shostakovichs-spacecraft-factory/cansat-2018-2019/research/serial-port-linux/uart-test/image.jpeg

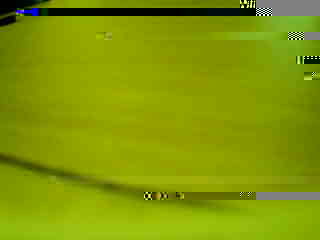
research/serial-port-linux/uart-test/image.jpeg
