shostakovichs-spacecraft-factory/cansat-2018-2019/doc/ПЗ-приложение-1-схемы.odt

СОГЛАСОВАНО | УТВЕРЖДАЮ
___________________________ | ___________________________
должность, головной исполнитель ОКР | должность, заказчик
___________________________ | ___________________________
подпись, инициалы, фамилия | подпись, инициалы, фамилия
«___»____________________ 20___г. | «___»____________________ 20___г.

СТРАТОСФЕРНЫЙ ЗОНД

СО СПЕКТРОМЕТРИЧЕСКОЙ УСТАНОВКОЙ

«ШМЕЛЬ»

Приложение к пояснительной записке 1

Принципиальные электрические схемы

Команда «ЗиКЮШ»

Данное приложение содержит принципиальные электрические схемы панелей разрабатываемого стратосферного зонда. В том числе:

- принципиальная электрическая схема панели 1. Camera Control Unit (рисунок 1)
- принципиальная электрическая схема панели 2. Interfacec Control Unit (рисунок 2)
- принципиальная электрическая схема панели 3. Power Control Unit (рисунок 3);
- принципиальная электрическая схема панели 4. Sensors Control Unit (рисунок 4).

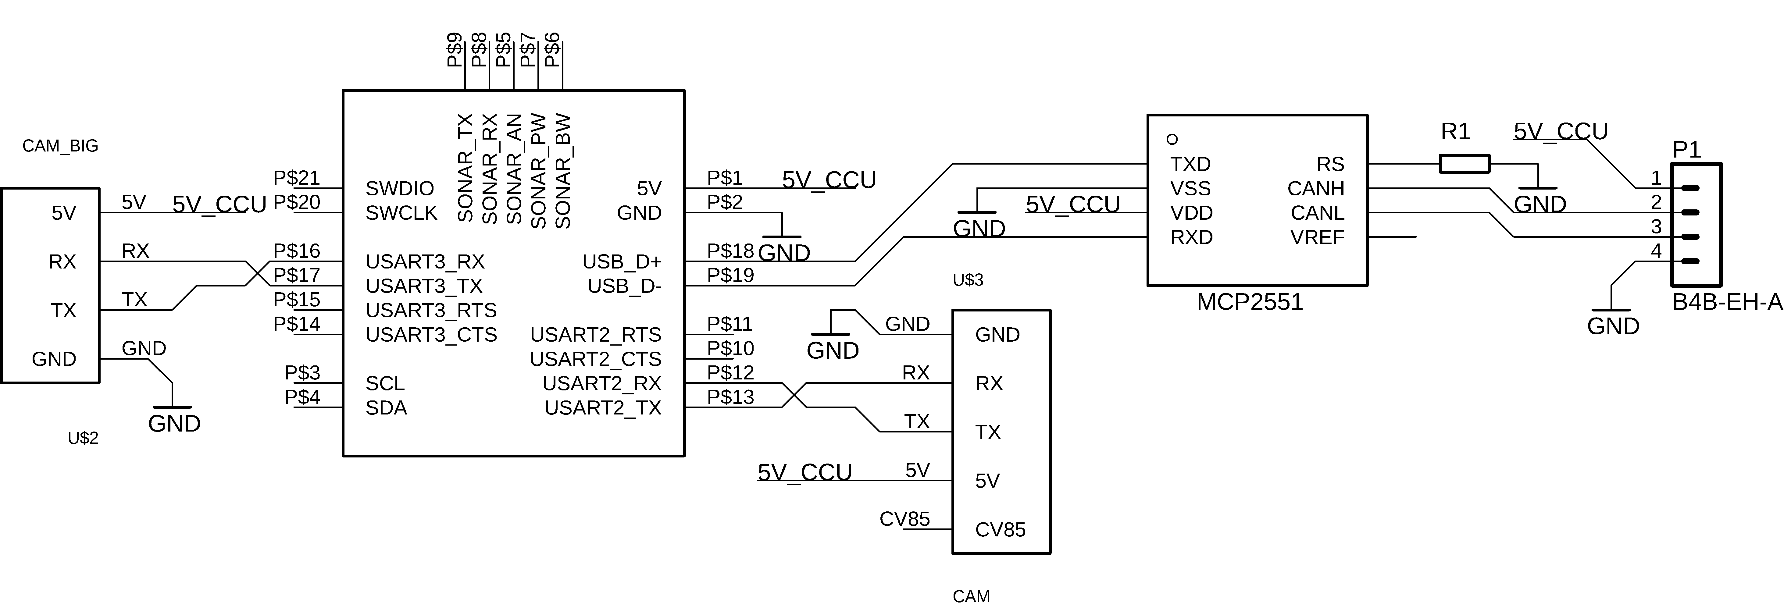
[picture p3: figure]

Рисунок 1. Принципиальная электрическая схема панели 1. Camera Control Unit (CCU).

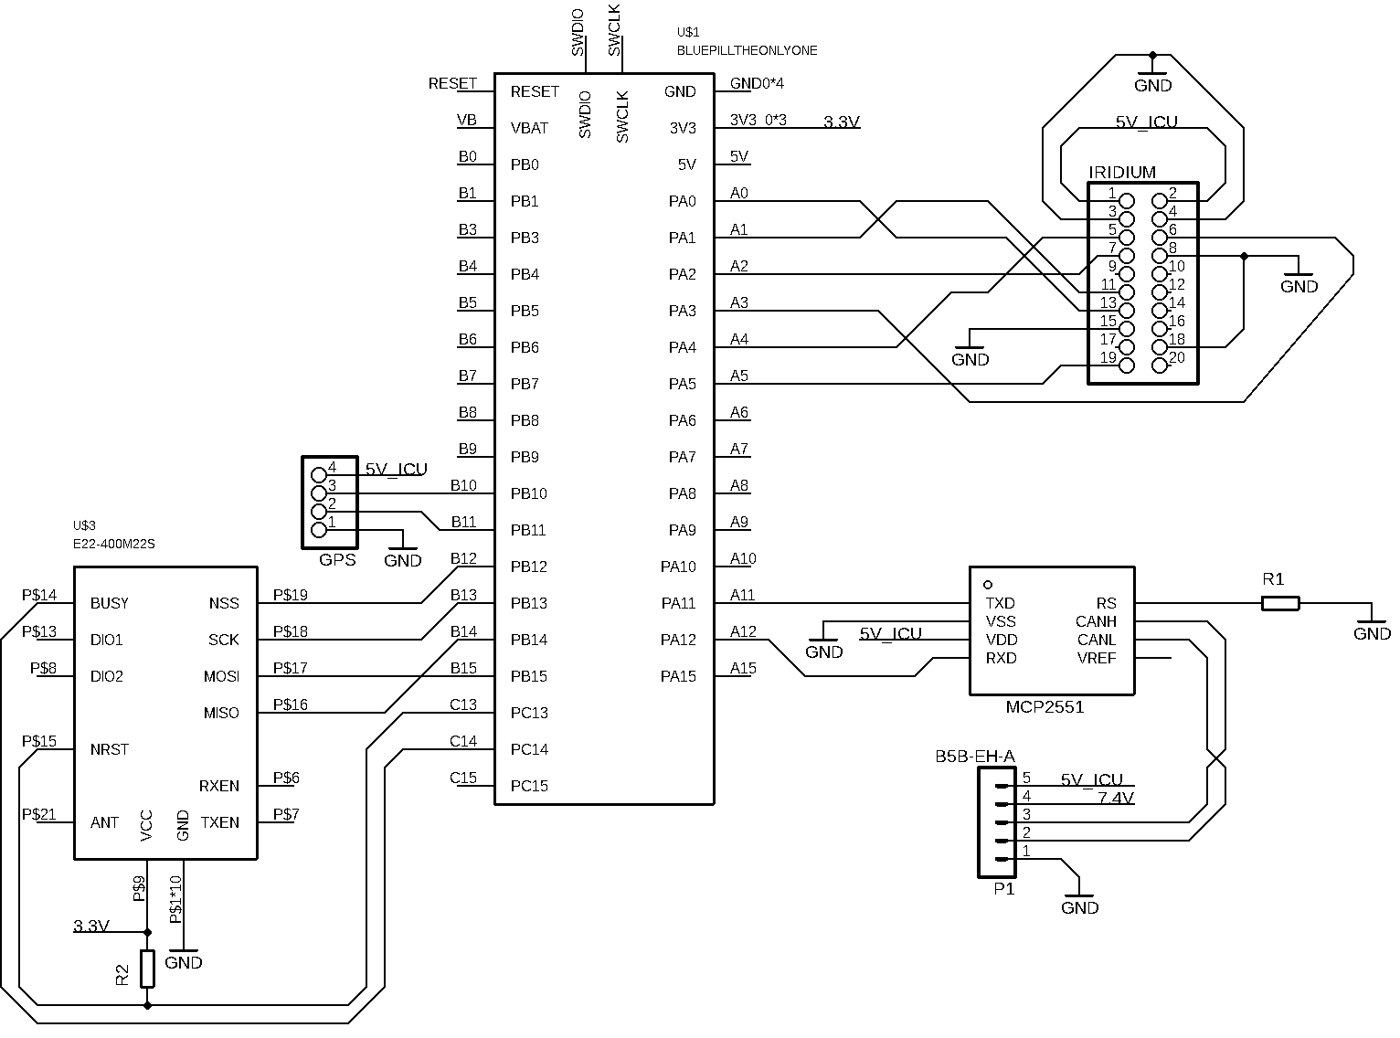
[picture p4: figure]

Рисунок 2. Принципиальная электрическая схема панели 2. Interface Control Unit (ICU).

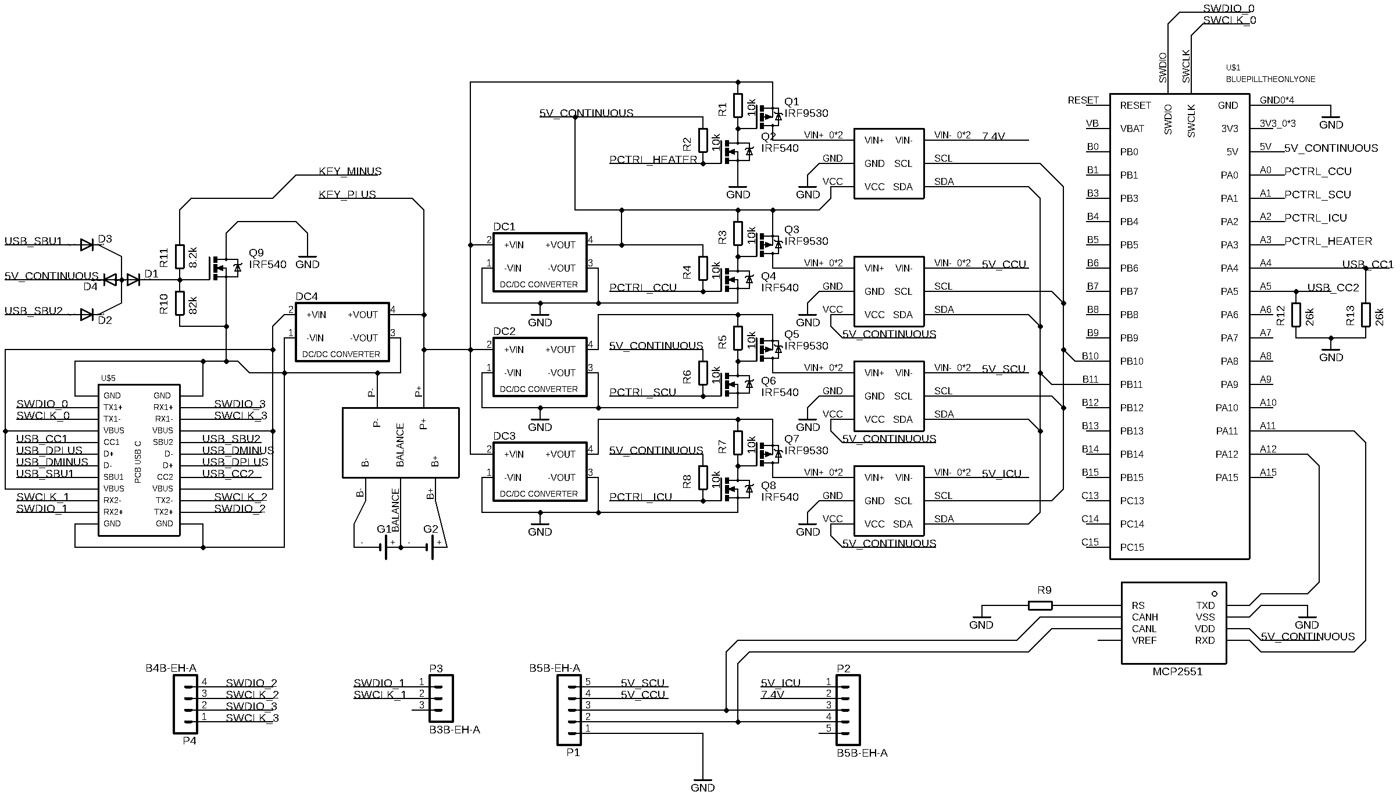
[picture p5: figure]

Рисунок 3. Принципиальная электрическая схема панели 3. Power Control Unit (PCU).

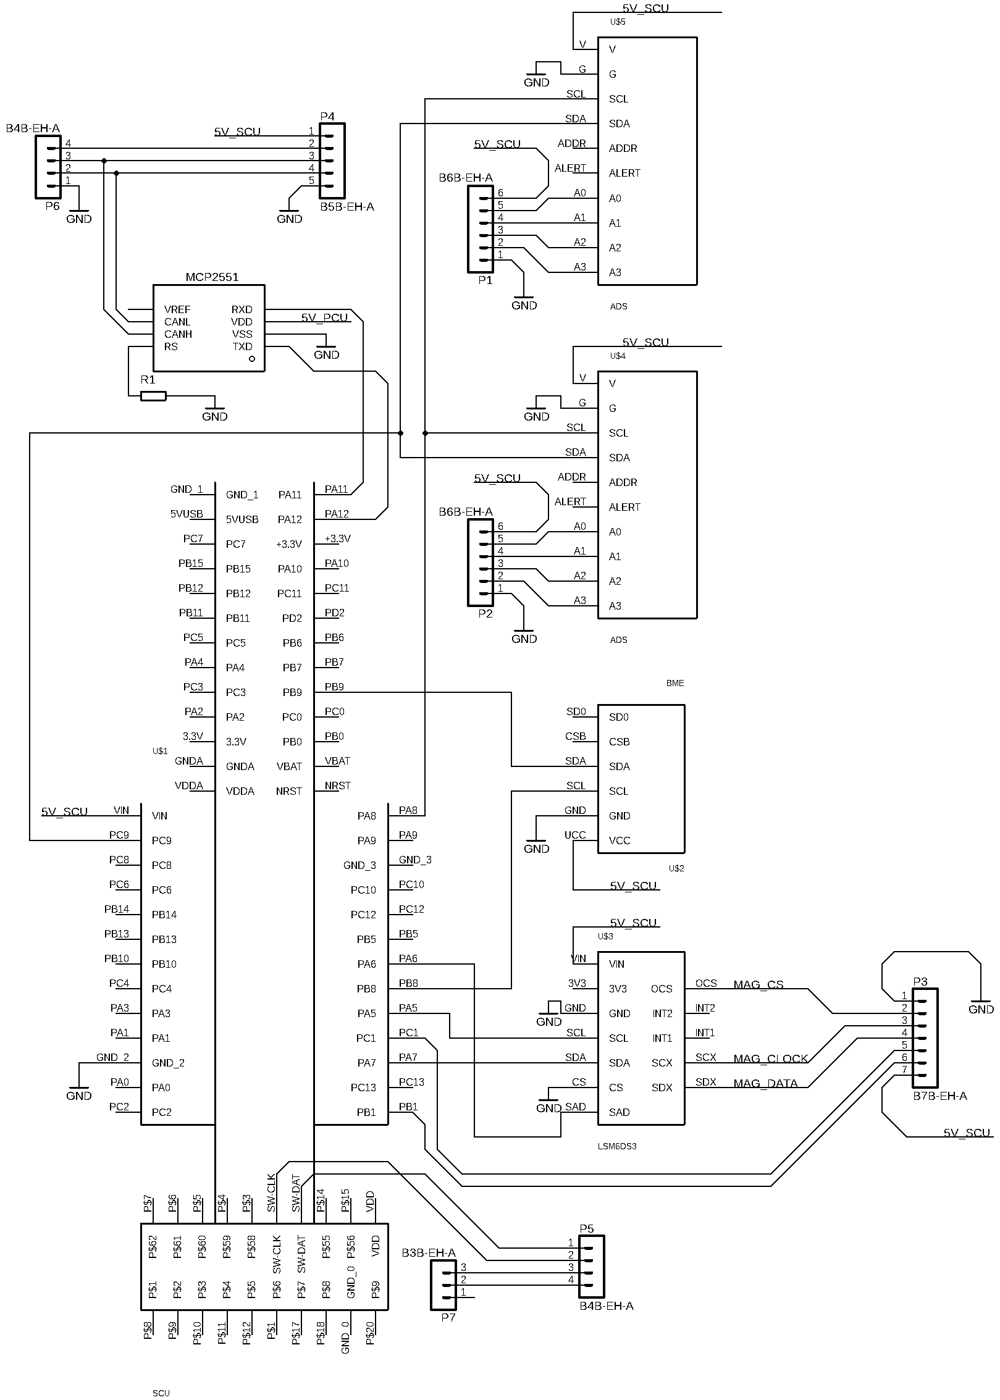
[picture p6: figure]

Рисунок 4. Принципиальная электрическая схема панели 4. Sesnsors Control Unit (SCU).
