shostakovichs-spacecraft-factory/cansat-2018-2019/doc/meetings/11.01.19.md

# Протокол совещания от 11.01.19 на тему чуть менее туманного будущего

**Начало: \~ 21:00**

**Окончание: 21:43**

### Присутствующие:

- Василий
- Сергей
- Антон
- Кирил

### Были подняты и обсуждены следующие вопросы:

- **Как обеспечить разделение приёмного и передающего трактор на нашем радиомодуле**

	Похоже в этом нет необходимости, так как мы неплохо можем жить используя радиомодуль на борту исключительно на передачу данных

- **Куратор Василий предоставил рыбу презентации**

	Кажется рыба очень даже ничего. Немножко поправили её по результатам обсуждений. Ну и закинули в гугл презентации для коллективной разработки по адресу `не скажу какому, потому что ссылка на редактиррование`

- **Как распределить слайды рыбы между разработчиками?**

	Было принято _решение_.

### По поднятым вопросам были приняты следующие решения:

- **Слайды между разработчиками распределены следующим образом**

	* Спектрометр

		Слайды 5, 6, 7 - Арина

	* Солнечный датчик

		Слайды 8, 9, 10 - Сергей

	* Прочие датчики

		Слайды 11, 12 - Кирилл

	* Структура

		Слайды 13, 14 - Василий

	* Электропитание

		Слайд 15 - Кирилл
		Слайд 16 - Арина

	* Конструкция

		Слайд 19 - Кирилл
		Слайды 20, 21, 22, 23, 24 - Антон

	* Наземная инфрастукрутура

		Слайд 25 - Кирил
		Слайд 26 - Сергей

	* Организационное
	
		Слайд 27 - Антон
		Слайд 28 - Отложен

- **Василий оформляет задачи на распредленные слайды как ишью на гитхабе**
	
	Собственно вот, распределяет
