shostakovichs-spacecraft-factory/cansat-2018-2019/doc/ТЗ-2018-2019-ЗОНД.odt

СОГЛАСОВАНО | УТВЕРЖДАЮ
____________________________________ | ____________________________________
должность, головной исполнитель ОКР | должность, заказчик
____________________________________ | ____________________________________
подпись, инициалы, фамилия | подпись, инициалы, фамилия
«___»____________________ 20___г. | «___»____________________ 20___г.

ТЕХНИЧЕСКОЕ ЗАДАНИЕ
НА СОСТАВНУЮ ЧАСТЬ ОПЫТНО-КОНСТРУКТОРСКОЙ РАБОТЫ

СТРАТОСФЕРНЫЙ ЗОНД ШМЕЛЬ

СЗ-1-ШМЕЛЬ

# Наименование, шифр СЧ ОКР, основание, исполнитель и сроки выполнения СЧ ОКР

  1. Разрабатываемый стратосферный зонд, являющийся частью стратосферной системы "Шмель" имеет одноимённое название с упомянутой системой.
  2. Шифр СЧ ОКР: "СЗ-1-ШМЕЛЬ".
  3. Основания для проведения СЧ ОКР.
    - положения конкурса "Воздушно-инженерная школа CanSat в России;
    - решение участников команды "Спутникостроительный завод имени композитора Юрия Шостаковича" об участии в конкурсе.
  1. Исполнитель - команда участников "Спутникостроительный завод имени композитора Юрия Шостаковича".
  2. Сроки выполнения СЧ ОКР распределены на несколько этапов согласно таблице 1.

Таблица 1. Этапы проведения СЧ ОКР.

№ | Наименования этапа | Срок окончания
1 | Разработка эскизного проекта | Январь 2019
2 | Разработка рабочего проекта | Март 2019
3 | Изготовление и проведение контрольных испытаний всех элементов разрабатываемой системы | Июнь 2019

# Цель выполнения СЧ ОКР, наименование и индекс изделия

  1. Целью составной части опытно-конструкторской работы (СЧ ОКР) является разработка стратосферного зонда. являющегося частью стратосферной исследовательской системы, предназначенной для выполнения исследовательских задач согласно регламенту конкурса "Воздушно-инженерная школа CanSat в России".
  2. Наименование изделия: Стратосферный исследовательский зонд "Шмель" (одноимённое название с системой). Далее "Шмель" или стратосферный зонд, или же зонд.
  3. Индекс изделия: 1.1.

# Технические требования к изделию.

## Состав изделия:

    - Бортовая цифровая вычислительная система
    - Бортовая измерительная аппаратура
    - Система энергоснабжения
    - Бортовой радиотехнический комплекс
    - Система поддержания микроклимата
    - Бортовая кабельная система
    - Полезная нагрузка

## Требования назначения:

    1. Разрабатываемый стратосферный зонд предназначен для решения следующих задач:
      - измерение распределения температуры и давления во время подъёма и спуска;
      - измерение трёх компонент ускорения во время полёта;
      - фотография Земли в период времени от 0 до 10 секунд после начала падения аппарата;
      - фиксация точки разрушения шара-зонда (координаты, высота, время);
      - фотофиксация неба в момент приземления;
      - передача зондом телеметрической информации с использованием прямого радиоканала на наземный измерительный пункт (НИП);
      - передача телеметрической информации зондом и приём входящих команд посредством глобальной спутниковой системы связи Iridium;
      - сбор показаний с инерциальных датчиков для последующего восстановления траектории полёта;
      - получение спектра поглощения атмосферы;
      - определение ориентации аппарата при помощи солнечного датчика.

## Требования радиоэлектронной защиты:

    1. Должна быть обеспечена совместимость радиоэлектронных средств, используемых в зонде.

## Требования живучести и стойкости к внешним воздействующим факторам.

    1. Требования к имитозащищенности
      1. Зонд должен удовлетворять следующим требованиям к имитозащищенности:
        - должна быть предусмотрена защита от несанкционированных команд, передаваемых на зонд при помощи системы iridium;
        - должна быть предусмотрена защита от различного рода помех при помощи таких механизмов, как контрольные суммы или помехозащищенное кодирование.
    1. Требования к устойчивости к климатическим воздействиям.
      1. К зонду в составе системы предоставляются следующие требования:
        - зонд должен выдерживать температуру внешней окружающей среды в диапазоне от -60 до +60 °C;
        - зонд должен выдерживать атмосферное давление в диапазоне от 1 кПа до 105 кПа;
        - зонд должен выдерживать подъем на высоту до 30 км относительно опорного эллипсоида WGS84 со скоростью от 4 до 7 м/с;
        - зонд должен выдержать посадку при скорости 5-8 м/c;
        - зонд должен иметь положительную плавучесть.
    1. Требования надёжности не предоставляются.

## Требования эргономики, обитаемости и технической эстетики.

    1. Зонд должен выглядеть приятно и быть раскрашен в цветовую схему насекомых рода Шмель (Bombus). Допускается отклонение от этого требования, если его выполнение не позволит выдержать требуемые характеристики изделия.

## Требования к эксплуатации, хранению, удобству технического обслуживания и ремонта.

    1. К зонду предоставляются следующие эксплуатационные требования:
      - зонд должен приводиться в готовность не дольше 1 часа;
      - конструкция зонда должна предусматривать возможность многократной неразрушающей разборки и последующей сборки в целях проведения локальных ремонтных работ.

## Требования к транспортабельности.

    1. К зонду предоставляются следующие требования:
      - зонд должен быть транспортабельным при помощи рюкзака объёмом не более 20 литров без потери функциональности. Это требование не распространяется на антенны.

## Требования безопасности.

    1. К зонду предоставляются следующие требования безопасности:
      - элементы зонда не должны предоставлять опасности для персонала и населения путём воздействия электрического напряжения, движущихся частей, теплового (светового) воздействия, высокочастотных, радиационных, электромагнитных полей, ядовитых паров и газов, вибраций, акустических шумов и др.;
      - элементы питания зонда должны быть снабжены соответствующими устройствами защиты от коротких замыканий и последующего возгорания;
      - конструкция зонда должна исключать самопроизвольное включение и выключение.

## Требования стандартизации.

    1. Требования стандартизации не предоставляются.

## Требования технологичности.

    1. Требования технологичности не предоставляются.

## Конструктивные требования

    1. Габариты зонда: не более 300x300x300 мм с учётом системы крепления троса;
    2. Масса зонда 750 – 1000 грамм;
    3. Аппараты закрепляются последовательно, создавая единую цепочку от шара-зонда, для этого у каждого аппарата должно быть крепление для фала (проушины) вверху и внизу аппарата;
    4. Крепление должно выдерживать на разрыв не менее 80кг, длина фала между аппаратами – 5 м, диаметр отверстия для фала – не менее 10мм;
    5. Требования к вибронагрузкам не предъявляются;

# Требования к обеспечению.

  1. Требования к нормативно-техническому обеспечению.
    1. Для разработки проекта должна быть использована система контроля версий.
  2. Требования к метрологическому обеспечению.
    1. Требования к метрологическому обеспечению не предоставляются.
  3. Требования к диагностическому обеспечению.
    1. Конструкция зонда должна предусматривать наличие клапана, совместимого с ГОСТ 8107-75 для подключения насоса для проведения проверок на герметичность корпуса;
  4. Требования к математическому, программному и информационно-лингвистическому обеспечению.
    1. Программное обеспечение, разрабатываемое для зонда должно быть разработано на языке программирования C.
    2. Приветствуется следование рекомендациям MISRA C.
    3. Вся телеметрическая информация, передаваемая аппаратом, должна сохраняться на внутреннем накопителе информации.

# Требования к консервации, упаковке и маркировке

  1. При необходимости, для зонда должна быть разработана упаковка, позволяющая осуществлять транспортировку и хранение с учётом предоставляемых к транспортировке требований.
  2. На корпусе зонда должна быть размещена табличка с координатами официального представителя команды "Завод имени композитора Юрия Шостаковича", с наименованием аппарата и кратким описанием в целях оповещения нашедшего аппарат.

# Требования к учебно-тренировочным средствам.

  1. При разработке зонда требуется создание автономных стендов для отработки отдельных узлов там, где это возможно.

# Непредоставляемые требования.

  1. Технико-экономические требования.
  2. Требования к каталогизации.
  3. Требования к сырью, материалам и КИМП.
  4. Специальные требования.

# Этапы выполнения СЧ ОКР.

  1. Выполнение СЧ ОКР разделено на несколько этапов согласно таблице 2. Подобное разделение основано на регламенте чемпионата "Воздушно-инженерная школа CanSat в России" [2].

Таблица 2. Этапы выполнения СЧ ОКР.

№ | Наименования этапа | Срок окончания
1 | Разработка эскизного проекта | Январь 2019
2 | Разработка рабочего проекта | Март 2019
3 | Изготовление и проведение контрольных испытаний всех элементов разрабатываемой системы | Июнь 2019

# Порядок выполнения этапов и приёмки СЧ ОКР.

  1. Для закрытия этапа эскизного проектирования, требуется выполнение следующих требований:
    1. Должна быть оформлена пояснительная записка;
    2. Должны быть разработаны трёхмерные модели элементов конструкции стратосферного зонда;
    3. Должна быть разработана принципиальная электрической схема аппарата;
    4. Должна быть создана презентация для устного доклада комиссии.
    5. В пояснительной записке должны быть отражены следующие позиции:
      - массовый расчёт;
      - расчёт энергобаланса;
      - расчёт стоимости комплектующих;
      - прочностной расчёт конструкции (допустимо отсутствие);
      - тепловой расчёт (допустимо отсутствие);
      - описание протоколов инофрмационно-логического взаимодействия элементов системы.
    1. Презентация должна включать:
      - описание научной задачи;
      - описание технической задачи;
      - план график;
      - бюджет проекта.
  1. Для закрытия этапа рабочего проекта должны быть выполнены следующие требования:
    1. Система должна быть полностью спроектирована с выпуском следующих документов:
      - Комплект чертежей конструкции системы (допустимо использование точных трёхмерных моделей);
      - Электрические принципиальные схемы и шаблоны для производства печатных плат, используемых в системе.
    1. Должна быть выпущена альфа версия программного обеспечения всех составных частей системы.
    2. Должны быть проведены автономные испытания элементов разрабатываемой системы.
  1. На финальный этап конкурса команда должна предоставить готовую к эксплуатации систему и принять участие в финале конкурса Воздушно-инженерная школа CanSat в России.

# Ссылочные документы

    - ГОСТ Р 55996- 2014
    - Положения конкурса воздушно инженерная школа CanSat в России 2018-2019 от 7.11.2018.

# Перечень сокращений:

    - КИМП — комплектующие изделия межотраслевого применения;
    - НИП - наземный измерительный пункт;
    - ОКР - опытно конструкторская работа;
    - СЧ - составная часть.

Со стороны исполнителей | Со стороны заказчика
______________________________________ должность, головной исполнитель ОКР | ______________________________________ должность, организация заказчика — разработчика ТЗ на ОКР
______________________________________ подпись, инициалы, фамилия | _________________________________ подпись, инициалы, фамилия
«___»____________________ 20___г. | «___»____________________ 20___г.
______________________________________ должность, головной исполнитель ОКР | ______________________________________ должность, организация заказчика — разработчика ТЗ на ОКР
______________________________________ подпись, инициалы, фамилия | _________________________________ подпись, инициалы, фамилия
«___»____________________ 20___г. | «___»____________________ 20___г.
______________________________________ должность, головной исполнитель ОКР | ______________________________________ должность, организация заказчика — разработчика ТЗ на ОКР
______________________________________ подпись, инициалы, фамилия | _________________________________ подпись, инициалы, фамилия
«___»____________________ 20___г. | «___»____________________ 20___г.
______________________________________ должность, головной исполнитель ОКР | ______________________________________ должность, организация заказчика — разработчика ТЗ на ОКР
______________________________________ подпись, инициалы, фамилия | _________________________________ подпись, инициалы, фамилия
«___»____________________ 20___г. | «___»____________________ 20___г.
