shostakovichs-spacecraft-factory/cansat-2018-2019/doc/ТЗ-2018-2019-НАЗЕМКА.odt

СОГЛАСОВАНО | УТВЕРЖДАЮ
____________________________________ | ____________________________________
должность, головной исполнитель ОКР | должность, заказчик
____________________________________ | ____________________________________
подпись, инициалы, фамилия | подпись, инициалы, фамилия
«___»____________________ 20___г. | «___»____________________ 20___г.

ТЕХНИЧЕСКОЕ ЗАДАНИЕ
НА СОСТАВНУЮ ЧАСТЬ ОПЫТНО-КОНСТРУКТОРСКОЙ РАБОТЫ

НАЗЕМНАЯ СТАНЦИЯ "БОМБИДАРИЙ"

СЗ-1-БОМБ

# Наименование, шифр СЧ ОКР, основание, исполнитель и сроки выполнения СЧ ОКР

  1. Разрабатываемая наземная станция, входящая в состав стратосферной исследовательской системы "ШМЕЛЬ" именуется "Бомбидарий".
  2. Шифр СЧ ОКР: "СЗ-1-БОМБ".
  3. Основания для проведения СЧ ОКР.
    - положения конкурса "Воздушно-инженерная школа CanSat в России;
    - решение участников команды "Спутникостроительный завод имени композитора Юрия Шостаковича" об участии в конкурсе.
  1. Исполнитель - команда участников "Спутникостроительный завод имени композитора Юрия Шостаковича".
  2. Сроки выполнения СЧ ОКР распределены на несколько этапов согласно таблице 1.

Таблица 1. Этапы проведения СЧ ОКР.

№ | Наименования этапа | Срок окончания
1 | Разработка эскизного проекта | Январь 2019
2 | Разработка рабочего проекта | Март 2019
3 | Изготовление и проведение контрольных испытаний всех элементов разрабатываемой системы | Июнь 2019

# Цель выполнения СЧ ОКР, наименование и индекс изделия

  1. Целью составной части опытно-конструкторской работы (СЧ ОКР) является разработка наземной приёмной станции в составе стратосферной исследовательской системы, предназначенной для выполнения исследовательских задач согласно регламенту конкурса "Воздушно-инженерная школа CanSat в России".
  2. Наименование изделия: Наземная приёмная станция стратосферной исследовательской система "Шмель". Далее "Бомбидарий", наземный измерительный пункт или приёмная станция.
  3. Индекс изделия: 1.2.

# Технические требования к изделию.

## Состав изделия:

    - Наземная станция, предназначенная для приёма и обработки телеметрии по радиоканалу;
    - Антенна Уда-Яги на диапазон 70 см (УКВ), имеет опцию установки на штативе. При наличии достаточных ресурсов, должна быть обеспечена автоматическая ориентация антенны.

## Требования назначения.

    1. Разрабатываемая наземная станция предназначена для решения следующих задач:
      - приём телеметрической информации, передаваемой стратосферным зондом в реальном времени;
      - накопление принятой телеметрической информации на внутреннем накопителе;
      - передача полученной по радиоканалу телеметрической информации ноутбуку оператора в реальном или близком к реальному времени;
      - передача телеметрической информации на ноутбук оператора должна осуществляться при помощи протоколов TCP или UDP поверх IP.

## Требования радиоэлектронной защиты.

    1. Должна быть обеспечена совместимость радиоэлектронных средств, используемых в системе.

## Требования живучести и стойкости к внешним воздействующим факторам.

    1. Требования к имитозащищенности
      1. Наземная станция должна удовлетворять следующим требованиям к имитозащищенности:
        - должна быть предусмотрена защита от различного рода помех при помощи таких механизмов, как контрольные суммы или помехозащищенное кодирование.
    1. К наземному измерительному пункту предоставляются следующие требования климатической устойчивости:
      - НИП должен функционировать в диапазоне температур от 0 °C до 85 °C при нормальном атмосферном давлении.
    1. Требования надёжности не предоставляются.

## Требования эргономики, обитаемости и технической эстетики.

    1. Требования не предоставляются.

## Требования к эксплуатации, хранению, удобству технического обслуживания и ремонта.

    1. К системе предоставляются следующие эксплуатационные требования:
      - система должна приводиться в готовность не дольше 1 часа;
      - элементы системы должны быть разборными и предусматривать возможность многократной неразрушающей разборки и последующей сборки в целях проведения локальных ремонтных работ.

## Требования к транспортабельности.

    1. К составным частям системы предоставляются следующие требования:
      - элементы системы должны быть транспортабельны при помощи рюкзака объёмом не более 20 литров без потери функциональности. Это требование не распространяется на антенны.

## Требования безопасности.

    1. К системе предоставляются следующие требования безопасности:
      - элементы системы не должны предоставлять опасности для персонала и населения путём воздействия электрического напряжения, движущихся частей, теплового (светового) воздействия, высокочастотных, радиационных, электромагнитных полей, ядовитых паров и газов, вибраций, акустических шумов и др.;
      - элементы питания системы должны быть снабжены соответствующими устройствами защиты от коротких замыканий и последующего возгорания;
      - конструкция элементов системы должна исключать самопроизвольное включение и выключение.

## Требования стандартизации.

    1. Наземный измерительный пункт должен обеспечивать приём телеметрии с других зондов, использующих аналогичную радиоаппаратуру.

## Требования технологичности.

    1. Требования технологичности не предоставляются.

## Конструктивные требования.

    1. Конструктивные требования не предоставляются.

# Требования к обеспечению.

  1. Требования к нормативно-техническому обеспечению.
    1. Для разработки проекта должна быть использована система контроля версий.
  2. Требования к метрологическому обеспечению не предоставляются.
  3. Требования к диагностическому обеспечению не предоставляются.
  4. Требования к математическому, программному и информационно-лингвистическому обеспечению.
    1. Вся принятая телеметрия должна сохраняться на внутренний накопитель информации приёмной станции.

# Требования к консервации, упаковке и маркировке

  1. Для элементов системы должна быть разработана упаковка, позволяющая осуществлять транспортировку и хранение с учётом предоставляемых к транспортировке требований.

# Требования к учебно-тренировочным средствам.

  1. При разработке системы требуется создание автономных стендов для отработки отдельных узлов там, где это возможно.

# Этапы выполнения ОКР

  1. Выполнение СЧ ОКР разделено на несколько этапов согласно таблице 2. Подобное разделение основано на регламенте регламенте чемпионата "Воздушно-инженерная школа CanSat в России" [2].

Таблица 2. Этапы выполнения ОКР.

№ | Наименования этапа | Срок окончания
1 | Разработка эскизного проекта | Январь 2019
2 | Разработка рабочего проекта | Март 2019
3 | Изготовление и проведение контрольных испытаний всех элементов разрабатываемой системы | Июнь 2019

# Порядок выполнения этапов и приёмки ОКР.

  1. Для закрытия этапа эскизного проектирования, требуется выполнение следующих требований:
    1. Должна быть оформлена пояснительная записка;
    2. Должна быть разработана принципиальная электрической схема наземной станции;
    3. Должна быть создана презентация для устного доклада комиссии;
    4. В пояснительной записке должны быть отражены следующие позиции:
      - описание протоколов информационно-логического взаимодействия элементов системы.
  1. Для закрытия этапа рабочего проекта должны быть выполнены следующие требования:
    1. Система должна быть полностью спроектирована с выпуском следующих документов:
      - Комплект чертежей конструкции СЧ (допустимо использование точных трёхмерных моделей);
      - Электрические принципиальные схемы и шаблоны для производства печатных плат, используемых в наземной станции.
    1. Должна быть выпущена альфа версия программного обеспечения наземной станции.
    2. Должны быть проведены автономные испытания СЧ.
  1. На финальный этап конкурса команда должна предоставить готовую к эксплуатации СЧ в составе системы и принять участие в финале конкурса Воздушно-инженерная школа CanSat в России.

# Непредоставляемые требования.

  1. Технико-экономические требования.
  2. Требования к каталогизации.
  3. Требования к сырью, материалам и КИМП.
  4. Специальные требования.

# Ссылочные документы

    - ГОСТ Р 55996- 2014
    - Положения конкурса воздушно инженерная школа CanSat в России 2018-2019 от 7.11.2018.

# Перечень сокращений:

    - КИМП — комплектующие изделия межотраслевого применения;
    - НИП — наземный измерительный пункт;
    - ОКР — опытно конструкторская работа;
    - СЧ — структурная часть;
    - IP — internet protocol;
    - TCP — transport control protocol;
    - UDP — user datagram protocol.

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
