shostakovichs-spacecraft-factory/cansat-2018-2019/doc/ТЗ-2018-2019-СЕРВЕР.odt

СОГЛАСОВАНО | УТВЕРЖДАЮ
____________________________________ | ____________________________________
должность, головной исполнитель ОКР | должность, заказчик
____________________________________ | ____________________________________
подпись, инициалы, фамилия | подпись, инициалы, фамилия
«___»____________________ 20___г. | «___»____________________ 20___г.

ТЕХНИЧЕСКОЕ ЗАДАНИЕ
НА СОСТАВНУЮ ЧАСТЬ ОПЫТНО-КОНСТРУКТОРСКОЙ РАБОТЫ

ПО СЕРВЕРА

СЗ-1-ПО-СРВ

# Введение.

  1. Разрабатываемое программное обеспечение предназначено для использования на сервере-ретрансляторе в составе стратосферной исследовательской системы "Шмель". Наименование разрабатываемого ПО должно быть выбрано до завершения этапа рабочего проекта.
  2. Разрабатываемое ПО предназначено для взаимодействия с интернет-шлюзом системы Iridium в части приёма телеметрии передаваемой стратосферным зондом и передачи управляющих команд на него.

# Основания для разработки.

  1. Основания для проведения СЧ ОКР.
    - положения конкурса "Воздушно-инженерная школа CanSat в России;
    - решение участников команды "Спутникостроительный завод имени композитора Юрия Шостаковича" об участии в конкурсе.
  1. Исполнитель - команда участников "Спутникостроительный завод имени композитора Юрия Шостаковича".
  2. Сроки выполнения СЧ ОКР распределены на несколько этапов согласно таблице 1.
2. Таблица 1. Этапы проведения СЧ ОКР.

№ | Наименования этапа | Срок окончания
1 | Разработка эскизного проекта | Январь 2019
2 | Разработка рабочего проекта | Март 2019
3 | Изготовление и проведение контрольных испытаний всех элементов разрабатываемой системы | Июнь 2019

# Назначение разработки.

  1. Разрабатываемое ПО предназначено для взаимодействие с интернет-шлюзом системы Iridium в части получения телеметрической информации и передачи управляющих воздействий стратосферному зонду в составе системы.
  2. Разрабатываемое ПО предполагается к использованию на виртуальном частном сервере в сети Интернет с выделенным IPv4 адресом.
  3. ПО не предполагает наличие оператора и должно функционировать в высокоавтоматизированном режиме с привлечением оператора только при возникновении нештатных ситуаций.

# Требования к программному продукту.

## Требования к функциональным характеристикам.

    1. Разрабатываемое ПО должно обеспечивать выполнение следующих функций:
      - Приём телеметрической информации, поступающей от стратосферного зонда через интернет-шлюз системы Iridium;
      - Передача управляющих воздействий на зонд через интернет-шлюз системы Iridium;
      - Накопление и архивирование как поступающей телеметрии, так и исходящих управляющих воздействий;
      - Экспорт накопленных данных в формате .csv файлов.

## Требования к надёжности.

    1. Разрабатываемое программное обеспечение должно быть спроектировано таким образом, чтобы никакая ошибка или отказ не являлись причиной потери работоспособности системой в целом.
    2. Подсистема накопления телеметрии должна быть спроектирована так, чтобы исключить возможность потери архива в целом из-за программной ошибки.
    3. Восстановление полной работоспособности ПО после сбоя должно быть производимо в течение 20-ти секунд.

## Условия эксплуатации.

    1. ПО должно быть спроектировано независимым от климатических условий эксплуатации.
    2. ПО, во всех штатных ситуациях должно быть работоспособно без наличия оператора.

## Требования к составу и параметрам технических средств.

    1. ПО устанавливается на виртуальный частный сервер. Далее приведены характеристики сервера, при которых ПО должно работать корректно:
      - Процессор: не хуже 1 ядро на 2.2GHz;
      - Объем оперативной памяти: не менее 1 гигабайт;
      - Объем персистентного накопителя: не менее 20 гигабайт;
      - Скорость доступа к персистентому накопителю - не менее 300мбит/с;
      - Наличие доступа в интернет с выделенным IPv4 адресом.

## Требования к информационной и программной совместимости.

    1. Программное обеспечение должно быть выпущено на следующие программные платформы:
      - GNU/Linux Debian 9 (Stretch).
    1. Приветствуется использование кроссплатформенных инструментов разработки.

## Требования к маркировке и упаковке.

    1. Приветствуется использование установочных пакетов для распространения разработанного ПО.

## Требование к транспортировке и хранению.

    1. Требования не предоставляются.

## Специальные требования.

    1. требования не предоставляются.

# Требования к программной документации.

  1. Документация к программным кодам должна быть оформлена в виде комментариев. Допускается формирование дополнительных документов в формате Markdown. Приветствуется использование автоматических генераторов документации (doxygen, pydoc и прочие).

# Технико-экономические показатели.

  1. ПО должно обладать лучшими характеристиками по сравнению с отечественными и зарубежными аналогами.
  2. Разработка данного ПО не подразумевает дополнительных расходов. Использование рабского труда не допускается.

# Стадии и этапы разработки.

  1. Выполнение СЧ ОКР разделено на несколько этапов согласно таблице 2. Подобное разделение основано на регламенте чемпионата "воздушно-инженерная школа CanSat в России" [2].

Таблица 2. Этапы выполнения ОКР.

№ | Наименования этапа | Срок окончания
1 | Разработка эскизного проекта | Январь 2019
2 | Разработка рабочего проекта | Март 2019
3 | Изготовление и проведение контрольных испытаний всех элементов разрабатываемой системы | Июнь 2019

# Порядок контроля и приёмки.

  1. Для закрытия этапа эскизного проектирования, требуется выполнение следующих требований:
    1. Должна быть оформлена пояснительная записка;
    2. Должна быть создана презентация для устного доклада комиссии.
    3. В пояснительной записке должны быть отражены следующие позиции:
      - описание протоколов информационно-логического взаимодействия элементов системы.
  1. Для закрытия этапа рабочего проекта должны быть выполнены следующие требования:
    1. Должна быть выпущена альфа версия программного обеспечения СЧ.
    2. Должны быть проведены автономные испытания СЧ.
  2. На финальный этап конкурса команда должна предоставить готовую к эксплуатации СЧ в составе системы и принять участие в финале конкурса Воздушно-инженерная школа CanSat в России.

# Ссылочные документы.

    - ГОСТ Р 55996- 2014
    - Положения конкурса воздушно инженерная школа CanSat в России 2018-2019 от 7.11.2018.

# Перечень сокращений.

    - НИП - наземный измерительный пункт;
    - ОКР - опытно конструкторская работа;
    - СЧ - составная часть;
    - ПО - программное обеспечение.

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
