shostakovichs-spacecraft-factory/cansat-2018-2019/doc/schemes/electronics_scheme.png

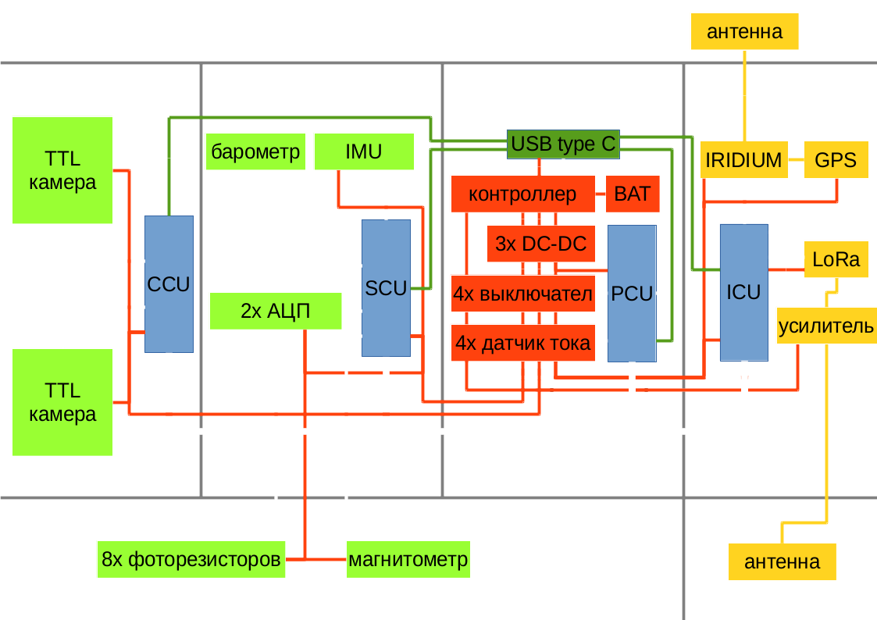
doc/schemes/electronics_scheme.png
