shostakovichs-spacecraft-factory/cansat-2018-2019/doc/schemes/electronics_scheme_black.png

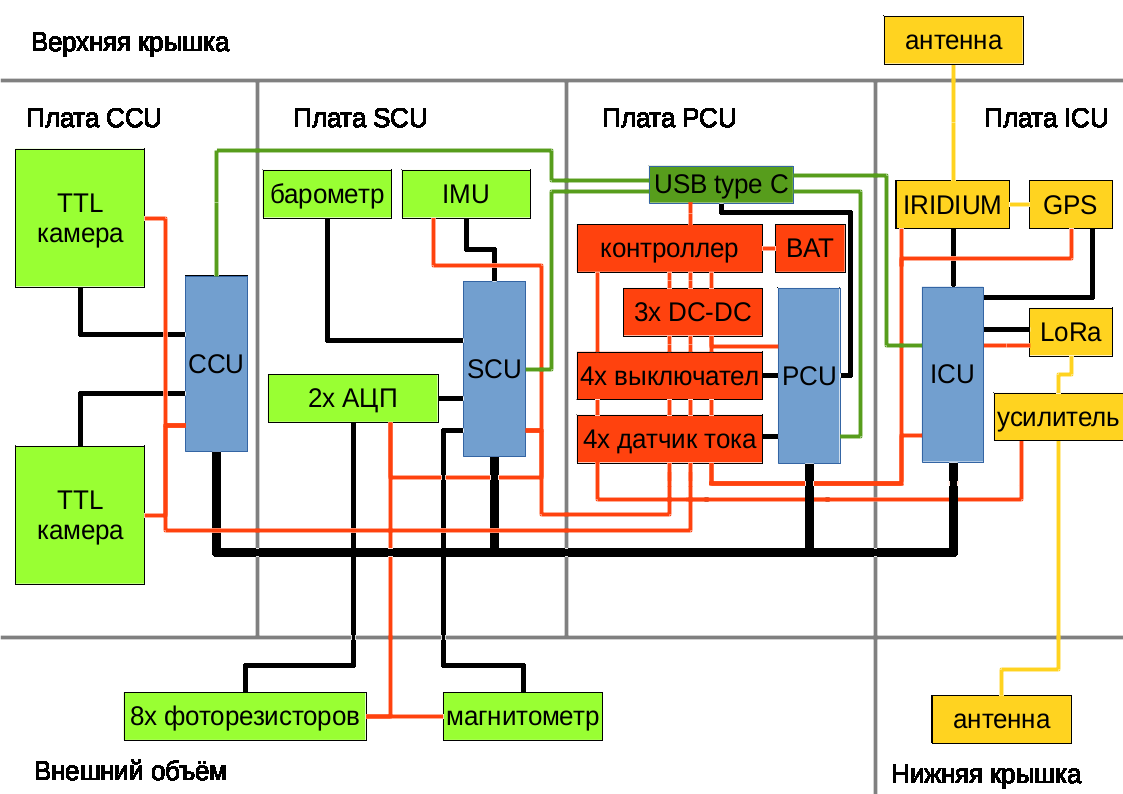
doc/schemes/electronics_scheme_black.png
