shostakovichs-spacecraft-factory/cansat-2018-2019/doc/schemes/Схема соединений.png

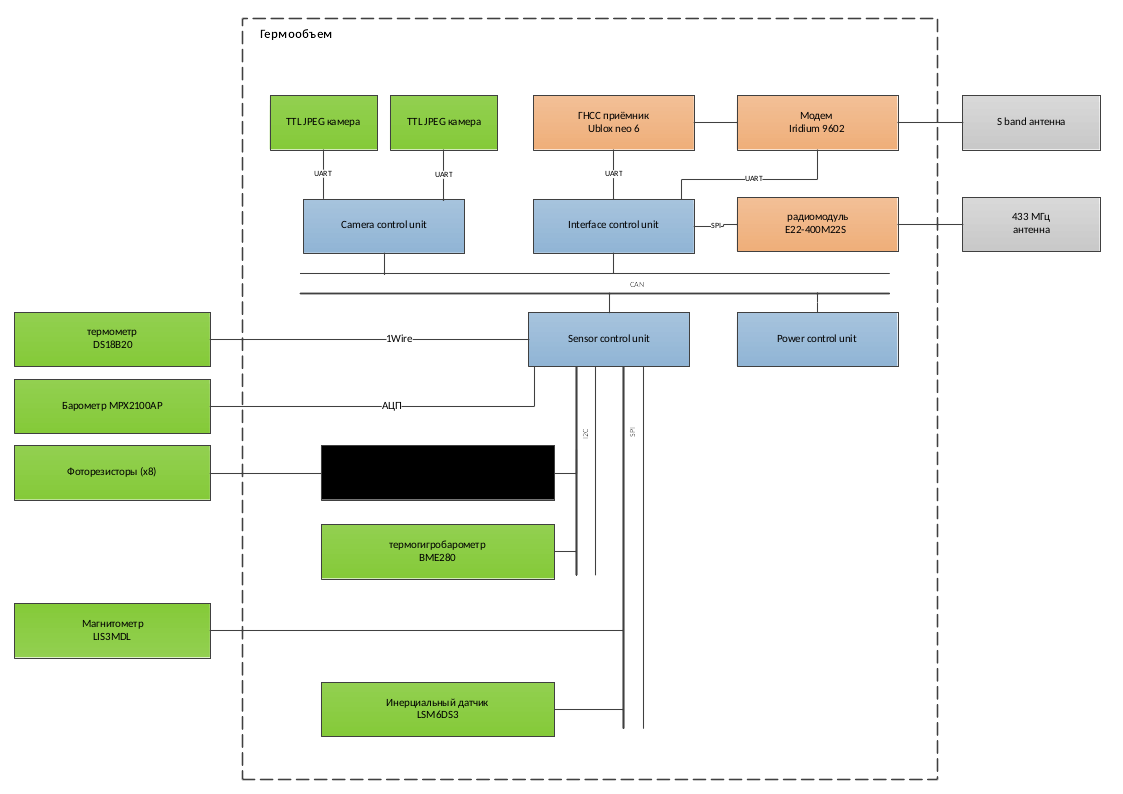
doc/schemes/Схема соединений.png
