shostakovichs-spacecraft-factory/cansat-2018-2019/research/Madgwick/dump-processor/theplane.stl

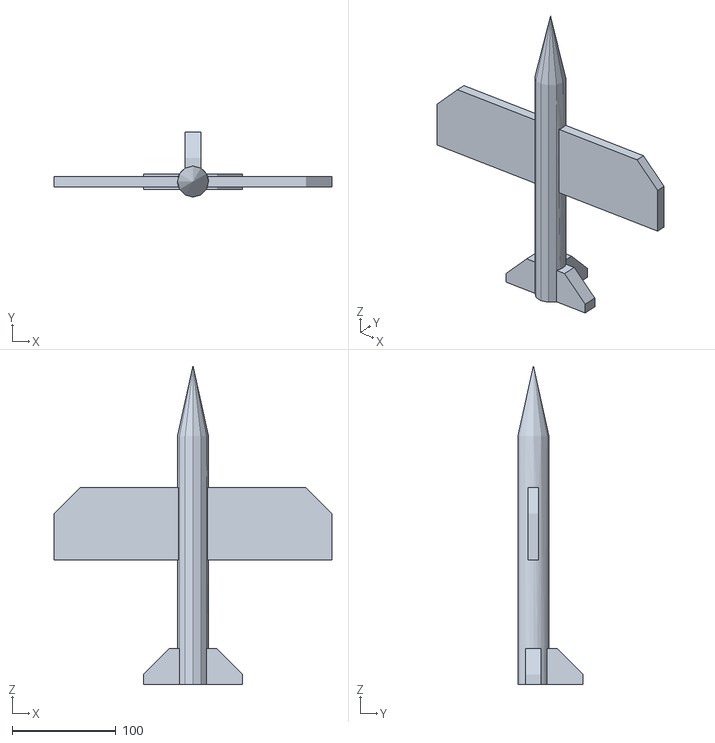
[picture p10: CAD file, 2018-11-16]
research/Madgwick/dump-processor/theplane.stl
268.3 x 63.0 x 308.0
