shostakovichs-spacecraft-factory/cansat-2018-2019/src/ground/grain-server/webapp/static/cansat.stl

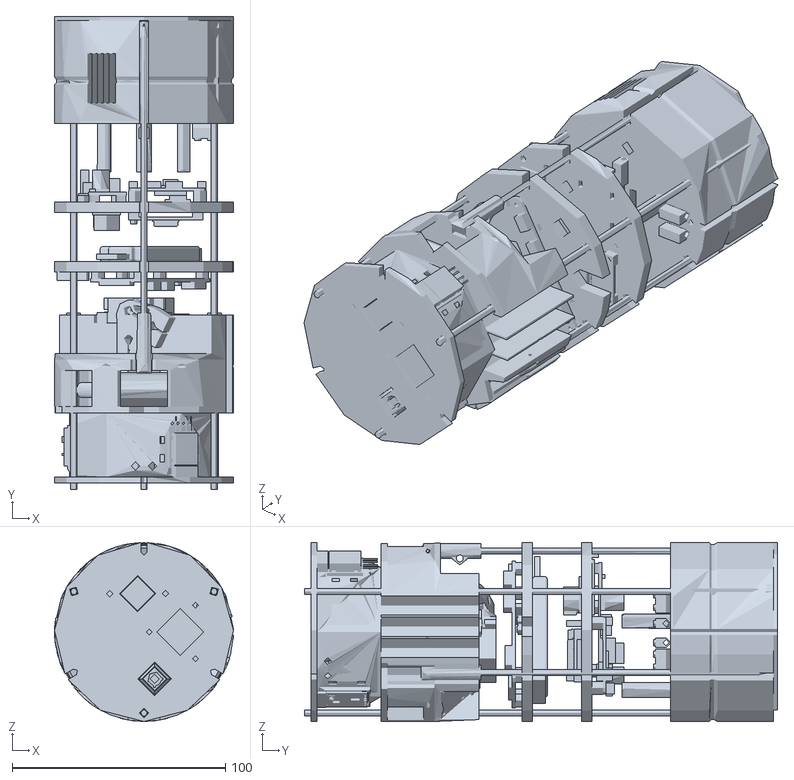
[picture p11: CAD file, 2019-06-01]
src/ground/grain-server/webapp/static/cansat.stl
84.0 x 222.0 x 84.0
