shostakovichs-spacecraft-factory/cansat-2018-2019/src/ground/grain-server/webapp/static/rocket.stl

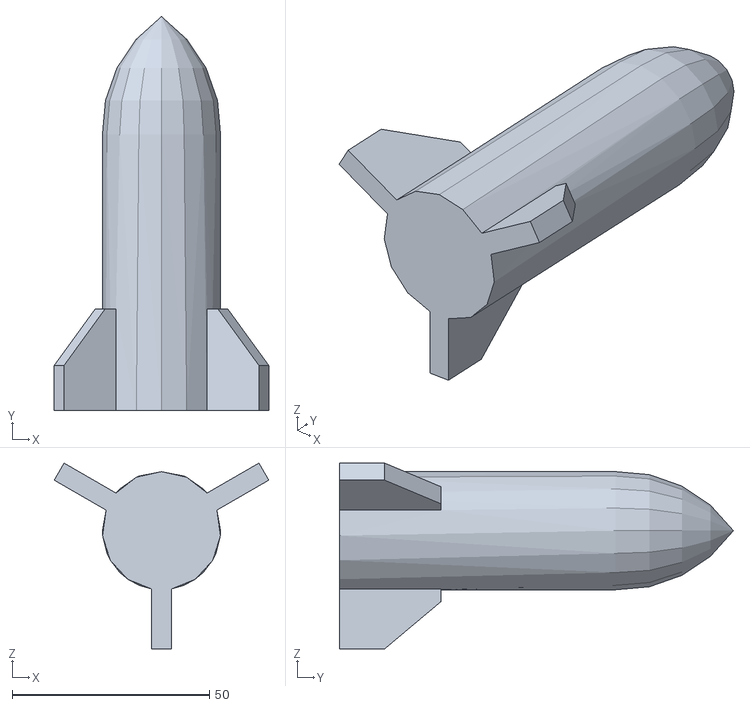
[picture p12: CAD file, 2019-06-01]
src/ground/grain-server/webapp/static/rocket.stl
54.5 x 100.0 x 47.2
