shostakovichs-spacecraft-factory/cansat-2018-2019/(threads)

Thread 1 (2018-09-05):

Название команды

Snork2, 2018-09-05:
Нужно придумать название команде (и нарисовать лого?)

macJIuHa, 2018-09-06:
В принципе, поскольку этот состав команды участвует только один год, её можно назвать по основной цели проекта.

Snork2, 2018-11-29:
Решено

Closed 2018-11-29.

Thread 2 (2018-09-05):

Формирование вопросов по регламенту и стратосферному полёту.

Snork2, 2018-09-05:
Информация из текущего регламента (http://roscansat.com/uchastnikam/polozhenie/) сильно отличается от фактического положения вещей, которые мы видели на полигоне.

Так же ожидается встреча с организаторами, к которой нужно бы подготовить список общих вопросов по стратосферному полёту: (на что обратить внимания, какая система терморегулирования предпочтительнее и т.п.)

macJIuHa, 2018-09-06:
Можно ли использовать маховики?
Какая гарантированная высота полёта?
Какая максимальная мощность передатчика?

Snork2, 2018-09-08:
Какова прочность аппарата на разрыв?
Можно ли использовать баллоны высокого давления?

Snork2, 2018-09-08:
На каких высотах мы можем рассчитывать на более менее спокойный полет, во время которого сможем ориентировать зонд. И сколько он будет длиться?

Гарантируется ли пуск днем?

Насколько вероятен конденсат на оптических элементах зонда и насколько сильно он испортит нам жизнь?

SeresHotes, 2018-09-09:
Какие температурные изменения будет испытывать аппарат?

macJIuHa, 2018-09-09:
Температурные изменения будут зависеть от условий стратосферы. Самое минимальное -- -50С. Проблема в том, что дальше нас начнёт печь солнце, но с этим можно попытаться справиться при помощи фольги

Snork2, 2018-09-15:
Итоговый список вопросов:

1. Какой способ крепления аппарата к шару?
2. На какое расстояние разнесены аппараты?
3. Какие нагрузки необходимо выдерживать креплению
4. Какие требования к форме и размеру крепления
5. Можно ли использовать маховики?
6. Какая максимальная мощность радиопередатчика?
7. Гарантируется ли пуск днем?
8. Какие предполагаемые скорости спуска и подъема?
9. Можно ли использовать баллоны со сжатым газом?

Closed 2018-09-15.

Thread 3 (2018-09-05):

Выбор радиомодуля.

Snork2, 2018-09-05:
Какой бы ни была миссия аппарата, нам нужно выбрать мощный радиомодуль, чтобы иметь хоть какой-то приём телеметрии.

Возможно их будет несколько? Использовать ли сотовый/спутниковый модем?

macJIuHa, 2018-09-06:
Предлагаю в любом случае отправлять SMS с координатами. Даже если кто-то из грозди это тоже сделает, лучше перестраховаться.

Snork2, 2018-09-08:
Рассматриваем иридиум и модем.
Используем модем как модем? или отправляем смски? или и то и другое?

Snork2, 2018-09-08:
По результатам обсуждения вопрос свелся к выбору диапазона и усилителя соответствующего диапазона. Так же вопрос с иридиумом вынес в отдельную задачу #5

Snork2, 2018-11-29:
Решено

Closed 2018-11-29.

Thread 4 (2018-09-06):

Лицензия проекта

Snork2, 2018-09-06:
Довольно важный вопрос. Сейчас репозиторий создан с довольно мягкой MIT лицензией. Можно оставить так, а можно сделать что-нибудь другое. Например BSD 4 clause

Snork2, 2018-09-14:
За отсутствием других мнений - будет MIT

Closed 2018-09-14.

Thread 5 (2018-09-08):

Иридиум

Snork2, 2018-09-08:
Нужно связаться с местным дистрибьютором иридиума и узнать стоймость и условия получения обучающего канала. У нас есть команда, которая имеет успешный опыт применения

Snork2, 2018-11-29:
Решено

Closed 2018-11-29.

Thread 7 (2018-09-08):

Обзор AHRS алгоритмов

Snork2, 2018-09-08:
Похоже, что какую бы мы задачу не выбрали, нам нужна способность определять ориентацию аппарата. Для этого хорошо подходят AHRS алгоритмы. Нам уже знаком алгоритм Маджвика, однако нам так и не удалось его "настроить".

Имеет смысл посмотреть какие еще есть алгоритмы. Возможно стоит взять алгоритм с какого-нибудь дрона, так как дроны отлично решают задачи ориентации.

Thread 10 (2018-09-14):

Ориентация аппарата

Snork2, 2018-09-14:
Уже понятно что её нужно будет считать и возможно на борту

* Используем ли активное управление ориентацией?
* Какие актуаторы используем для управления ориентацией?

macJIuHa, 2018-09-16:
Скорее всего управляем ориентацией, зацепившись за трос
А ориентироваться я предлагаю не по показателям акселерометра/гироскопа, а по датчикам освещённости

Snork2, 2018-11-29:
Решено

Closed 2018-11-29.

Thread 8 (2018-09-14):

Выбор типа корпуса

Snork2, 2018-09-14:
* Открытый или герметичный?
* Расчет прочности
* Тепловой расчет

Snork2, 2018-09-14:
В этот же вопрос поставим физику стратосферы.
Пока что у нас есть актуальный вопрос:

 * расчет точки росы

Thread 15 (2018-12-01):

Формирование ТЗ на аппарат и научный проект

SeresHotes, 2018-12-01:

Snork2, 2018-12-11:
Наиболее интересные документы по теме:
https://pdf.standartgost.ru/catalog/Data2/1/4293772/4293772029.pdf

Snork2, 2019-01-16:
Тз разбилось на кусочки: 2b52c6d0b880e76afe65e6e013596cadece21f3a

SeresHotes, 2019-02-09:
Готово!

Closed 2019-02-09.

Thread 18 (2018-12-28):

Написать описание протоколов, используемых в разрабатываемой системе

Snork2, 2018-12-28:
По текущей версии документа (по состоянию на 124587e6b28e8e00db5c367e30e6984616aaf11b) есть ряд замечаний и рекомендаций.

### 1. Рекомендации

#### 1.1 По структуре документа.

Учитывай, что люди, которые читают его - первый раз видят все что написано и не имеют никакущего представления о том, как построена наша система. Поэтому в начале следует описать её полностью с самого начала и сверху вниз.

Начинаем с самого верхнего уровня: в системе есть несколько .... не знаю как это назвать? элементы? локации? агрегаты? Подумай... Короче в системе зонд, сервер, обменная машина (raspberry pi) и ноут в качестве автоматизированного рабочего места оператора. Кратко описываем каждый агрегат. Какие задачи решает, зачем нужен. В этом же разделе и твоя картинка.

Продолжаем - в системе определено понятие терминала - физического устройства, которое физически соединено с прочими устройствами различными шинами/интерфейсами и способно передавать/принимать сообщения от других терминалов. Перечисляем терминалы (ICU, PCU, RPI, ноут и прочие), так же кратко описываем - что из себя представляет, какие задачи решает. Так же в этом разделе следует описать какой терминал с каким общается и при помощи какого протокола низшего уровня (TCP/UDP/CAN и прочее).

Ну и наконец - в системе определены логические абоненты. Абоненты это такие логические штуки, которые существуют только виртуально и сидят в терминалах. Абоненты общаются между собой при помощи преимущественно MAVLINK-а, который проходит поверх протоколов которыми общаются терминалы. Снова перечисляем абонентов. Говорим на каком терминале они сидят, что из себя представляют, какие задачи решают. Можно для каждого абонента кратко написать какими данными, передаваемыми другими абонентами они интересуются.

Вот и все что следует написать на мой взгляд. Углубляться в перечень CAN-овских идентификаторов и MAVLINK сообщений не нужно. Во-первых не успеем, а во вторых - эскизный проект этого и не подразумевает. Можно прямо так и написать, что, например, `перечень идентификаторов CAN сообщений передаваемых терминалами определяется на этапе рабочего проекта`.

#### 1.2. По оформлению

1.2.1. Все картинки с номерами и в тексте ссылки на них. Делаем чуток по-взрослому.

1.2.2. Все аббревиатуры должны быть развернуты в скобочках или еще как-то при первом упоминании и в конце должна быть страничка со списком сокращений.

1.2.3. Если упоминается какая-то посторонняя сущность - на нее хорошо бы сослаться. Например у нас используется CAN 2.0B (ISO 11898). Есть целая куча доков и стандарт с описанием этого CAN-а. Просто сошлись на эти доки и все: протокол описан. Тоже самое с мавлинками, уартами и прочей радостью. В конце документа страничка со ссылочной документаций, А в тексте ссылки-номера в виде [1], [2], [3] и так далее.

### 2. Замечания

Тут уже просто конкретные замечания по тексту.

2.1. Space shuttle на картинке - лишнее. У нас не шатл и не спейс. Ну и документ на русском, подписи/надписи тоже следует делать на русском (это я сейчас про ground station). При этом названия модулей имхо на енге можно - названия это авторское.

2.2. Продолжая тему схемы - сервер представлен простым квадратиком, тогда как остальные элементы системы - большими рамочками. Это вводит некоторый диссонанс. Сервер тоже следует сделать рамочкой. Внутри можно нарисовать системную службу взаимодействия с иридиумом и БД для хранения телеметрии. Рисовать можно какими-нибудь параллелепипедами или сильно другим цветом, чтобы показать это ПО а не железки.

2.3. Для иридиума хорошо бы нарисовать связь между модемом и сервером через спутник (прям картинкой вставить).

2.4. по второму абзацу - LORA это, строго говоря не протокол. Это вид модуляции. Протокол там какой-то есть, и он вроде описан в доках, но названия своего не имеет. Можно написать как, например, `определяемый производителем радиомодуля
протокол` и сослаться на доку к модулю.

2.5.  Шестой абзац - `Данные на компьютерах аппарата ...`. Лучше перефразировать как `данные, передаваемые компьютерами аппарата будут передаваться при помощи пакетов протокола MAVLINK (ссылка на описание)`. Строка про идентификатор - лишняя. Протокол это (и многое другое) определяет сам по себе.

SeresHotes, 2018-12-29:
Готова абсолютно новая версия. Прошу проверить.

Snork2, 2018-12-30:
Хорошо. Немножко поправил орфографию (f27f20f). Осталось одно замечание - не написано на каких терминалах находятся абоненты. Это необходимо указать, иначе не понятно откуда они вообще взялись

Closed 2019-01-06.

Thread 20 (2019-01-06):

Разработка принципиальной электрической схемы "надирного" этажа

Snork2, 2019-01-06:
Собственно говоря в 13189081d6ef22f78fe9e7f3600d91a50d7c8658 уже есть прототип этой платы, но

1. IRF540n не подходят в качестве первого плеча нашего _транзисторного ключа_. Они едва приоткрываются на 3.3 вольтах.
2. INA219 не двухканальная. Просто у нее выводе продублированы на плате. Нужно исправить элемент

Thread 22 (2019-01-11):

Создание презентации ein

Snork2, 2019-01-11:
Разделяем #19 на задачи для отдельных участников согласно протоколу совещания от 79c2f729dac94fe4840709d5f5db29613ffb478f

Эта долька для Антона! Тебе достались слайды:

* 20
* 21
* 22
* 23
* 24
* 27

SeresHotes, 2019-02-09:
Готово!

Closed 2019-02-09.

Thread 23 (2019-01-11):

Создание презентации zwei

Snork2, 2019-01-11:
Разделяем #19 на задачи для отдельных участников согласно протоколу совещания от 79c2f729dac94fe4840709d5f5db29613ffb478f

Эта долька для Кирилла! Тебе достались слайды:

* 11
* 12
* 15
* 19
* 25

Kirs67, 2019-02-09:
Закрываем-с ишью по презентации?

Kirs67, 2019-02-09:
Презентация прошла успешно

Closed 2019-02-09.

Thread 24 (2019-01-11):

Создание презентации drei

Snork2, 2019-01-11:
Разделяем #19 на задачи для отдельных участников согласно протоколу совещания от 79c2f729dac94fe4840709d5f5db29613ffb478f

Эта долька для Сергея! Тебе достались слайды:

* 8
* 9
* 10
* 26

Snork2, 2019-01-16:
Вынесли на слайды еще отдельно формулу для "модели" датчика плз, которая `value = k*A*cos(alpha)`

Snork2, 2019-01-16:
Если докапываться, то шрифт на схеме в презентации можно сделать побольше. Издалека будет плоховато видно такой как есть

SeresHotes, 2019-02-09:
Готово!

Closed 2019-02-09.

Thread 25 (2019-01-11):

Создание презентации vier

Snork2, 2019-01-11:
Разделяем #19 на задачи для отдельных участников согласно протоколу совещания от 79c2f729dac94fe4840709d5f5db29613ffb478f

Эта долька для Арины! Тебе достались слайды:

* 5
* 6
* 7
* 16

SeresHotes, 2019-02-09:
Готово!

Closed 2019-02-09.

Thread 26 (2019-01-11):

Создание презентации fünf

Snork2, 2019-01-11:
Разделяем #19 на задачи для отдельных участников согласно протоколу совещания от 79c2f729dac94fe4840709d5f5db29613ffb478f

Эта долька для меня! Мне достались слайды:

* 13
* 14

Snork2, 2019-01-16:
Готово!

Closed 2019-01-16.

Thread 29 (2019-05-18):

Тест

SeresHotes, 2019-05-18:
https://github.com/shostakovichs-spacecraft-factory/cansat-2018-2019/blob/e4770e1317e2959d39092f09435e57be92cfd329/research/serial-port-linux/uart-test/src/main.c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

Closed 2019-05-18.
