shostakovichs-spacecraft-factory/cansat-2018-2019/schematic/bumblebee/layerboards/GCS.brd

## EAGLE design schematic/bumblebee/layerboards/GCS.brd (2019-06-24)

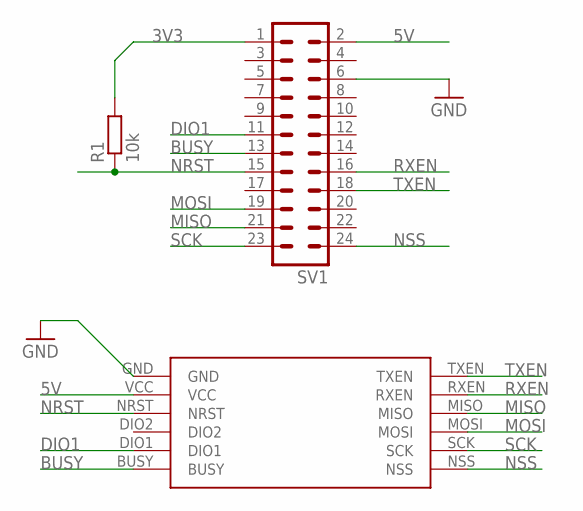
[picture p13: schematic GCS.sch]

Parts:
R1: 10k; 0207/10
SV1: MA12-2
U$1: E22_PLATE

Connections:
3V3: R1.2, SV1.1
5V: SV1.2, U$1.VCC
BUSY: SV1.13, U$1.BUSY
DIO1: SV1.11, U$1.DIO1
GND: SV1.6, U$1.GND
MISO: SV1.21, U$1.MISO
MOSI: SV1.19, U$1.MOSI
NRST: R1.1, SV1.15, U$1.NRST
NSS: SV1.24, U$1.NSS
RXEN: SV1.16, U$1.RXEN
SCK: SV1.23, U$1.SCK
TXEN: SV1.18, U$1.TXEN

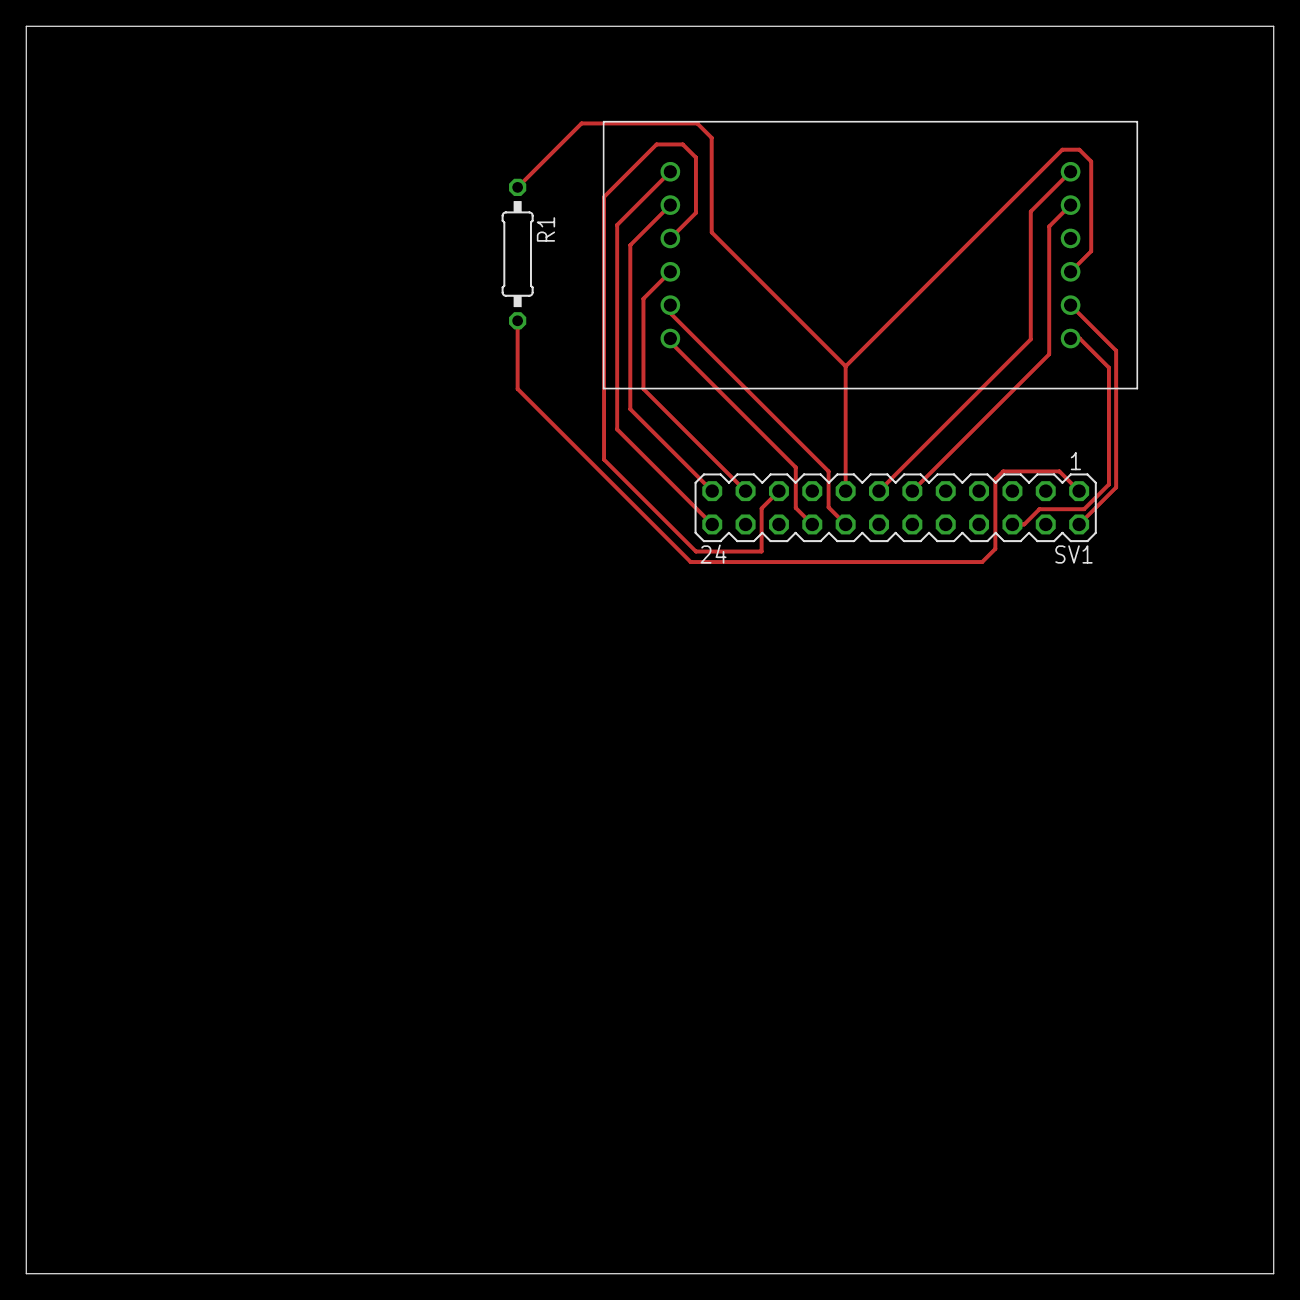
[picture p14: board GCS.brd from above]

Board: 2 copper layers, 95.0 x 95.0 mm, 3 parts (0 on the bottom side), 12 nets.
