shostakovichs-spacecraft-factory/cansat-2018-2019/schematic/bumblebee/layerboards/ccu_board.brd

## EAGLE design schematic/bumblebee/layerboards/ccu_board.brd (2019-06-01)

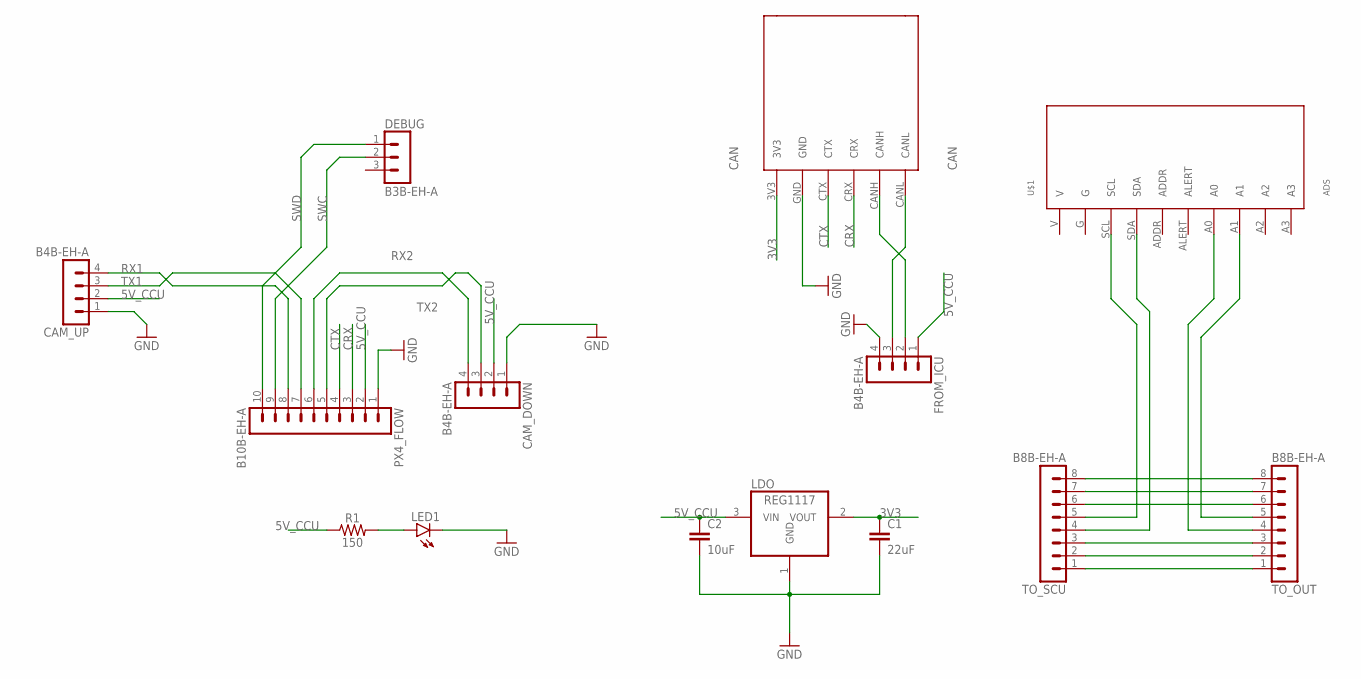
[picture p15: schematic ccu_board.sch]

Parts:
C1: 22uF; 0805
C2: 10uF; 0805
CAM_DOWN: B4B-EH-A
CAM_UP: B4B-EH-A
CAN: CAN
DEBUG: B3B-EH-A
FROM_ICU: B4B-EH-A
LDO: REG1117; SOT223
LED1: LED5MM
PX4_FLOW: B10B-EH-A
R1: 150; AXIAL-0.3
TO_OUT: B8B-EH-A
TO_SCU: B8B-EH-A
U$1: ADS

Connections:
3V3: C1.1, CAN.3V3, LDO.2 (VOUT)
5V_CCU: C2.1, CAM_DOWN.2, CAM_UP.2, FROM_ICU.1, LDO.3 (VIN), PX4_FLOW.2, R1.P$1 (1)
CRX: CAN.CRX, PX4_FLOW.3
CTX: CAN.CTX, PX4_FLOW.4
GND: C1.2, C2.2, CAM_DOWN.1, CAM_UP.1, CAN.GND, FROM_ICU.4, LDO.1 (GND), LED1.K (C), PX4_FLOW.1
unnamed: TO_OUT.8, TO_SCU.8
unnamed: TO_OUT.7, TO_SCU.7
unnamed: TO_OUT.6, TO_SCU.6
unnamed: TO_OUT.3, TO_SCU.3
unnamed: TO_OUT.2, TO_SCU.2
unnamed: CAN.CANL, FROM_ICU.3
unnamed: TO_OUT.1, TO_SCU.1
unnamed: CAN.CANH, FROM_ICU.2
unnamed: TO_SCU.5, U$1.SCL
unnamed: TO_SCU.4, U$1.SDA
unnamed: LED1.A, R1.P$2 (2)
unnamed: TO_OUT.5, U$1.A1
unnamed: TO_OUT.4, U$1.A0
RX1: CAM_UP.4, PX4_FLOW.8
RX2: CAM_DOWN.4, PX4_FLOW.6
SWC: DEBUG.2, PX4_FLOW.9
SWD: DEBUG.1, PX4_FLOW.10
TX1: CAM_UP.3, PX4_FLOW.7
TX2: CAM_DOWN.3, PX4_FLOW.5

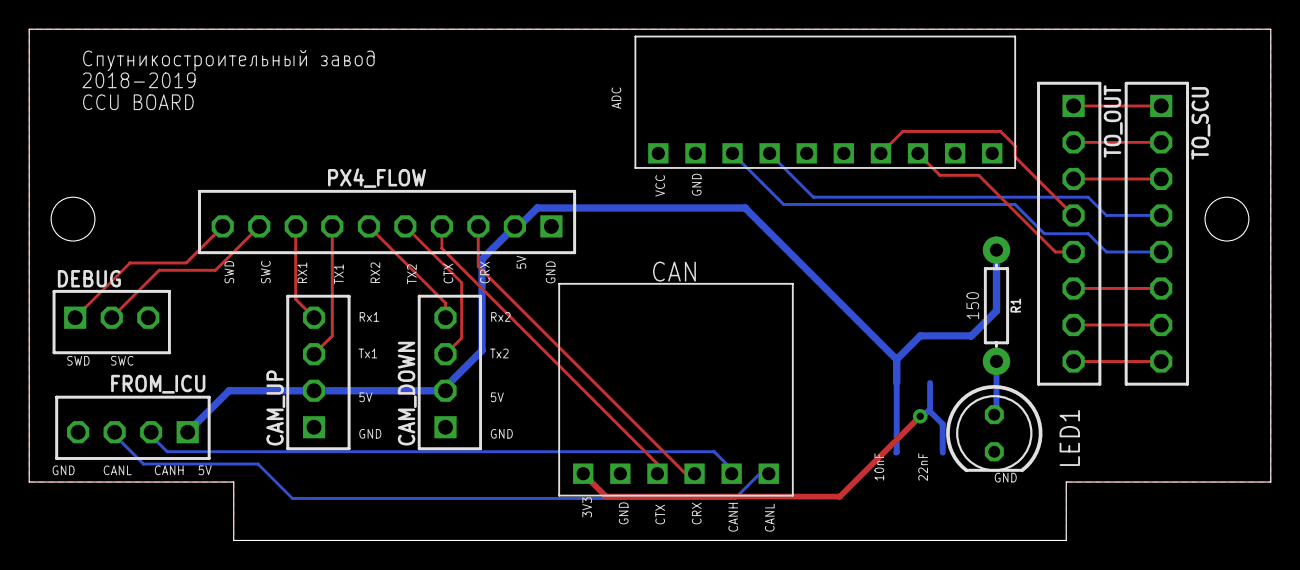
[picture p16: board ccu_board.brd from above]

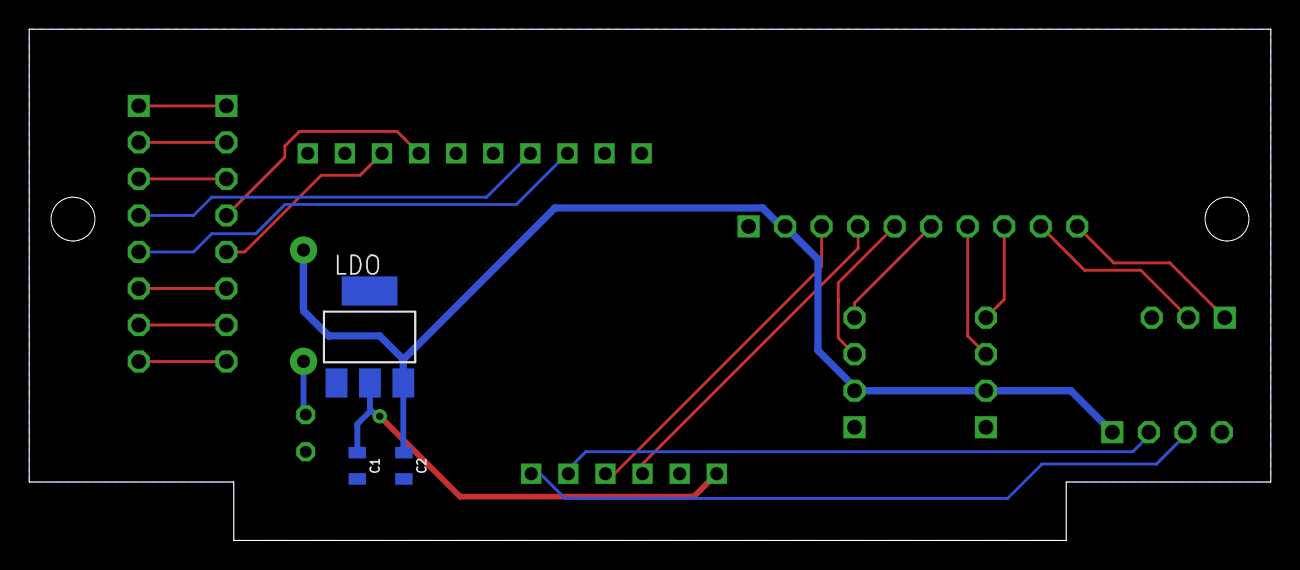
[picture p17: board ccu_board.brd from below]

Board: 2 copper layers, 85.0 x 35.0 mm, 14 parts (3 on the bottom side), 24 nets.
