shostakovichs-spacecraft-factory/cansat-2018-2019/schematic/bumblebee/layerboards/out_board.brd

## EAGLE design schematic/bumblebee/layerboards/out_board.brd (2019-06-01)

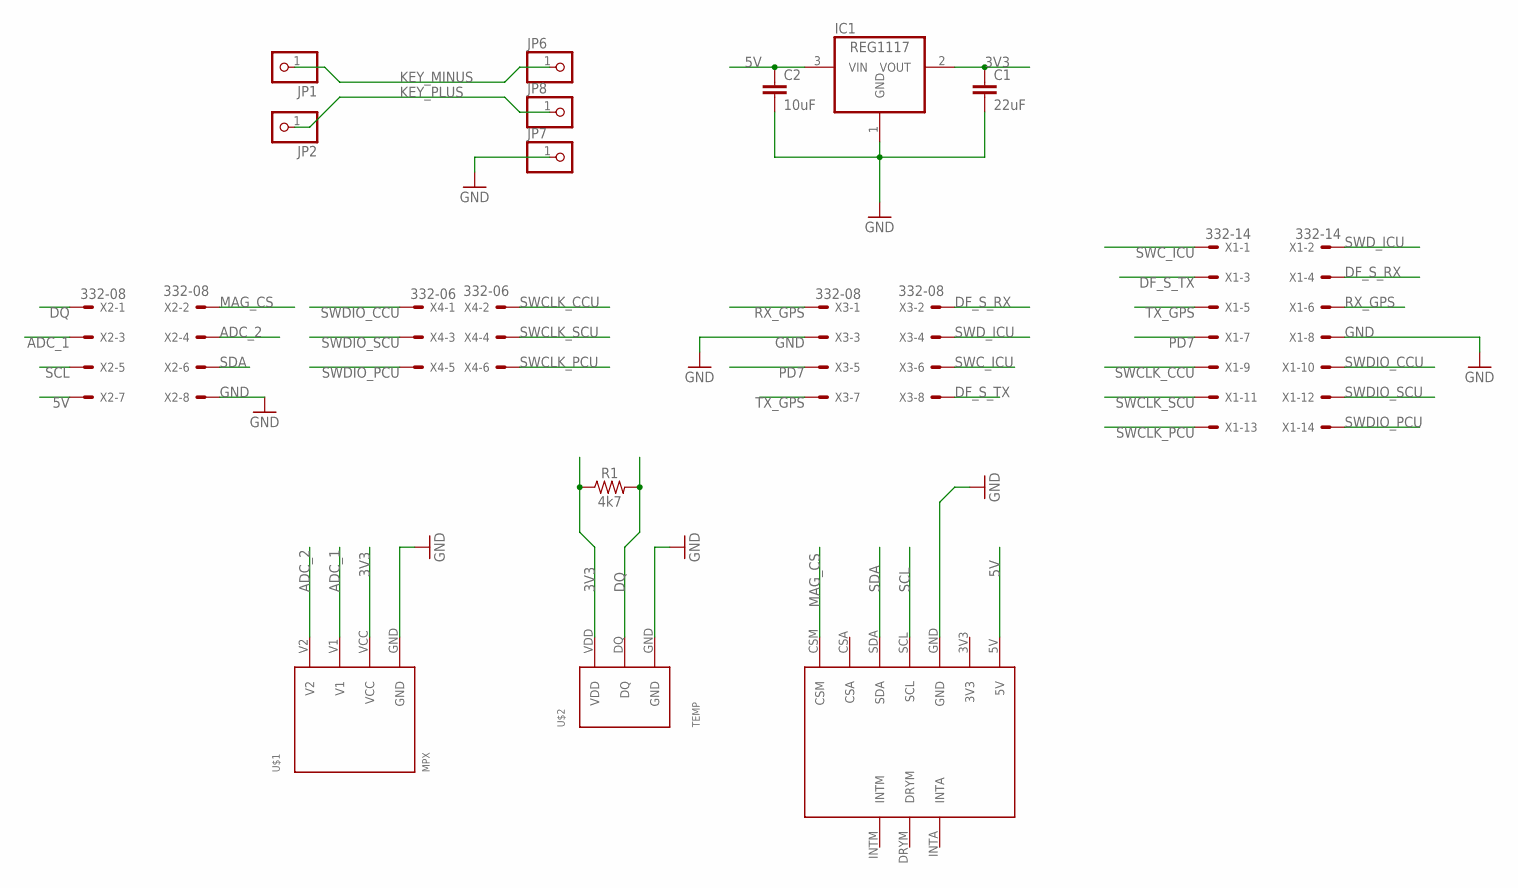
[picture p18: schematic out_board.sch]

Parts:
C1: 22uF; 0805
C2: 10uF; 0805
IC1: REG1117; SOT223
JP1, JP2, JP6, JP7, JP8: PINHD-1X1; 1X01
R1: 4k7; AXIAL-0.3
U$1: MPX
U$2: TEMP
U$3: LSM303C
X1: 332-14
X2, X3: 332-08
X4: 332-06

Connections:
3V3: C1.1, IC1.2 (VOUT), R1.P$1 (1), U$1.VCC, U$2.VDD
5V: C2.1, IC1.3 (VIN), U$3.5V, X2.7
ADC_1: U$1.V1, X2.3
ADC_2: U$1.V2, X2.4
DF_S_RX: X1.4, X3.2
DF_S_TX: X1.3, X3.8
DQ: R1.P$2 (2), U$2.DQ, X2.1
GND: C1.2, C2.2, IC1.1 (GND), JP7.1, U$1.GND, U$2.GND, U$3.GND, X1.8, X2.8, X3.3
KEY_MINUS: JP1.1, JP6.1
KEY_PLUS: JP2.1, JP8.1
MAG_CS: U$3.CSM, X2.2
PD7: X1.7, X3.5
RX_GPS: X1.6, X3.1
SCL: U$3.SCL, X2.5
SDA: U$3.SDA, X2.6
SWCLK_CCU: X1.9, X4.2
SWCLK_PCU: X1.13, X4.6
SWCLK_SCU: X1.11, X4.4
SWC_ICU: X1.1, X3.6
SWDIO_CCU: X1.10, X4.1
SWDIO_PCU: X1.14, X4.5
SWDIO_SCU: X1.12, X4.3
SWD_ICU: X1.2, X3.4
TX_GPS: X1.5, X3.7

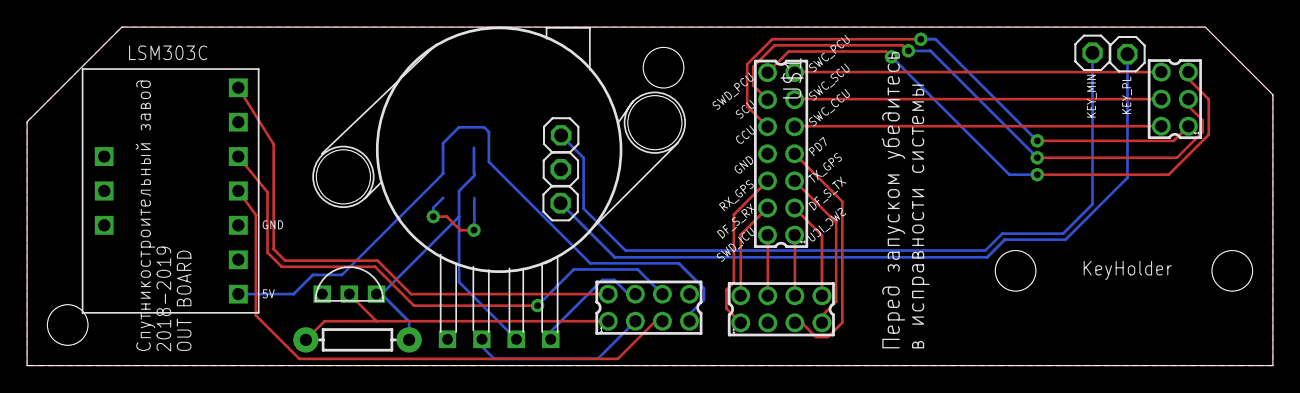
[picture p19: board out_board.brd from above]

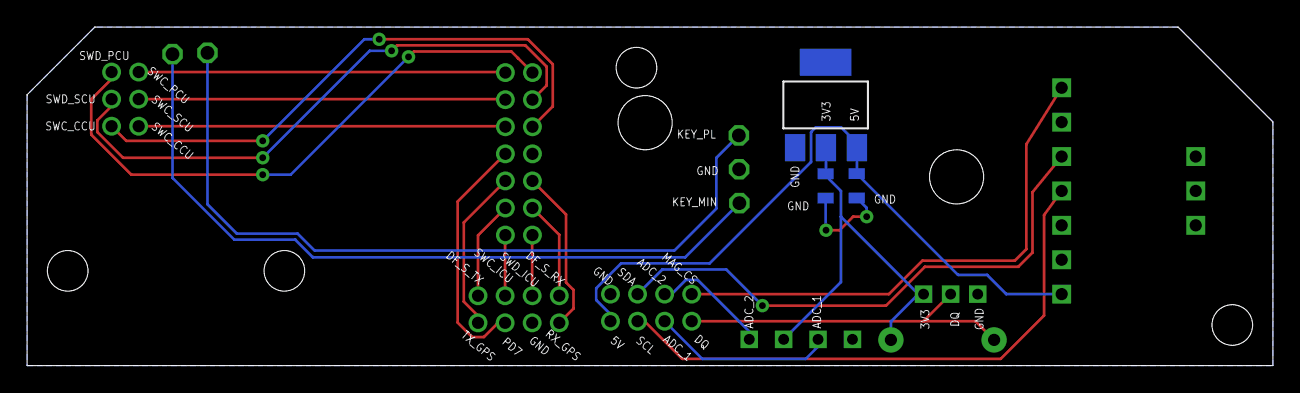
[picture p20: board out_board.brd from below]

Board: 2 copper layers, 92.0 x 25.0 mm, 16 parts (3 on the bottom side), 24 nets.
