shostakovichs-spacecraft-factory/cansat-2018-2019/schematic/bumblebee/layerboards/psu_board.brd

## EAGLE design schematic/bumblebee/layerboards/psu_board.brd (2019-06-01)

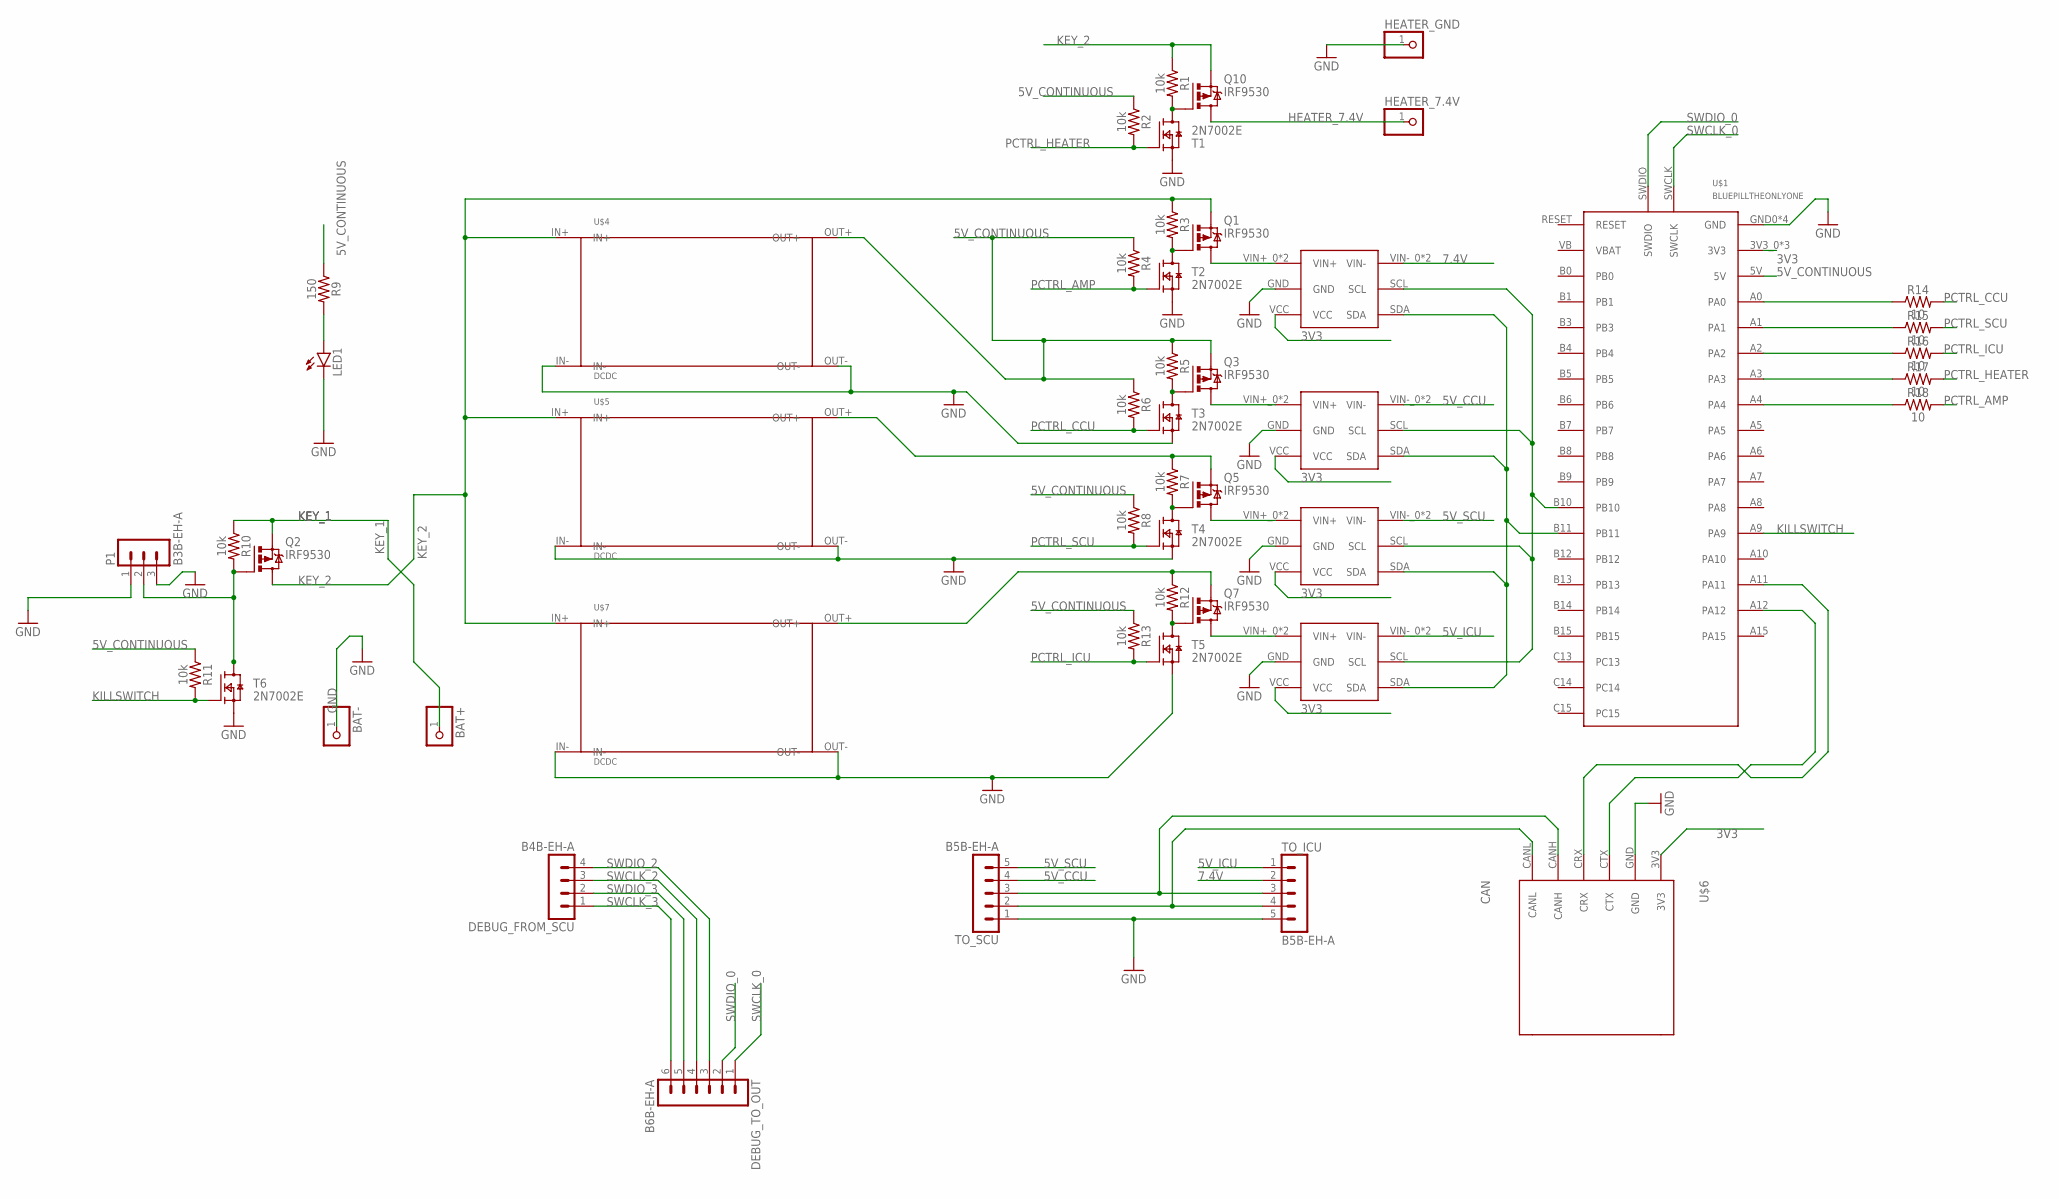
[picture p21: schematic psu_board.sch]

Parts:
BAT+: PINHD-1X1; 1X01
BAT-: PINHD-1X1; 1X01
DEBUG_FROM_SCU: B4B-EH-A
DEBUG_TO_OUT: B6B-EH-A
HEATER_7.4V: PINHD-1X1; 1X01
HEATER_GND: PINHD-1X1; 1X01
LED1: LED5MM
P1: B3B-EH-A
Q1, Q2, Q3, Q5, Q7, Q10: IRF9530; TO220BV
R1, R2, R3, R4, R5, R6, R7, R8, R10, R11, R12, R13: 10k; AXIAL-0.3
R9: 150; AXIAL-0.3
R14, R15, R16, R17, R18: 10; AXIAL-0.3
T1, T2, T3, T4, T5, T6: 2N7002E; SOT23
TO_ICU: B5B-EH-A
TO_SCU: B5B-EH-A
U$1: BLUEPILLTHEONLYONE; BLUEPIL
U$2, U$3, U$8, U$9: INA
U$4, U$5, U$7: DCDC
U$6: CAN

Connections:
3V3: U$1.3V3_0 (3V3), U$1.3V3_1 (3V3), U$1.3V3_2 (3V3), U$2.VCC, U$3.VCC, U$6.3V3, U$8.VCC, U$9.VCC
5V_CCU: TO_SCU.4, U$9.VIN-_0 (VIN-), U$9.VIN-_1 (VIN-)
5V_CONTINUOUS: Q3.S, R2.P$1 (1), R4.P$1 (1), R5.P$1 (1), R6.P$1 (1), R8.P$1 (1), R9.P$1 (1), R11.P$1 (1), R13.P$1 (1), U$1.5V, U$4.OUT+
5V_ICU: TO_ICU.1, U$2.VIN-_0 (VIN-), U$2.VIN-_1 (VIN-)
5V_SCU: TO_SCU.5, U$8.VIN-_0 (VIN-), U$8.VIN-_1 (VIN-)
7.4V: TO_ICU.2, U$3.VIN-_0 (VIN-), U$3.VIN-_1 (VIN-)
CANH: TO_ICU.3, TO_SCU.3, U$6.CANH
CANL: TO_ICU.4, TO_SCU.2, U$6.CANL
GND: BAT-.1, HEATER_GND.1, LED1.K (C), P1.1, P1.3, T1.2 (S), T2.2 (S), T3.2 (S), T4.2 (S), T5.2 (S), T6.2 (S), TO_ICU.5, TO_SCU.1, U$1.GND0 (GND), U$1.GND1 (GND), U$1.GND2 (GND), U$1.GND3 (GND), U$2.GND, U$3.GND, U$4.IN-, U$4.OUT-, U$5.IN-, U$5.OUT-, U$6.GND, U$7.IN-, U$7.OUT-, U$8.GND, U$9.GND
HEATER_7.4V: HEATER_7.4V.1, Q10.D
KEY_1: BAT+.1, Q2.S, R10.P$1 (1)
KEY_2: Q1.S, Q2.D, Q10.S, R1.P$1 (1), R3.P$1 (1), U$4.IN+, U$5.IN+, U$7.IN+
KILLSWITCH: R11.P$2 (2), T6.1 (G), U$1.A9
unnamed: Q1.G, R3.P$2 (2), T2.3 (D)
unnamed: U$1.A11, U$6.CRX
unnamed: Q5.G, R7.P$2 (2), T4.3 (D)
unnamed: Q7.G, R12.P$2 (2), T5.3 (D)
unnamed: Q5.S, R7.P$1 (1), U$5.OUT+
unnamed: Q3.G, R5.P$2 (2), T3.3 (D)
unnamed: Q7.S, R12.P$1 (1), U$7.OUT+
unnamed: Q1.D, U$3.VIN+_0 (VIN+), U$3.VIN+_1 (VIN+)
unnamed: Q3.D, U$9.VIN+_0 (VIN+), U$9.VIN+_1 (VIN+)
unnamed: Q5.D, U$8.VIN+_0 (VIN+), U$8.VIN+_1 (VIN+)
unnamed: Q7.D, U$2.VIN+_0 (VIN+), U$2.VIN+_1 (VIN+)
unnamed: U$1.B11, U$2.SDA, U$3.SDA, U$8.SDA, U$9.SDA
unnamed: U$1.B10, U$2.SCL, U$3.SCL, U$8.SCL, U$9.SCL
unnamed: U$1.A12, U$6.CTX
unnamed: LED1.A, R9.P$2 (2)
unnamed: Q10.G, R1.P$2 (2), T1.3 (D)
unnamed: R14.P$1 (1), U$1.A0
unnamed: R15.P$1 (1), U$1.A1
unnamed: R16.P$1 (1), U$1.A2
unnamed: R17.P$1 (1), U$1.A3
unnamed: R18.P$1 (1), U$1.A4
unnamed: P1.2, Q2.G, R10.P$2 (2), T6.3 (D)
PCTRL_AMP: R4.P$2 (2), R18.P$2 (2), T2.1 (G)
PCTRL_CCU: R6.P$2 (2), R14.P$2 (2), T3.1 (G)
PCTRL_HEATER: R2.P$2 (2), R17.P$2 (2), T1.1 (G)
PCTRL_ICU: R13.P$2 (2), R16.P$2 (2), T5.1 (G)
PCTRL_SCU: R8.P$2 (2), R15.P$2 (2), T4.1 (G)
SWCLK_0: DEBUG_TO_OUT.1, U$1.SWCLK
SWCLK_2: DEBUG_FROM_SCU.3, DEBUG_TO_OUT.4
SWCLK_3: DEBUG_FROM_SCU.1, DEBUG_TO_OUT.6
SWDIO_0: DEBUG_TO_OUT.2, U$1.SWDIO
SWDIO_2: DEBUG_FROM_SCU.4, DEBUG_TO_OUT.3
SWDIO_3: DEBUG_FROM_SCU.2, DEBUG_TO_OUT.5

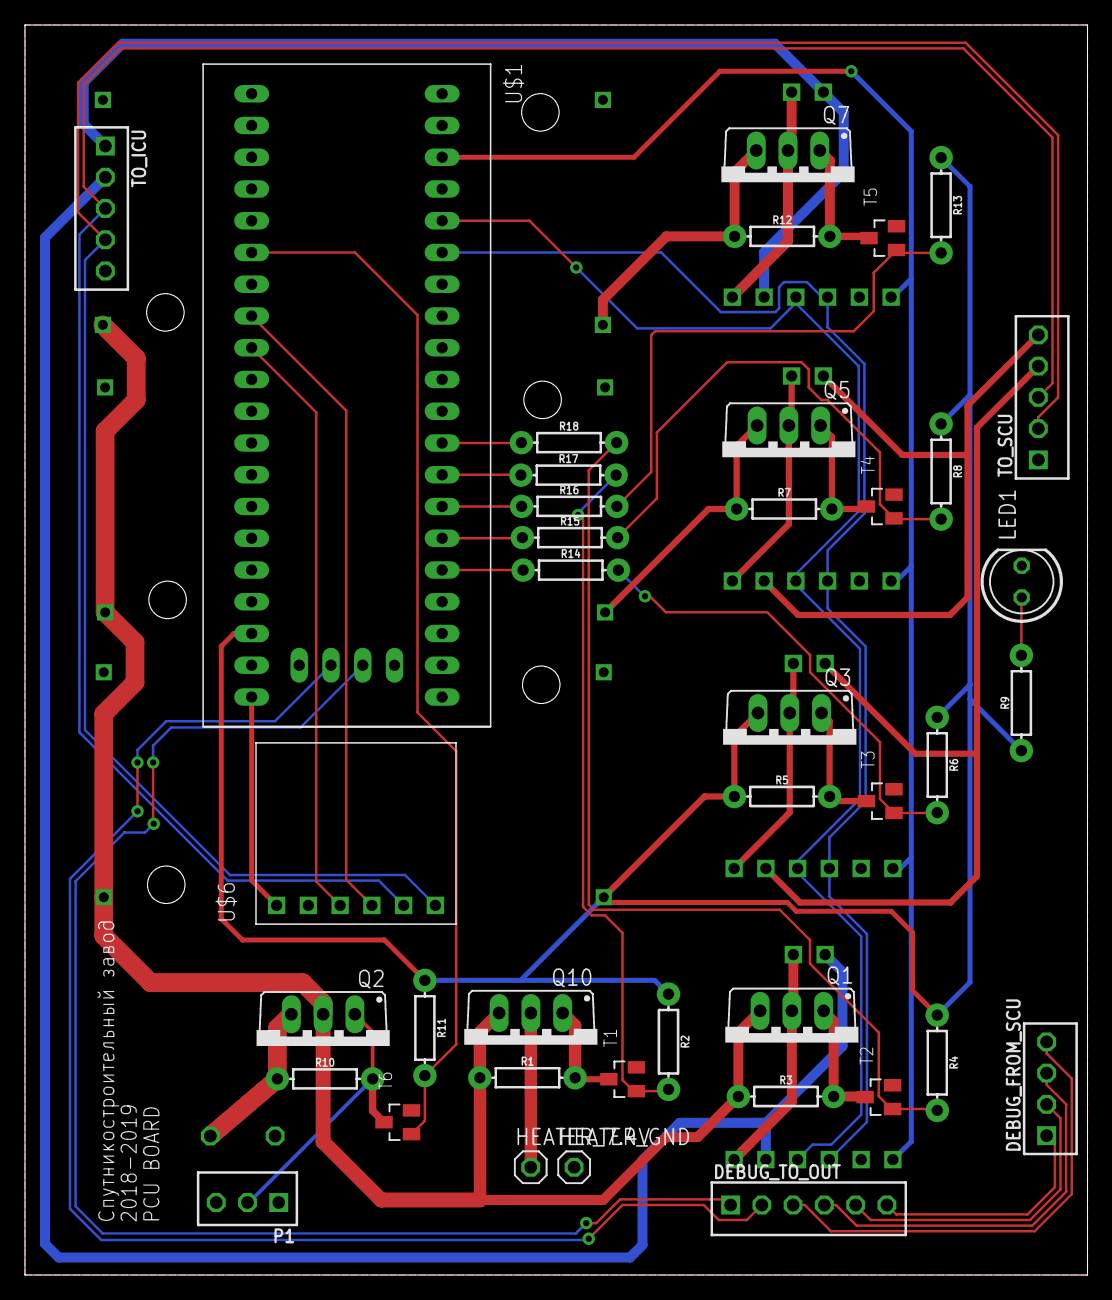
[picture p22: board psu_board.brd from above]

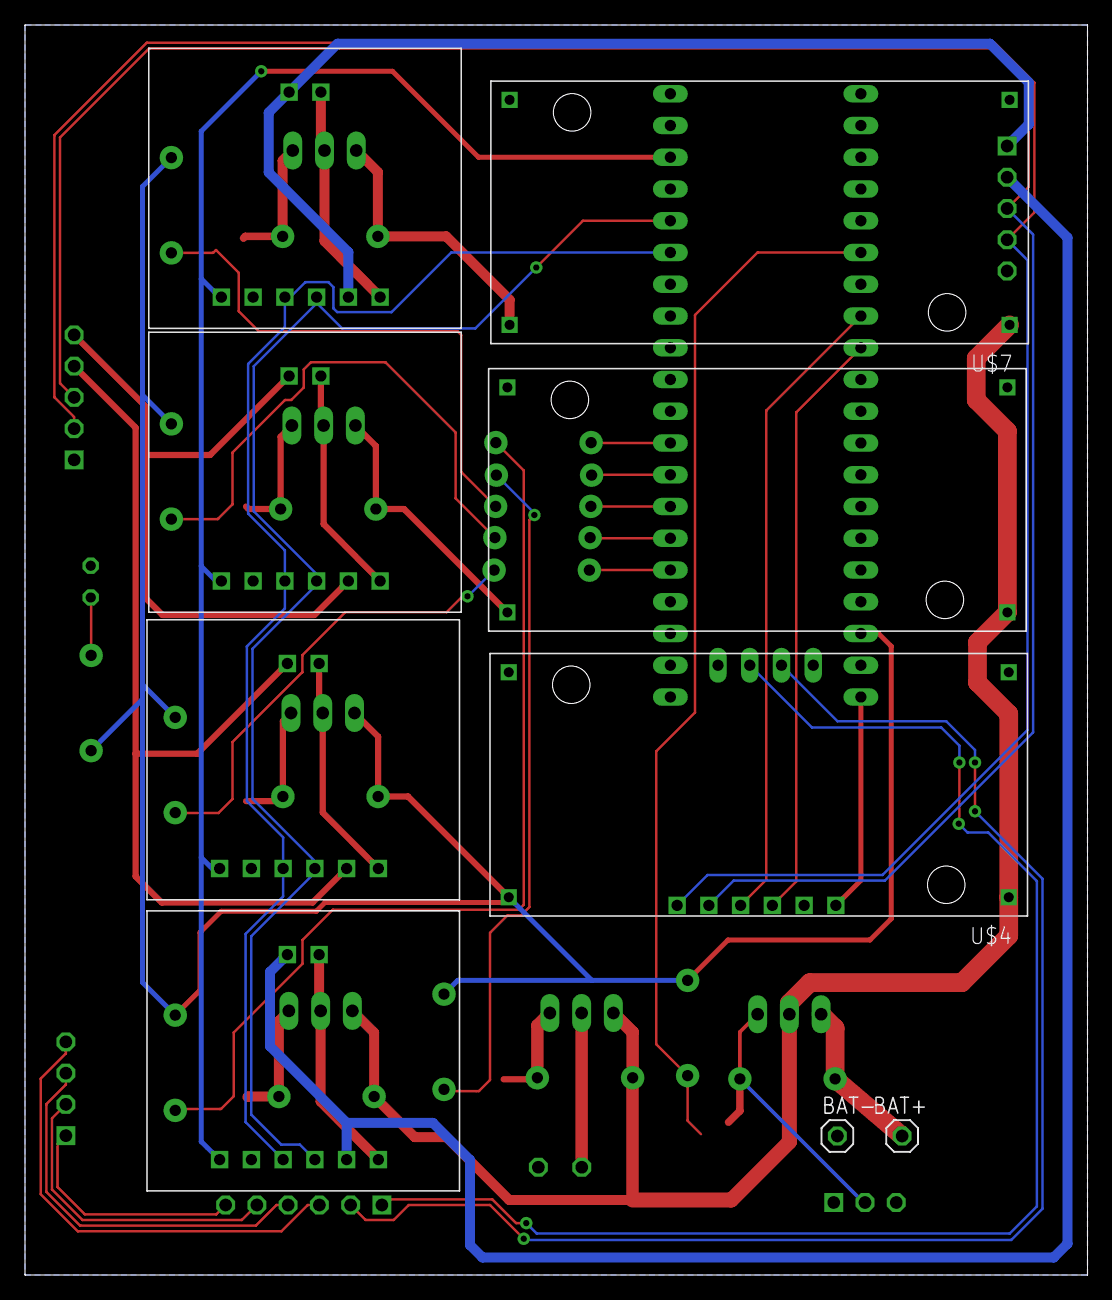
[picture p23: board psu_board.brd from below]

Board: 2 copper layers, 85.0 x 100.0 mm, 49 parts (9 on the bottom side), 46 nets.
