shostakovichs-spacecraft-factory/cansat-2018-2019/schematic/bumblebee/layerboards/icu_board.brd

## EAGLE design schematic/bumblebee/layerboards/icu_board.brd (2019-06-01)

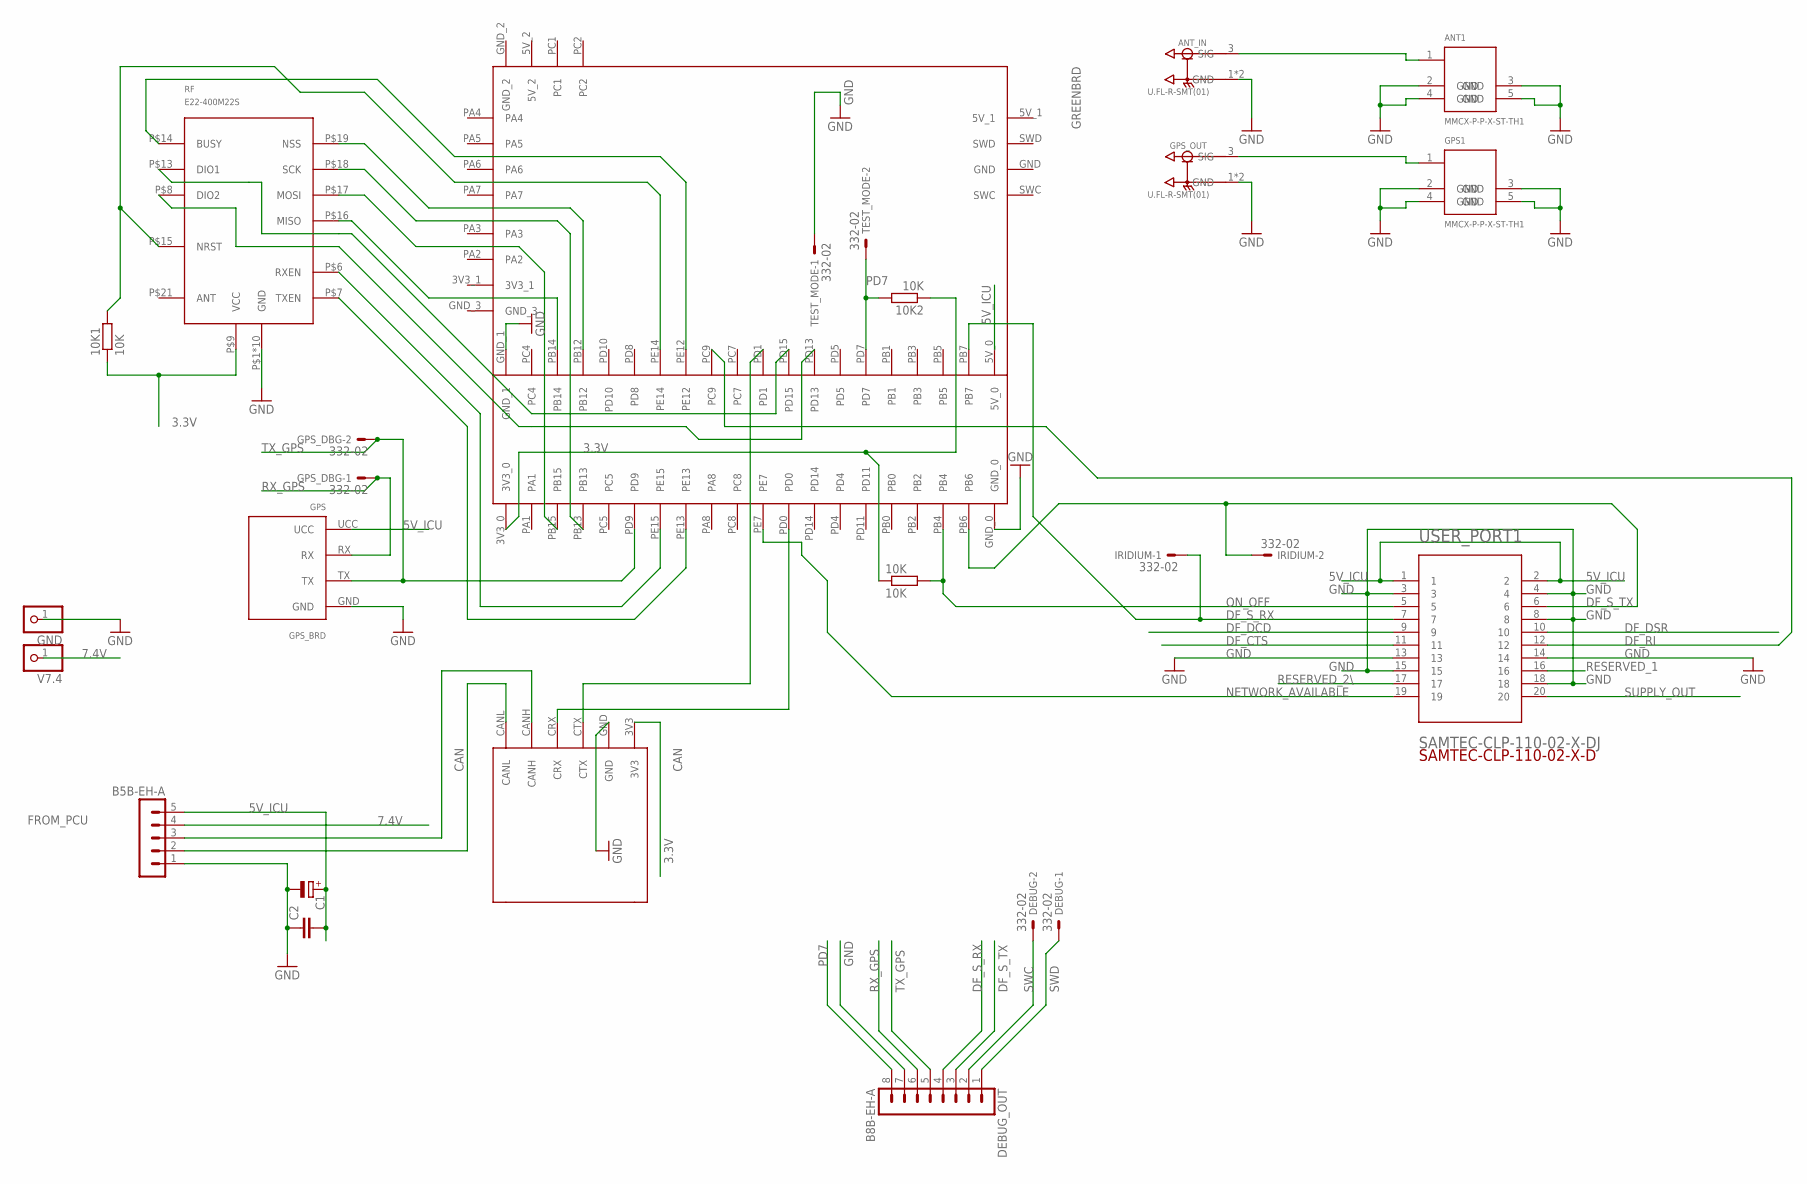
[picture p24: schematic icu_board.sch]

Parts:
10K, 10K1, 10K2: 10K; 0204/7
ANT1: MMCX-P-P-X-ST-TH1
ANT_IN: U.FL-R-SMT(01); HRS_U.FL-R-SMT(01)
C1: CPOL-EUE3.5-8; E3,5-8
C2: C2.5/2; C2.5-2
CAN: CAN
DEBUG: 332-02
DEBUG_OUT: B8B-EH-A
FROM_PCU: B5B-EH-A
GND: PINHD-1X1; 1X01
GPS1: MMCX-P-P-X-ST-TH1
GPS_BRD: GPS
GPS_DBG: 332-02
GPS_OUT: U.FL-R-SMT(01); HRS_U.FL-R-SMT(01)
GREENBRD: ICU
IRIDIUM: 332-02
RF: E22-400M22S
TEST_MODE: 332-02
USER_PORT1: SAMTEC-CLP-110-02-X-DJ; SAMTEC-CLP-110-02-X-D
V7.4: PINHD-1X1; 1X01

Connections:
3.3V: 10K.1, 10K1.1, 10K2.1, CAN.3V3, GREENBRD.3V3_0, RF.P$9 (VCC)
5V_ICU: C1.+, C2.2, FROM_PCU.5, GPS_BRD.UCC, GREENBRD.5V_0, USER_PORT1.1, USER_PORT1.2
7.4V: FROM_PCU.4, V7.4.1
DF_CTS: USER_PORT1.11
DF_DCD: USER_PORT1.9
DF_DSR: USER_PORT1.10
DF_RI: GREENBRD.PC9, USER_PORT1.12
DF_S_RX: DEBUG_OUT.4, GREENBRD.PB7, IRIDIUM.1, USER_PORT1.7
DF_S_TX: DEBUG_OUT.3, GREENBRD.PB6, IRIDIUM.2, USER_PORT1.6
GND: ANT1.2 (GND), ANT1.3 (GND), ANT1.4 (GND), ANT1.5 (GND), ANT_IN.1 (GND), ANT_IN.2 (GND), C1.-, C2.1, CAN.GND, DEBUG_OUT.7, FROM_PCU.1, GND.1, GPS1.2 (GND), GPS1.3 (GND), GPS1.4 (GND), GPS1.5 (GND), GPS_BRD.GND, GPS_OUT.1 (GND), GPS_OUT.2 (GND), GREENBRD.GND_0, GREENBRD.GND_1, RF.P$1 (GND), RF.P$2 (GND), RF.P$3 (GND), RF.P$4 (GND), RF.P$5 (GND), RF.P$10 (GND), RF.P$11 (GND), RF.P$12 (GND), RF.P$20 (GND), RF.P$22 (GND), TEST_MODE.1, USER_PORT1.3, USER_PORT1.4, USER_PORT1.8, USER_PORT1.13, USER_PORT1.14, USER_PORT1.15, USER_PORT1.18
unnamed: CAN.CANH, FROM_PCU.3
unnamed: GREENBRD.PB12, RF.P$19 (NSS)
unnamed: CAN.CANL, FROM_PCU.2
unnamed: ANT1.1, ANT_IN.3 (SIG)
unnamed: GPS1.1, GPS_OUT.3 (SIG)
unnamed: GREENBRD.PE15, RF.P$6 (RXEN)
unnamed: GREENBRD.PB13, RF.P$18 (SCK)
unnamed: CAN.CRX, GREENBRD.PD0
unnamed: CAN.CTX, GREENBRD.PD1
unnamed: GREENBRD.PD15, RF.P$13 (DIO1)
unnamed: GREENBRD.PD13, RF.P$8 (DIO2)
unnamed: GREENBRD.PB15, RF.P$17 (MOSI)
unnamed: GREENBRD.PB14, RF.P$16 (MISO)
unnamed: GREENBRD.PE12, RF.P$14 (BUSY)
unnamed: 10K1.2, GREENBRD.PE14, RF.P$15 (NRST)
unnamed: GREENBRD.PE13, RF.P$7 (TXEN)
NETWORK_AVAILABLE: GREENBRD.PE7, USER_PORT1.19
ON_OFF: 10K.2, GREENBRD.PB4, USER_PORT1.5
PD7: 10K2.2, DEBUG_OUT.8, GREENBRD.PD7, TEST_MODE.2
RESERVED_1: USER_PORT1.16
RESERVED_2\: USER_PORT1.17
RX_GPS: DEBUG_OUT.6, GPS_BRD.RX, GPS_DBG.1
SUPPLY_OUT: USER_PORT1.20
SWC: DEBUG.2, DEBUG_OUT.2
SWD: DEBUG.1, DEBUG_OUT.1
TX_GPS: DEBUG_OUT.5, GPS_BRD.TX, GPS_DBG.2, GREENBRD.PD9

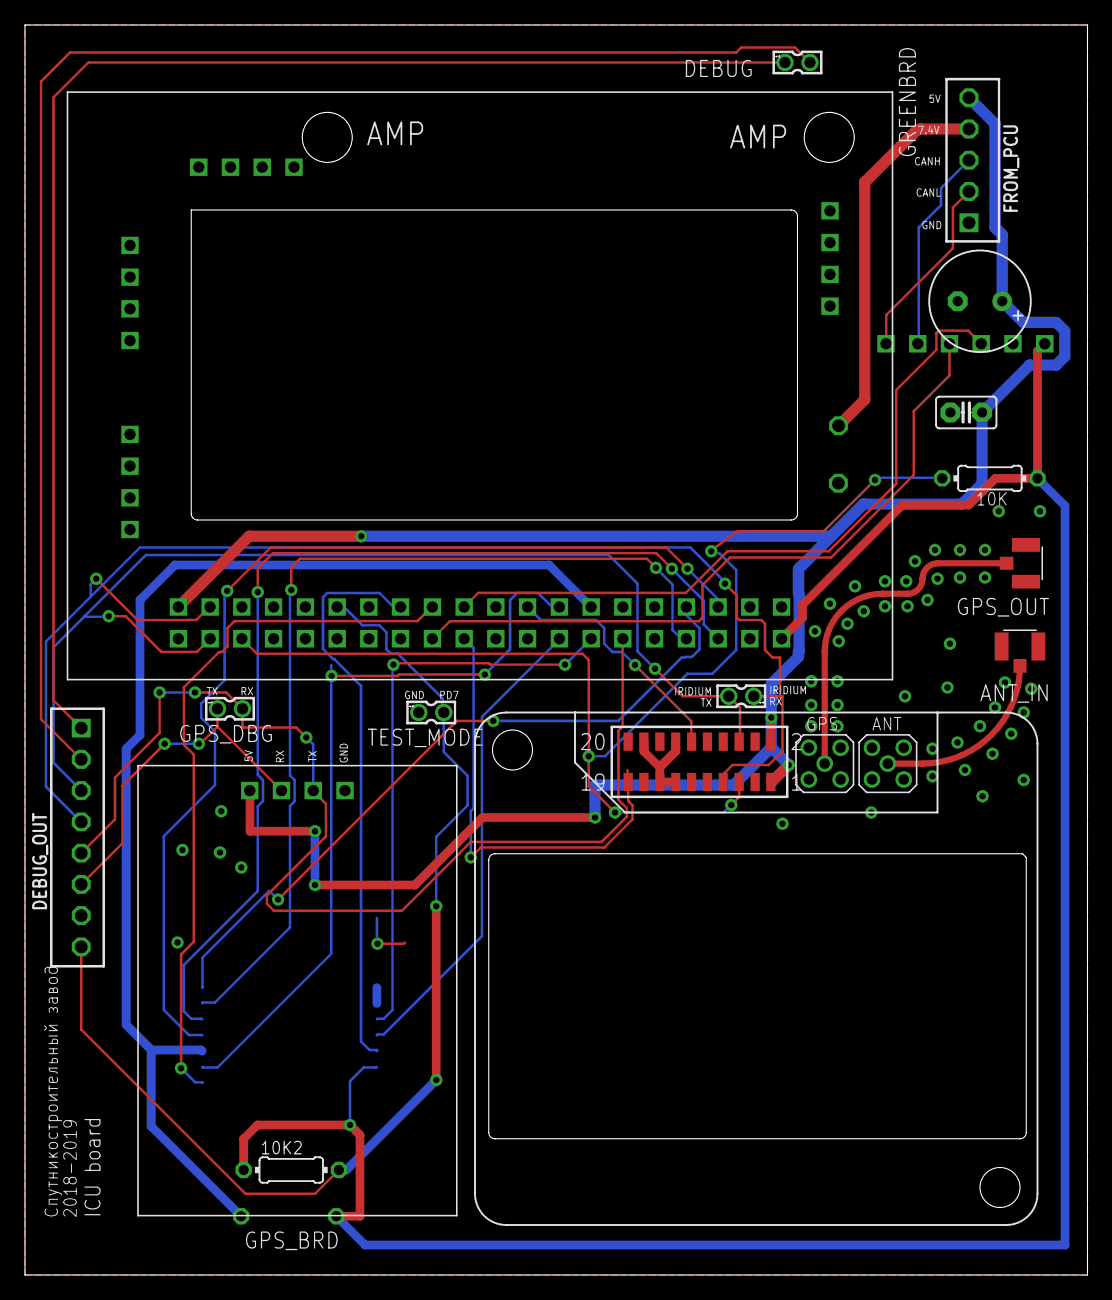
[picture p25: board icu_board.brd from above]

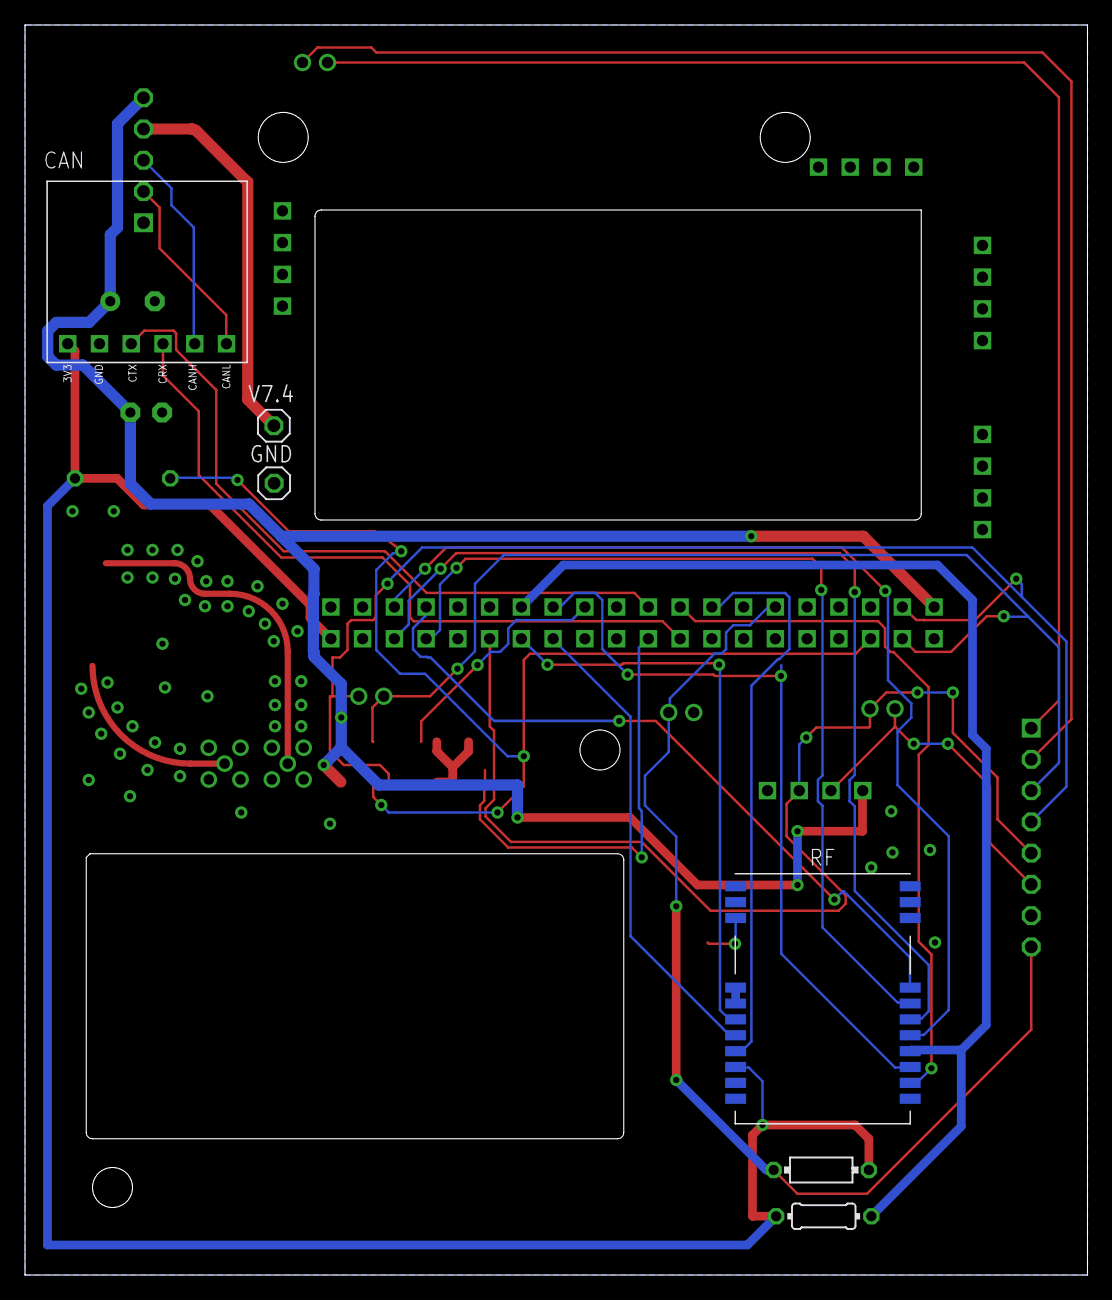
[picture p26: board icu_board.brd from below]

Board: 2 copper layers, 85.0 x 100.0 mm, 22 parts (5 on the bottom side), 30 nets.
