shostakovichs-spacecraft-factory/cansat-2018-2019/schematic/bumblebee/layerboards/scu_board.brd

## EAGLE design schematic/bumblebee/layerboards/scu_board.brd (2019-06-01)

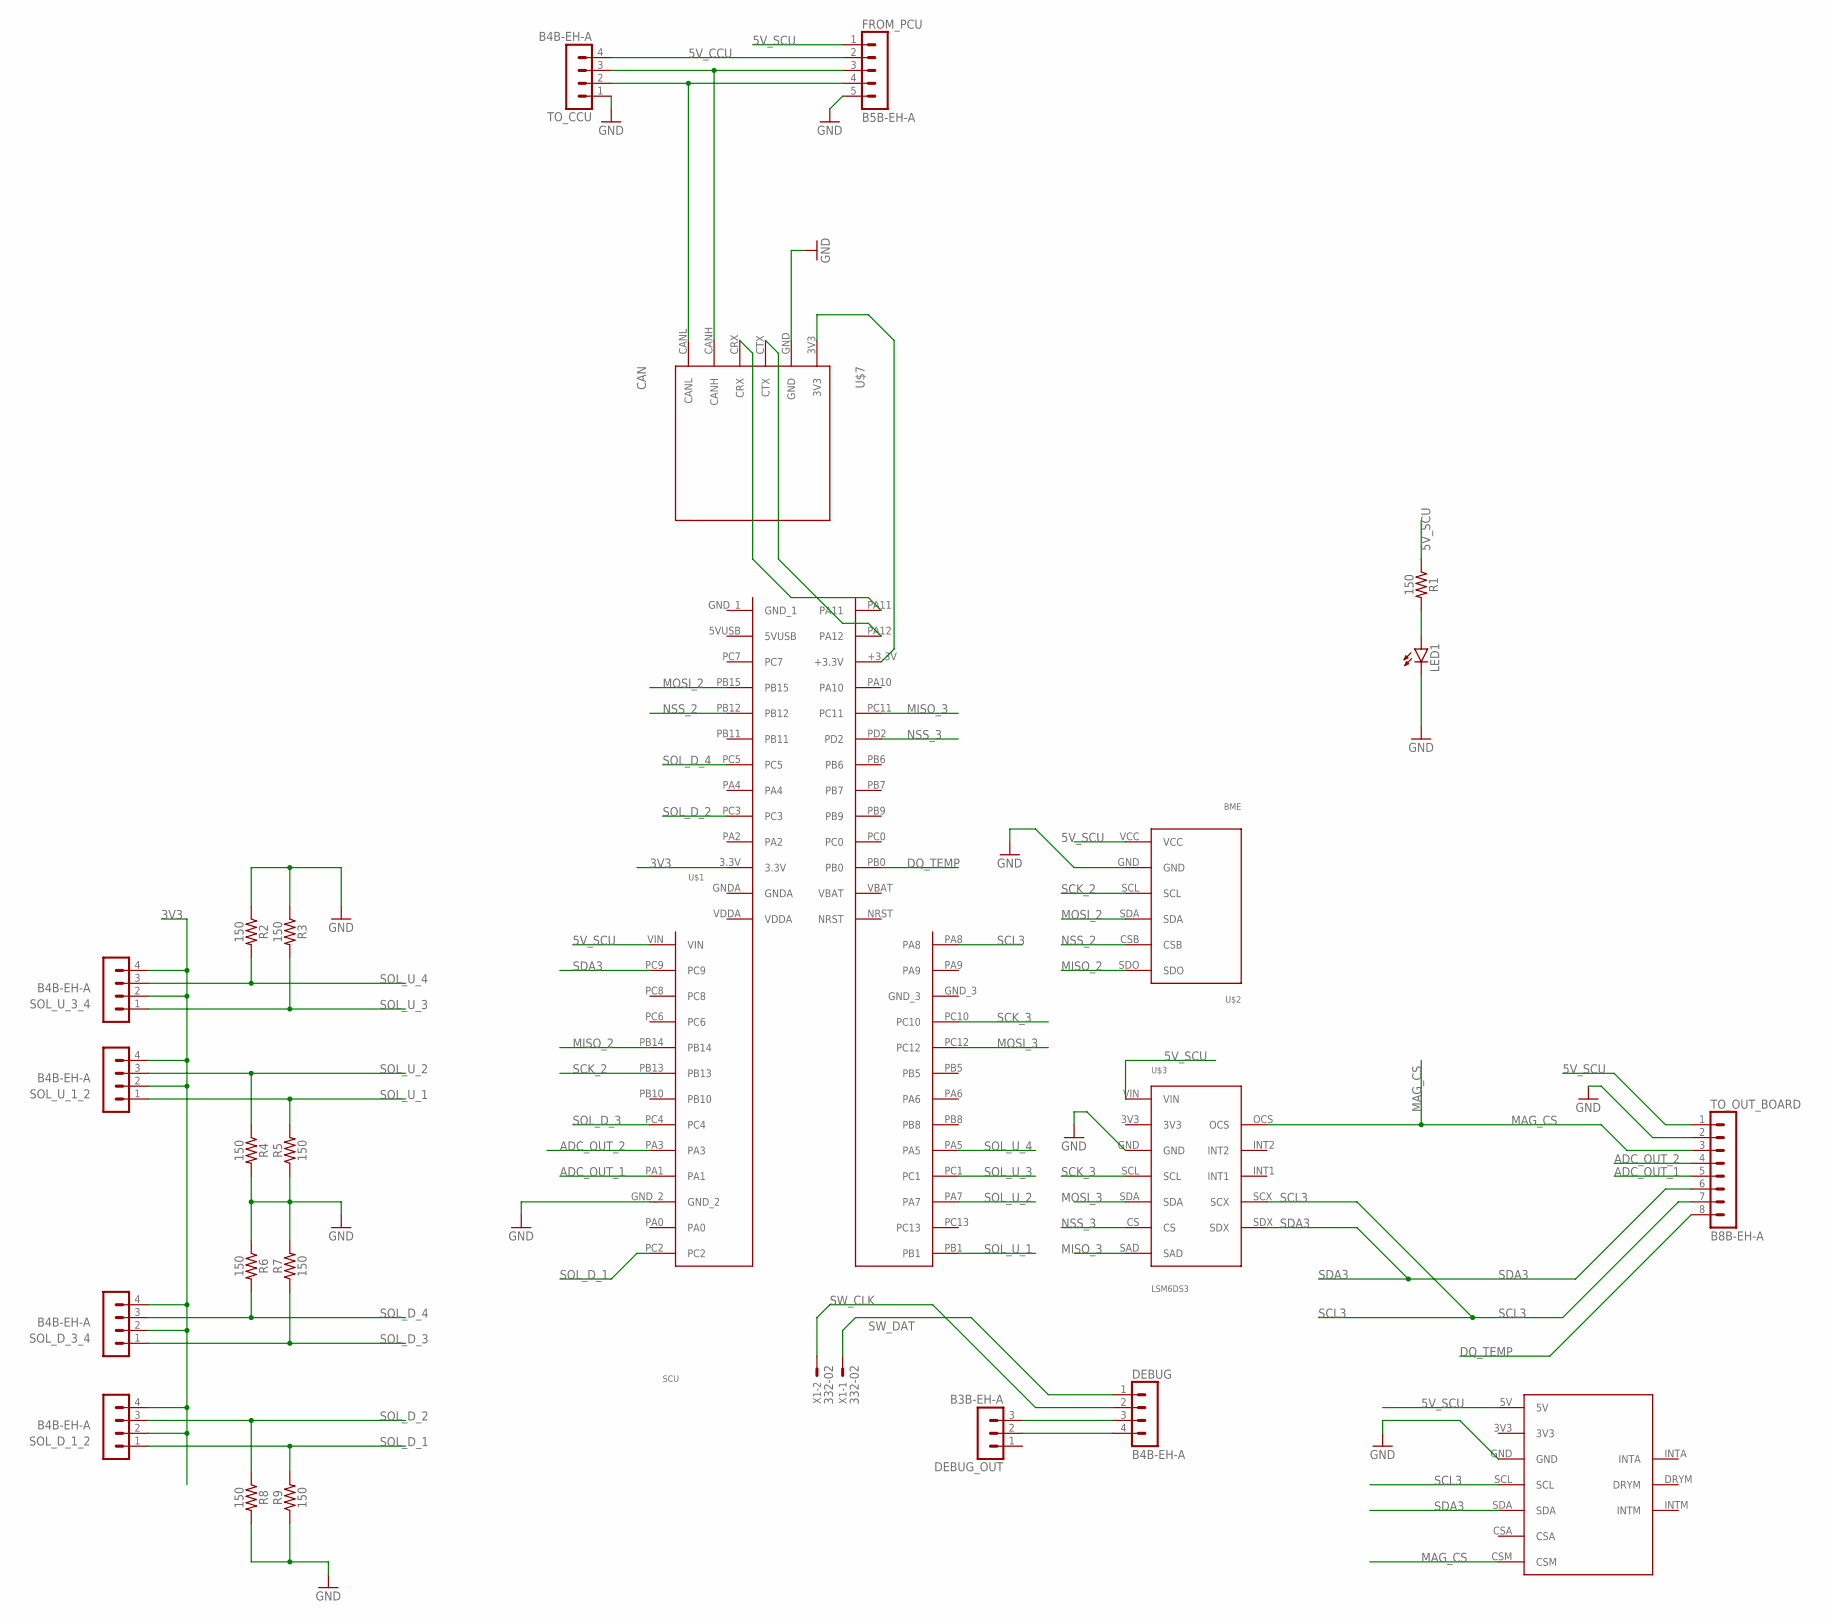
[picture p27: schematic scu_board.sch]

Parts:
DEBUG: B4B-EH-A
DEBUG_OUT: B3B-EH-A
FROM_PCU: B5B-EH-A
LED1: LED5MM
R1, R2, R3, R4, R5, R6, R7, R8, R9: 150; AXIAL-0.3
SOL_D_1_2, SOL_D_3_4: B4B-EH-A
SOL_U_1_2, SOL_U_3_4: B4B-EH-A
TO_CCU: B4B-EH-A
TO_OUT_BOARD: B8B-EH-A
U$1: SCU
U$2: BME
U$3: LSM6DS3
U$4: LSM303C
U$7: CAN
X1: 332-02

Connections:
3V3: SOL_D_1_2.2, SOL_D_1_2.4, SOL_D_3_4.2, SOL_D_3_4.4, SOL_U_1_2.2, SOL_U_1_2.4, SOL_U_3_4.2, SOL_U_3_4.4, U$1.3.3V
5V_CCU: FROM_PCU.2, TO_CCU.4
5V_SCU: FROM_PCU.1, R1.P$1 (1), TO_OUT_BOARD.1, U$1.VIN, U$2.VCC, U$3.VIN, U$4.5V
ADC_OUT_1: TO_OUT_BOARD.5, U$1.PA1
ADC_OUT_2: TO_OUT_BOARD.4, U$1.PA3
DQ_TEMP: TO_OUT_BOARD.8, U$1.PB0
GND: FROM_PCU.5, LED1.K (C), R2.P$1 (1), R3.P$1 (1), R4.P$2 (2), R5.P$1 (1), R6.P$1 (1), R7.P$2 (2), R8.P$2 (2), R9.P$1 (1), TO_CCU.1, TO_OUT_BOARD.2, U$1.GND_2, U$2.GND, U$3.GND, U$4.GND, U$7.GND
MAG_CS: TO_OUT_BOARD.3, U$3.OCS, U$4.CSM
MISO_2: U$1.PB14, U$2.SDO
MISO_3: U$1.PC11, U$3.SAD
MOSI_2: U$1.PB15, U$2.SDA
MOSI_3: U$1.PC12, U$3.SDA
unnamed: U$1.PA11, U$7.CRX
unnamed: U$1.PA12, U$7.CTX
unnamed: U$1.+3.3V, U$7.3V3
unnamed: LED1.A, R1.P$2 (2)
unnamed: FROM_PCU.3, TO_CCU.3, U$7.CANH
unnamed: FROM_PCU.4, TO_CCU.2, U$7.CANL
unnamed: DEBUG.3, DEBUG_OUT.3
unnamed: DEBUG.4, DEBUG_OUT.2
NSS_2: U$1.PB12, U$2.CSB
NSS_3: U$1.PD2, U$3.CS
SCK_2: U$1.PB13, U$2.SCL
SCK_3: U$1.PC10, U$3.SCL
SCL3: TO_OUT_BOARD.7, U$1.PA8, U$3.SCX, U$4.SCL
SDA3: TO_OUT_BOARD.6, U$1.PC9, U$3.SDX, U$4.SDA
SOL_D_1: R9.P$2 (2), SOL_D_1_2.1, U$1.PC2
SOL_D_2: R8.P$1 (1), SOL_D_1_2.3, U$1.PC3
SOL_D_3: R7.P$1 (1), SOL_D_3_4.1, U$1.PC4
SOL_D_4: R6.P$2 (2), SOL_D_3_4.3, U$1.PC5
SOL_U_1: R5.P$2 (2), SOL_U_1_2.1, U$1.PB1
SOL_U_2: R4.P$1 (1), SOL_U_1_2.3, U$1.PA7
SOL_U_3: R3.P$2 (2), SOL_U_3_4.1, U$1.PC1
SOL_U_4: R2.P$2 (2), SOL_U_3_4.3, U$1.PA5
SW_CLK: DEBUG.2, X1.2
SW_DAT: DEBUG.1, X1.1

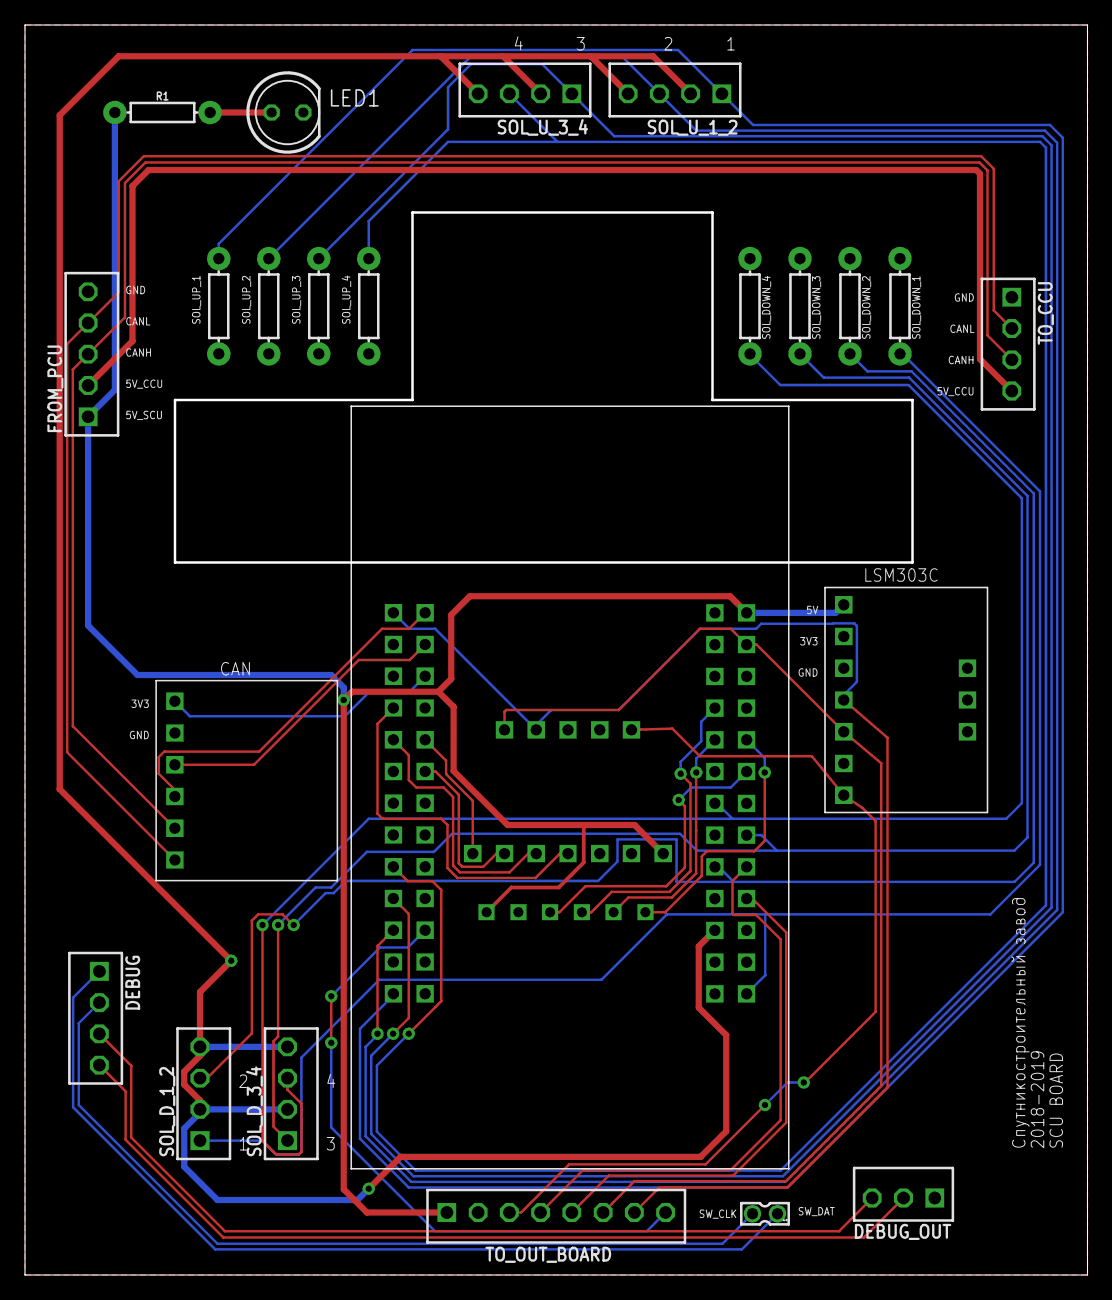
[picture p28: board scu_board.brd from above]

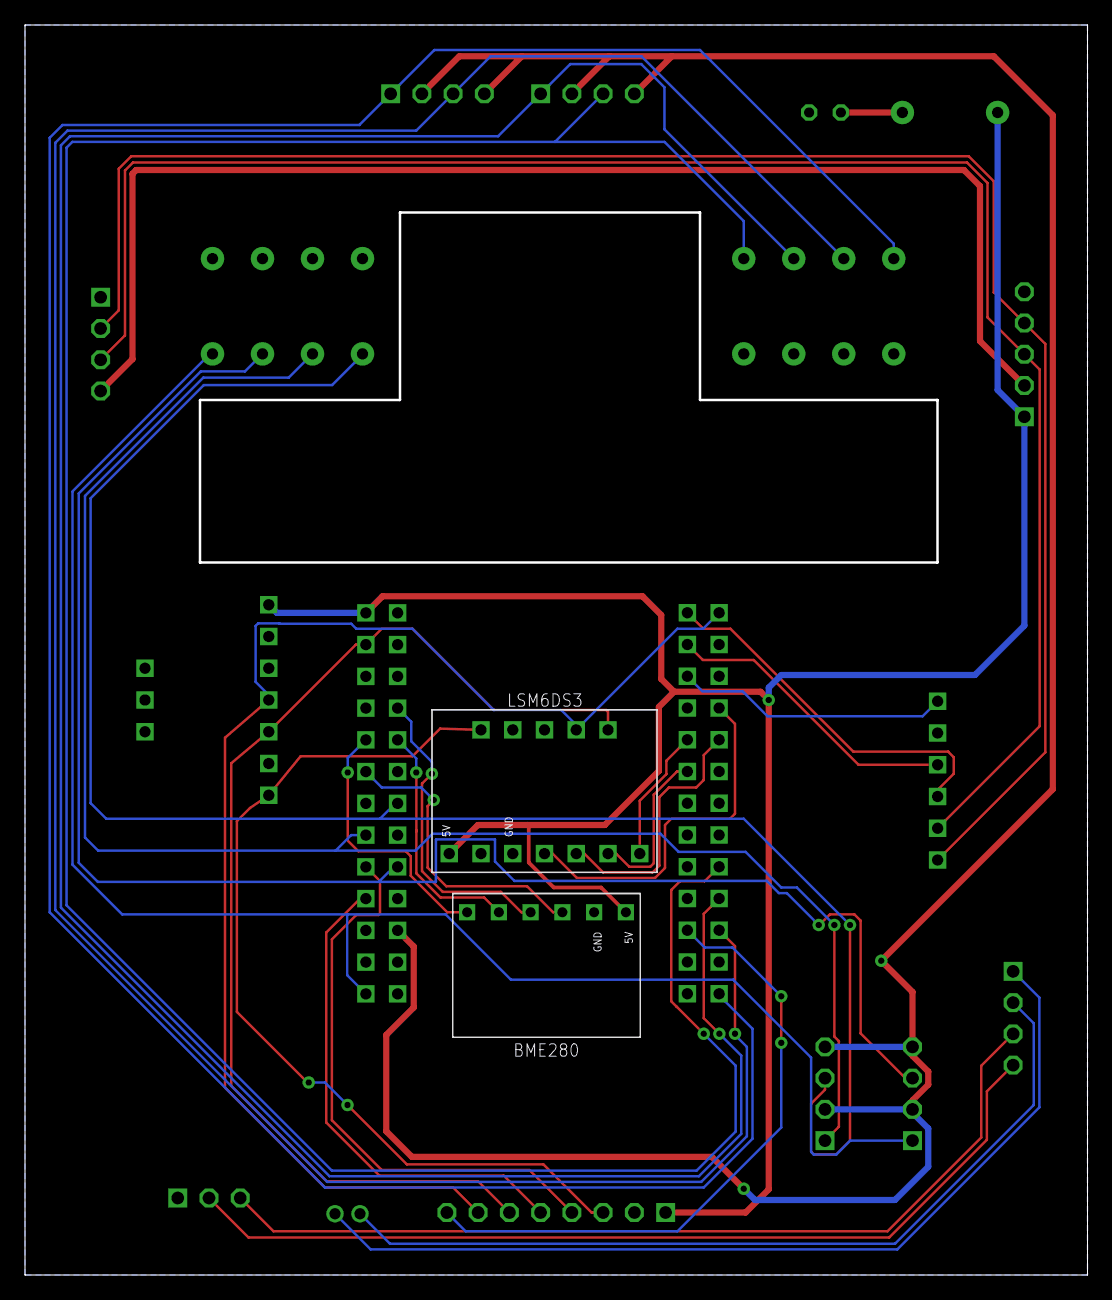
[picture p29: board scu_board.brd from below]

Board: 2 copper layers, 85.0 x 100.0 mm, 25 parts (2 on the bottom side), 36 nets.
