shostakovichs-spacecraft-factory/cansat-2018-2019/schematic/bumblebee/layerboards/RF_ant_board.brd

## EAGLE design schematic/bumblebee/layerboards/RF_ant_board.brd (2019-06-01)

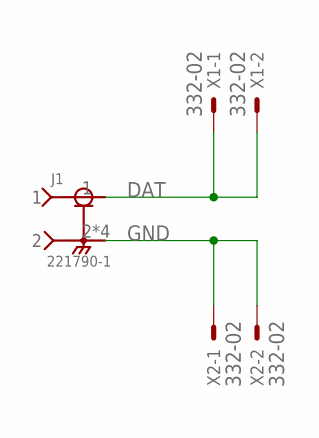
[picture p30: schematic RF_ant_board.sch]

Parts:
J1: 221790-1; TE_221790-1
X1, X2: 332-02

Connections:
DAT: J1.1, X1.1, X1.2
GND: J1.2, J1.3 (2), J1.4 (2), J1.5 (2), X2.1, X2.2

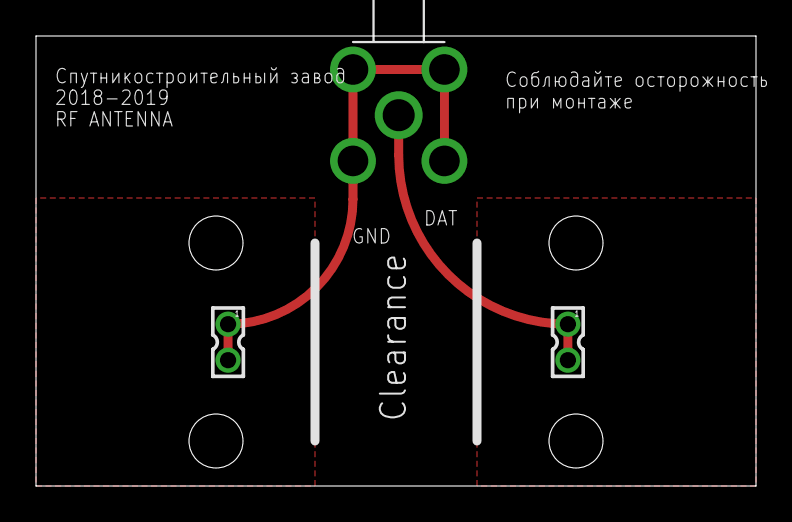
[picture p31: board RF_ant_board.brd from above]

Board: 2 copper layers, 40.0 x 25.0 mm, 3 parts (0 on the bottom side), 2 nets.
