shostakovichs-spacecraft-factory/cansat-2018-2019/schematic/bumblebee/devboards/iridium-9602-breakout.brd

## EAGLE design schematic/bumblebee/devboards/iridium-9602-breakout.brd (2019-01-16)

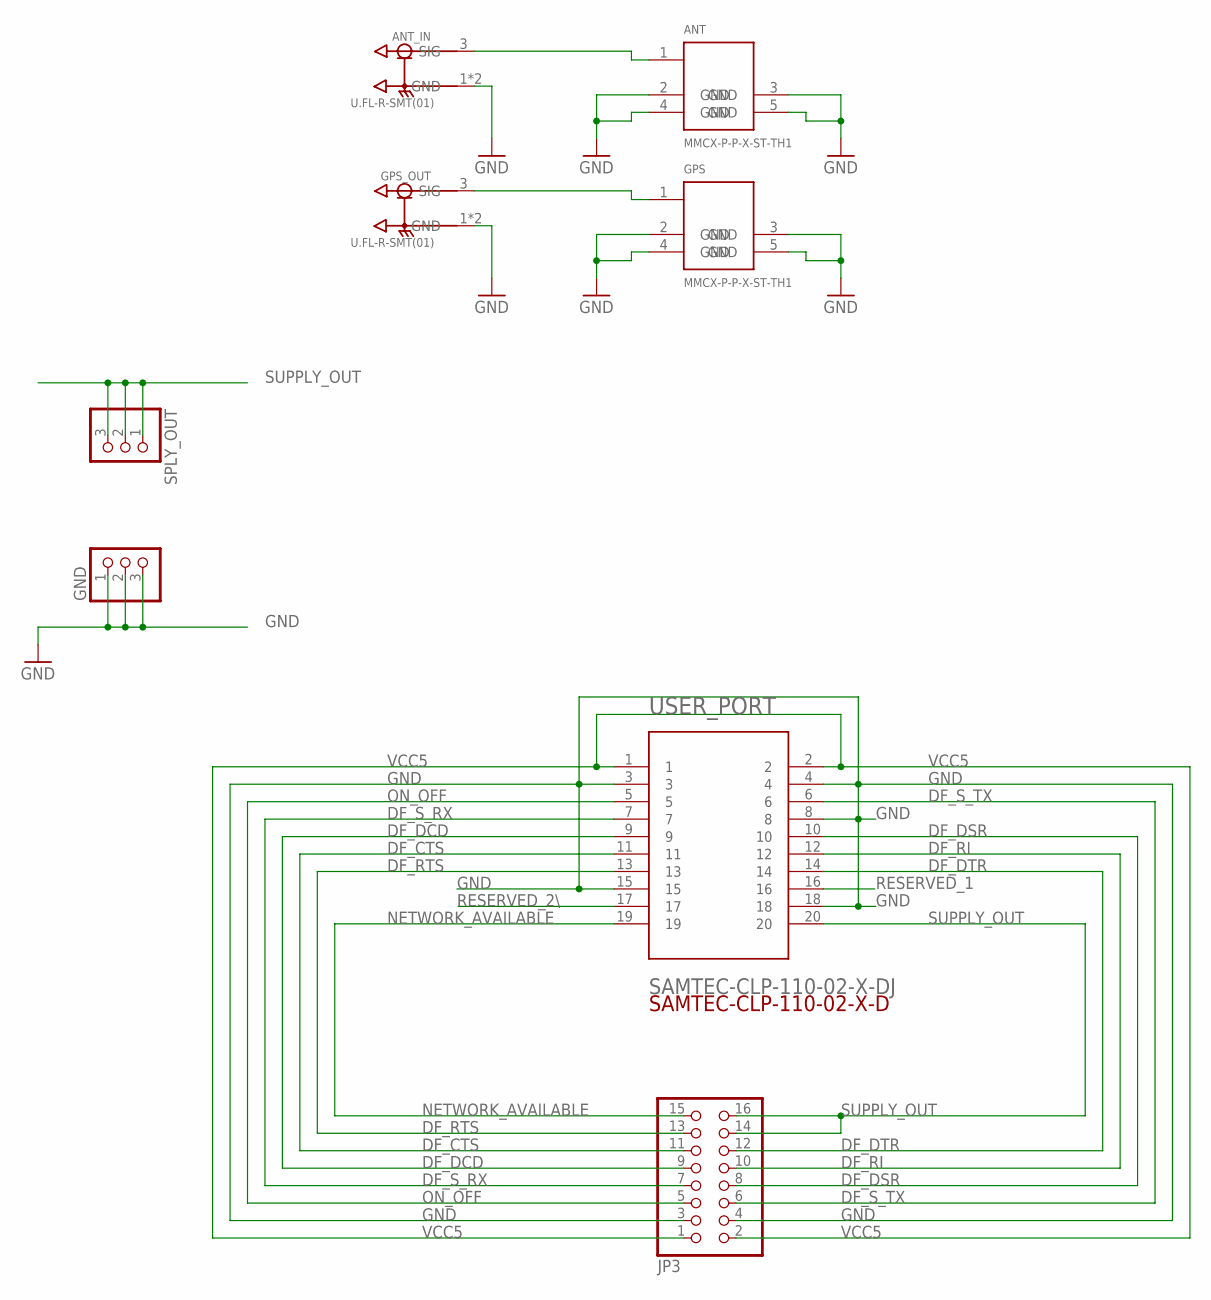
[picture p32: schematic iridium-9602-breakout.sch]

Parts:
ANT: MMCX-P-P-X-ST-TH1
ANT_IN: U.FL-R-SMT(01); HRS_U.FL-R-SMT(01)
GND: PINHD-1X3; 1X03
GPS: MMCX-P-P-X-ST-TH1
GPS_OUT: U.FL-R-SMT(01); HRS_U.FL-R-SMT(01)
JP3: PINHD-2X8; 2X08
SPLY_OUT: PINHD-1X3; 1X03
USER_PORT: SAMTEC-CLP-110-02-X-DJ; SAMTEC-CLP-110-02-X-D

Connections:
DF_CTS: JP3.11, USER_PORT.11
DF_DCD: JP3.9, USER_PORT.9
DF_DSR: JP3.8, USER_PORT.10
DF_DTR: JP3.12, USER_PORT.14
DF_RI: JP3.10, USER_PORT.12
DF_RTS: JP3.13, USER_PORT.13
DF_S_RX: JP3.7, USER_PORT.7
DF_S_TX: JP3.6, USER_PORT.6
GND: ANT.2 (GND), ANT.3 (GND), ANT.4 (GND), ANT.5 (GND), ANT_IN.1 (GND), ANT_IN.2 (GND), GND.1, GND.2, GND.3, GPS.2 (GND), GPS.3 (GND), GPS.4 (GND), GPS.5 (GND), GPS_OUT.1 (GND), GPS_OUT.2 (GND), JP3.3, JP3.4, USER_PORT.3, USER_PORT.4, USER_PORT.8, USER_PORT.15, USER_PORT.18
unnamed: ANT.1, ANT_IN.3 (SIG)
unnamed: GPS.1, GPS_OUT.3 (SIG)
NETWORK_AVAILABLE: JP3.15, USER_PORT.19
ON_OFF: JP3.5, USER_PORT.5
RESERVED_1: USER_PORT.16
RESERVED_2\: USER_PORT.17
SUPPLY_OUT: JP3.14, JP3.16, SPLY_OUT.1, SPLY_OUT.2, SPLY_OUT.3, USER_PORT.20
VCC5: JP3.1, JP3.2, USER_PORT.1, USER_PORT.2

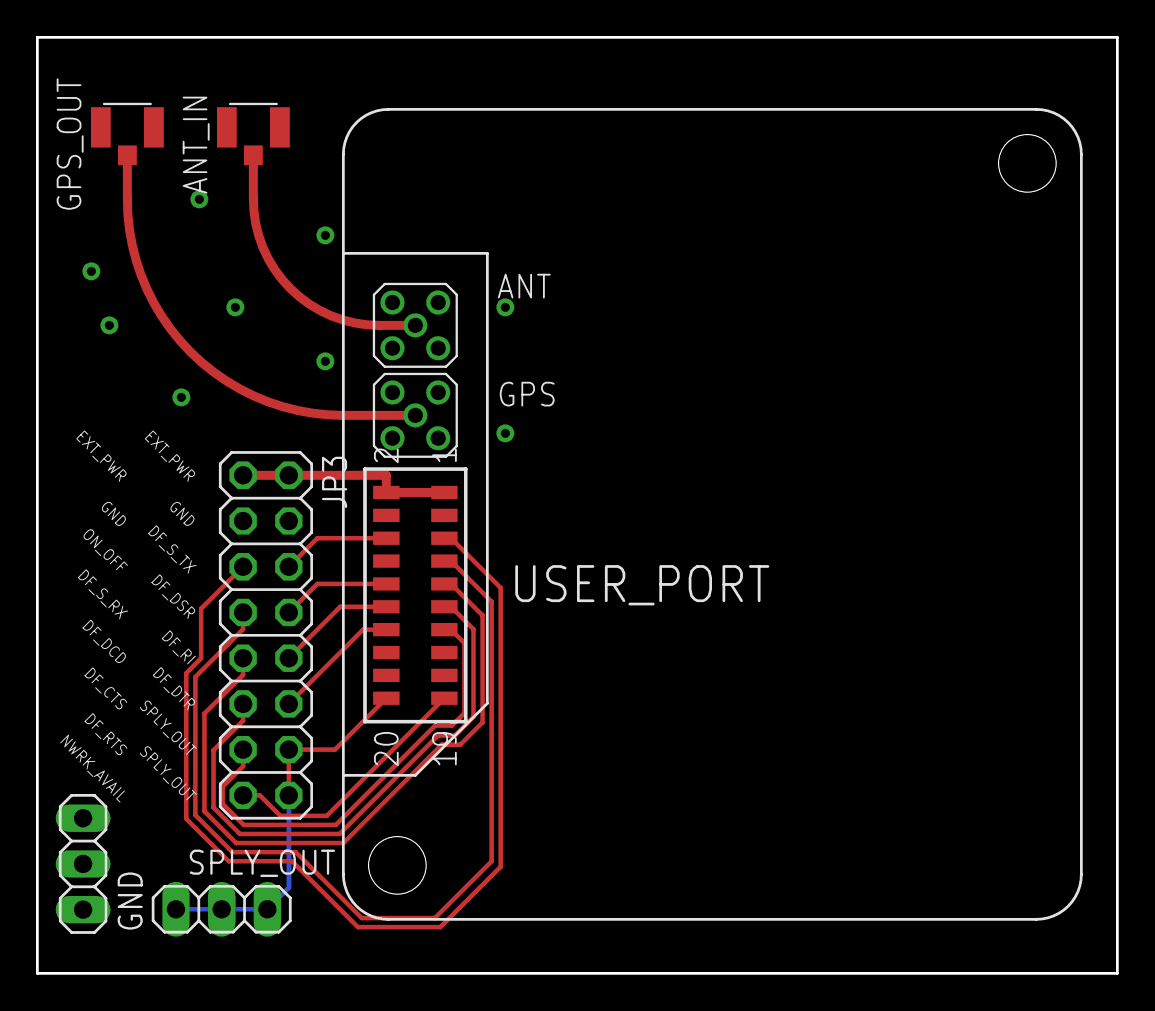
[picture p33: board iridium-9602-breakout.brd from above]

Board: 2 copper layers, 60.0 x 52.0 mm, 8 parts (0 on the bottom side), 15 nets.
