shostakovichs-spacecraft-factory/cansat-2018-2019/schematic/bumblebee/devboards/e22-breakout.brd

## EAGLE design schematic/bumblebee/devboards/e22-breakout.brd (2019-01-15)

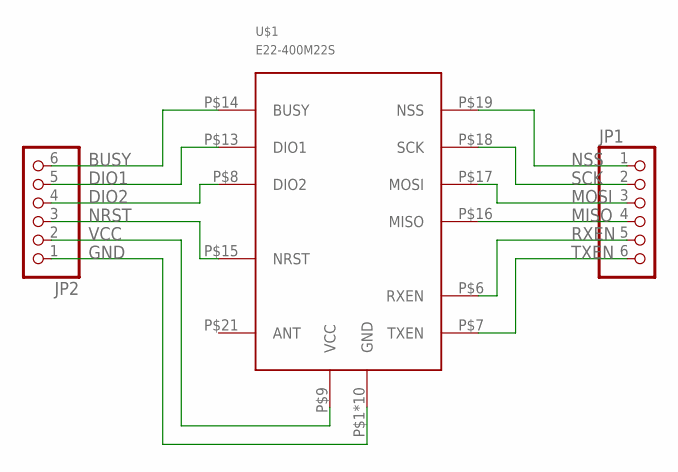
[picture p34: schematic e22-breakout.sch]

Parts:
JP1, JP2: PINHD-1X6; 1X06
U$1: E22-400M22S

Connections:
BUSY: JP2.6, U$1.P$14 (BUSY)
DIO1: JP2.5, U$1.P$13 (DIO1)
DIO2: JP2.4, U$1.P$8 (DIO2)
GND: JP2.1, U$1.P$1 (GND), U$1.P$2 (GND), U$1.P$3 (GND), U$1.P$4 (GND), U$1.P$5 (GND), U$1.P$10 (GND), U$1.P$11 (GND), U$1.P$12 (GND), U$1.P$20 (GND), U$1.P$22 (GND)
MISO: JP1.4, U$1.P$16 (MISO)
MOSI: JP1.3, U$1.P$17 (MOSI)
NRST: JP2.3, U$1.P$15 (NRST)
NSS: JP1.1, U$1.P$19 (NSS)
RXEN: JP1.5, U$1.P$6 (RXEN)
SCK: JP1.2, U$1.P$18 (SCK)
TXEN: JP1.6, U$1.P$7 (TXEN)
VCC: JP2.2, U$1.P$9 (VCC)

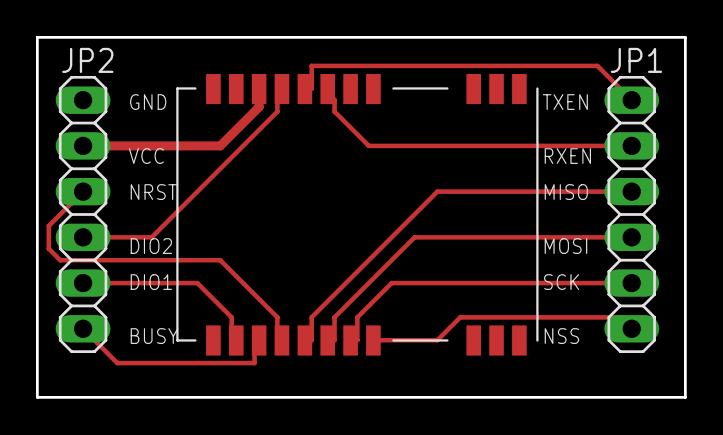
[picture p35: board e22-breakout.brd from above]

Board: 2 copper layers, 36.0 x 20.0 mm, 3 parts (0 on the bottom side), 12 nets.
