shostakovichs-spacecraft-factory/cansat-2018-2019/schematic/bumblebee/design-blocks/IRIDIUM.brd

## EAGLE design schematic/bumblebee/design-blocks/IRIDIUM.brd (2019-06-01)

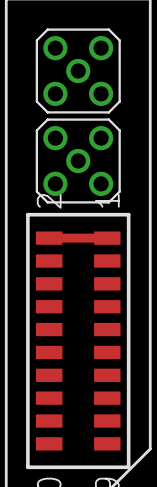
[picture p36: board IRIDIUM.brd from above]

Board: 2 copper layers, 3 parts (0 on the bottom side), 2 nets.

Parts:
ANT: MMCX-P-P-X-ST-TH1
GPS: MMCX-P-P-X-ST-TH1
USER_PORT: SAMTEC-CLP-110-02-X-DJ; SAMTEC-CLP-110-02-X-D

Connections:
GND: ANT.2, ANT.3, ANT.4, ANT.5, GPS.2, GPS.3, GPS.4, GPS.5, USER_PORT.3, USER_PORT.4, USER_PORT.8, USER_PORT.15, USER_PORT.18
VCC5: USER_PORT.1, USER_PORT.2
