shostakovichs-spacecraft-factory/cansat-2018-2019/schematic/bumblebee/layerboards/panel-icu-scu.brd

## EAGLE design schematic/bumblebee/layerboards/panel-icu-scu.brd (2019-06-01)

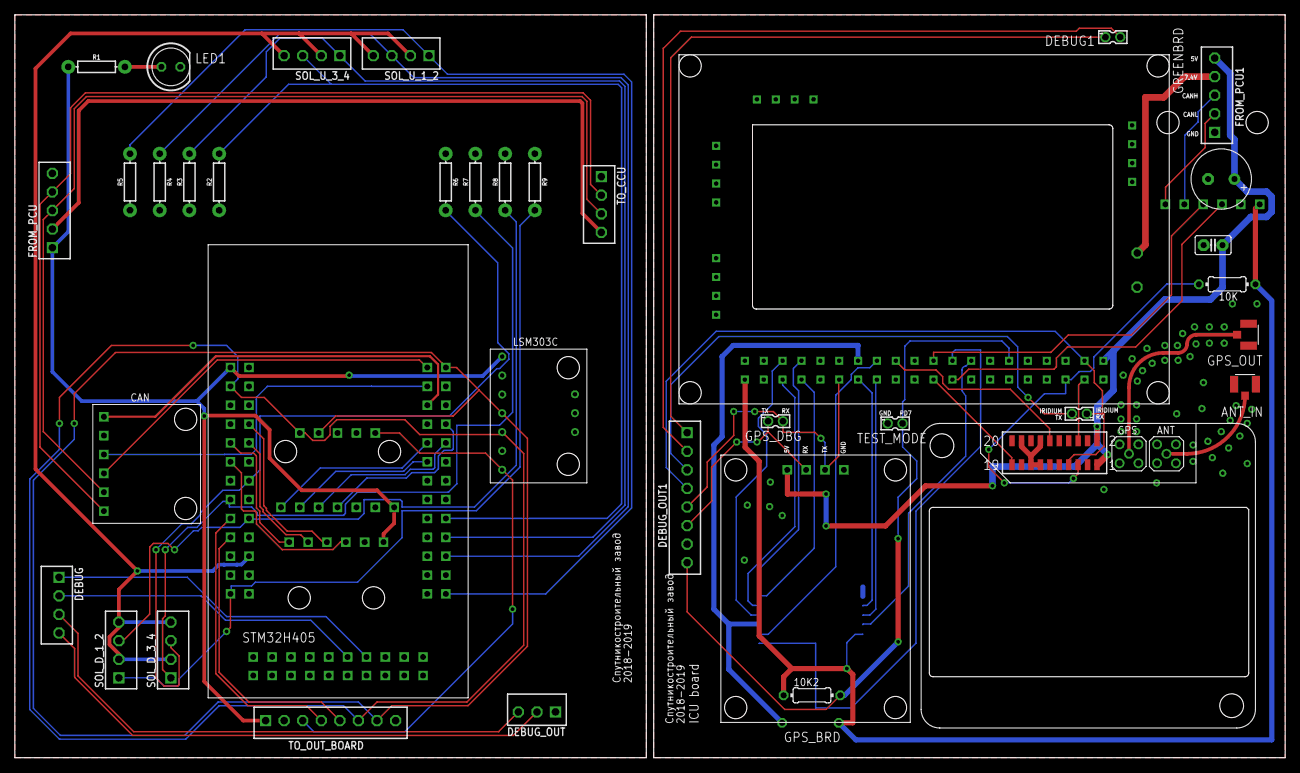
[picture p37: board panel-icu-scu.brd from above]

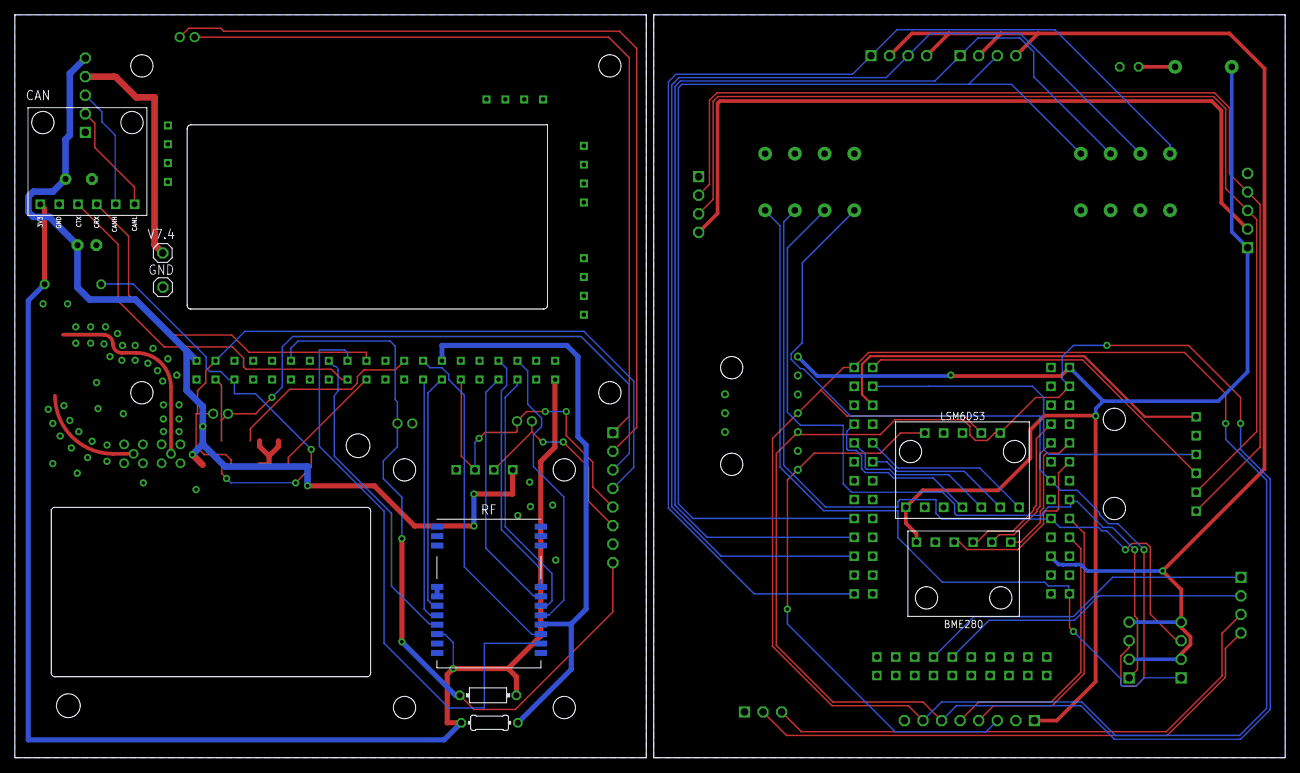
[picture p38: board panel-icu-scu.brd from below]

Board: 2 copper layers, 171.0 x 100.0 mm, 46 parts (7 on the bottom side), 65 nets.

Parts:
10K, 10K1, 10K2: 10K; 0204/7
ANT1: MMCX-P-P-X-ST-TH1
ANT_IN: U.FL-R-SMT(01); HRS_U.FL-R-SMT(01)
C1: E3,5-8
C2: C2.5-2
CAN: CAN
DEBUG: B4B-EH-A
DEBUG1: 332-02
DEBUG_OUT: B3B-EH-A
DEBUG_OUT1: B8B-EH-A
FROM_PCU, FROM_PCU1: B5B-EH-A
GND: 1X01
GPS1: MMCX-P-P-X-ST-TH1
GPS_BRD: GPS
GPS_DBG: 332-02
GPS_OUT: U.FL-R-SMT(01); HRS_U.FL-R-SMT(01)
GREENBRD: ICU
IRIDIUM: 332-02
LED1: LED5MM
R1, R2, R3, R4, R5, R6, R7, R8, R9: 150; AXIAL-0.3
RF: E22-400M22S
SOL_D_1_2, SOL_D_3_4: B4B-EH-A
SOL_U_1_2, SOL_U_3_4: B4B-EH-A
STM32H405: SCU
TEST_MODE: 332-02
TO_CCU: B4B-EH-A
TO_OUT_BOARD: B8B-EH-A
U$2: BME
U$3: LSM6DS3
U$4: LSM303C
U$7: CAN
USER_PORT1: SAMTEC-CLP-110-02-X-DJ; SAMTEC-CLP-110-02-X-D
V7.4: 1X01

Connections:
3.3V: 10K.1, 10K1.1, 10K2.1, CAN.3V3, GREENBRD.3V3_0, RF.P$9
3V3: SOL_D_1_2.2, SOL_D_1_2.4, SOL_D_3_4.2, SOL_D_3_4.4, SOL_U_1_2.2, SOL_U_1_2.4, SOL_U_3_4.2, SOL_U_3_4.4, STM32H405.3.3V
5V_CCU: FROM_PCU.2, TO_CCU.4
5V_ICU: C1.+, C2.2, FROM_PCU1.5, GPS_BRD.UCC, GREENBRD.5V_0, USER_PORT1.1, USER_PORT1.2
5V_SCU: FROM_PCU.1, R1.P$1, STM32H405.VIN, TO_OUT_BOARD.1, U$2.UCC, U$3.VIN, U$4.5V
7.4V: FROM_PCU1.4, V7.4.1
ADC_OUT_1: STM32H405.PA1, TO_OUT_BOARD.5
ADC_OUT_2: STM32H405.PA3, TO_OUT_BOARD.4
DF_RI: GREENBRD.PC9, USER_PORT1.12
DF_S_RX: DEBUG_OUT1.4, GREENBRD.PB7, IRIDIUM.1, USER_PORT1.7
DF_S_TX: DEBUG_OUT1.3, GREENBRD.PB6, IRIDIUM.2, USER_PORT1.6
GND: FROM_PCU.5, LED1.K, R2.P$1, R3.P$1, R4.P$2, R5.P$1, R6.P$1, R7.P$2, R8.P$2, R9.P$1, STM32H405.GND_2, TO_CCU.1, TO_OUT_BOARD.2, U$2.GND, U$3.GND, U$4.GND, U$7.GND
GND1: ANT1.2, ANT1.3, ANT1.4, ANT1.5, ANT_IN.1, ANT_IN.2, C1.-, C2.1, CAN.GND, DEBUG_OUT1.7, FROM_PCU1.1, GND.1, GPS1.2, GPS1.3, GPS1.4, GPS1.5, GPS_BRD.GND, GPS_OUT.1, GPS_OUT.2, GREENBRD.GND_0, GREENBRD.GND_1, RF.P$1, RF.P$2, RF.P$3, RF.P$4, RF.P$5, RF.P$10, RF.P$11, RF.P$12, RF.P$20, RF.P$22, TEST_MODE.1, USER_PORT1.3, USER_PORT1.4, USER_PORT1.8, USER_PORT1.13, USER_PORT1.14, USER_PORT1.15, USER_PORT1.18
MAG_CS: TO_OUT_BOARD.3, U$3.OCS, U$4.CSM
MISO_2: STM32H405.PB14, U$2.SD0
MISO_3: STM32H405.PC11, U$3.SAD
MOSI_2: STM32H405.PB15, U$2.SDA
MOSI_3: STM32H405.PC12, U$3.SDA
unnamed: GREENBRD.PB14, RF.P$16
unnamed: GREENBRD.PB12, RF.P$19
unnamed: GREENBRD.PE15, RF.P$6
unnamed: ANT1.1, ANT_IN.3
unnamed: GPS1.1, GPS_OUT.3
unnamed: STM32H405.PA11, U$7.CRX
unnamed: STM32H405.PA12, U$7.CTX
unnamed: GREENBRD.PB13, RF.P$18
unnamed: CAN.CANL, FROM_PCU1.2
unnamed: CAN.CRX, GREENBRD.PD1
unnamed: CAN.CANH, FROM_PCU1.3
unnamed: GREENBRD.PD15, RF.P$13
unnamed: GREENBRD.PD13, RF.P$8
unnamed: CAN.CTX, GREENBRD.PD0
unnamed: GREENBRD.PB15, RF.P$17
unnamed: STM32H405.+3.3V, U$7.3V3
unnamed: GREENBRD.PE12, RF.P$14
unnamed: 10K1.2, GREENBRD.PE14, RF.P$15
unnamed: LED1.A, R1.P$2
unnamed: DEBUG.1, STM32H405.SW-DAT
unnamed: FROM_PCU.3, TO_CCU.3, U$7.CANH
unnamed: DEBUG.2, STM32H405.SW-CLK
unnamed: FROM_PCU.4, TO_CCU.2, U$7.CANL
unnamed: DEBUG.3, DEBUG_OUT.3
unnamed: DEBUG.4, DEBUG_OUT.2
unnamed: GREENBRD.PE13, RF.P$7
NETWORK_AVAILABLE: GREENBRD.PE7, USER_PORT1.19
NSS_2: STM32H405.PB12, U$2.CSB
NSS_3: STM32H405.PD2, U$3.CS
ON_OFF: 10K.2, GREENBRD.PB4, USER_PORT1.5
PD7: 10K2.2, DEBUG_OUT1.8, GREENBRD.PD7, TEST_MODE.2
RX_GPS: DEBUG_OUT1.6, GPS_BRD.RX, GPS_DBG.1
SCK_2: STM32H405.PB13, U$2.SCL
SCK_3: STM32H405.PC10, U$3.SCL
SCL3: STM32H405.PA8, TO_OUT_BOARD.7, U$3.SCX, U$4.SCL
SDA3: STM32H405.PC9, TO_OUT_BOARD.6, U$3.SDX, U$4.SDA
SOL_D_1: R9.P$2, SOL_D_1_2.1, STM32H405.PC2
SOL_D_2: R8.P$1, SOL_D_1_2.3, STM32H405.PC3
SOL_D_3: R7.P$1, SOL_D_3_4.1, STM32H405.PC4
SOL_D_4: R6.P$2, SOL_D_3_4.3, STM32H405.PC5
SOL_U_1: R5.P$2, SOL_U_1_2.1, STM32H405.PB1
SOL_U_2: R4.P$1, SOL_U_1_2.3, STM32H405.PA7
SOL_U_3: R3.P$2, SOL_U_3_4.1, STM32H405.PC1
SOL_U_4: R2.P$2, SOL_U_3_4.3, STM32H405.PA5
SWC: DEBUG1.2, DEBUG_OUT1.2
SWD: DEBUG1.1, DEBUG_OUT1.1
TX_GPS: DEBUG_OUT1.5, GPS_BRD.TX, GPS_DBG.2, GREENBRD.PD9
