shostakovichs-spacecraft-factory/cansat-2018-2019/schematic/bumblebee/layerboards/All_Plate_Release.brd

## EAGLE design schematic/bumblebee/layerboards/All_Plate_Release.brd (2019-06-01)

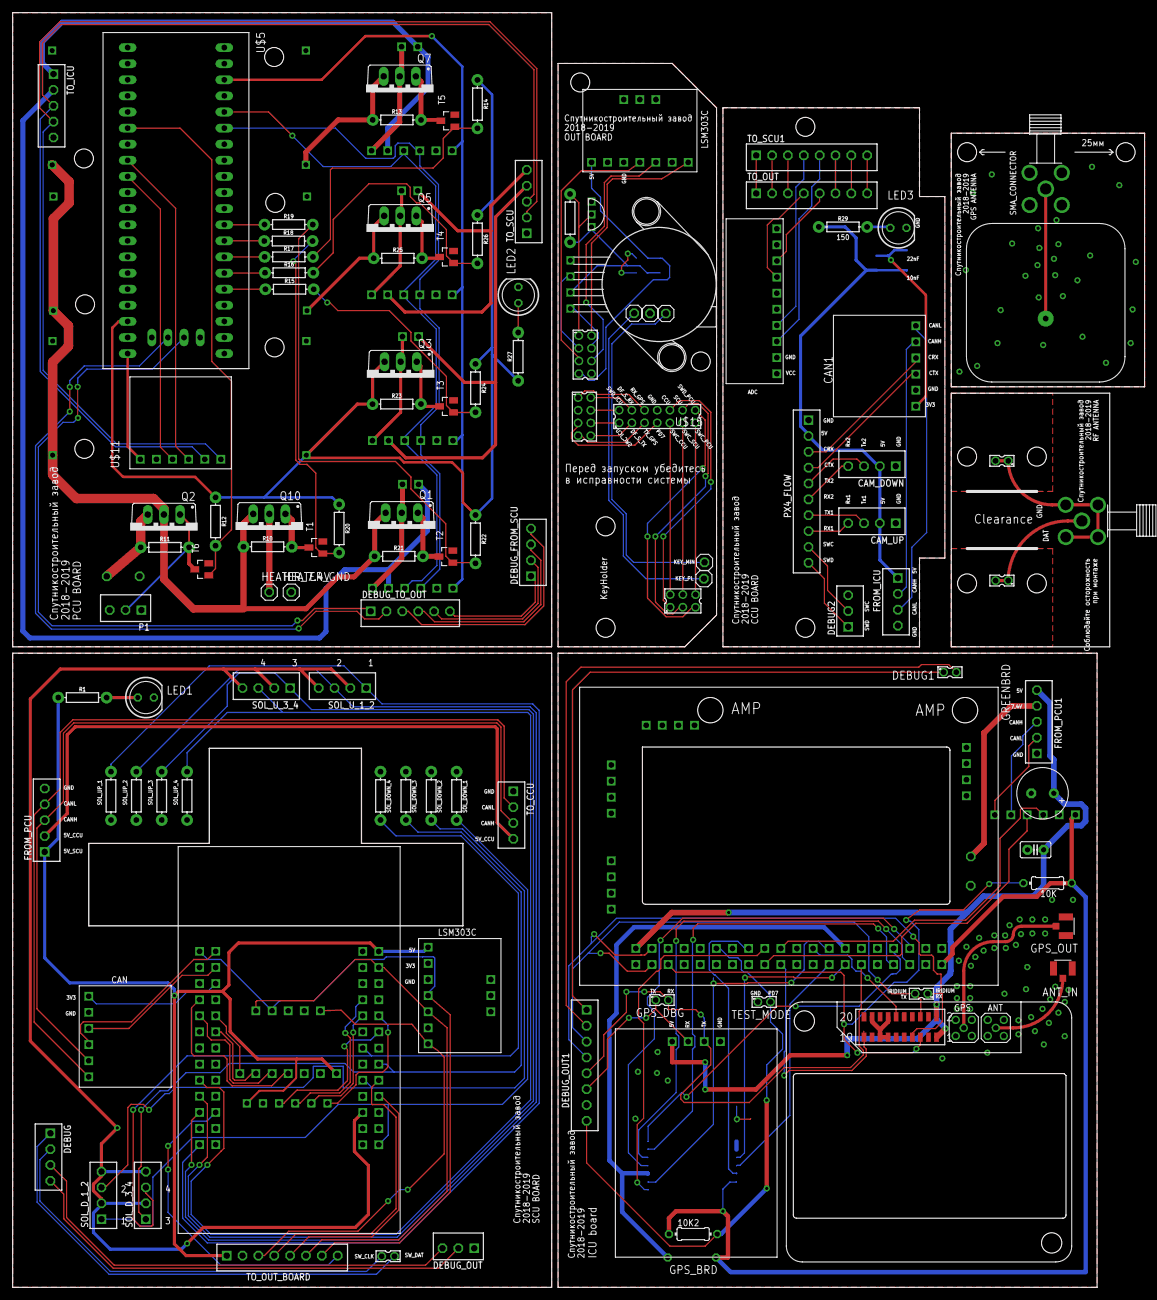
[picture p39: board All_Plate_Release.brd from above]

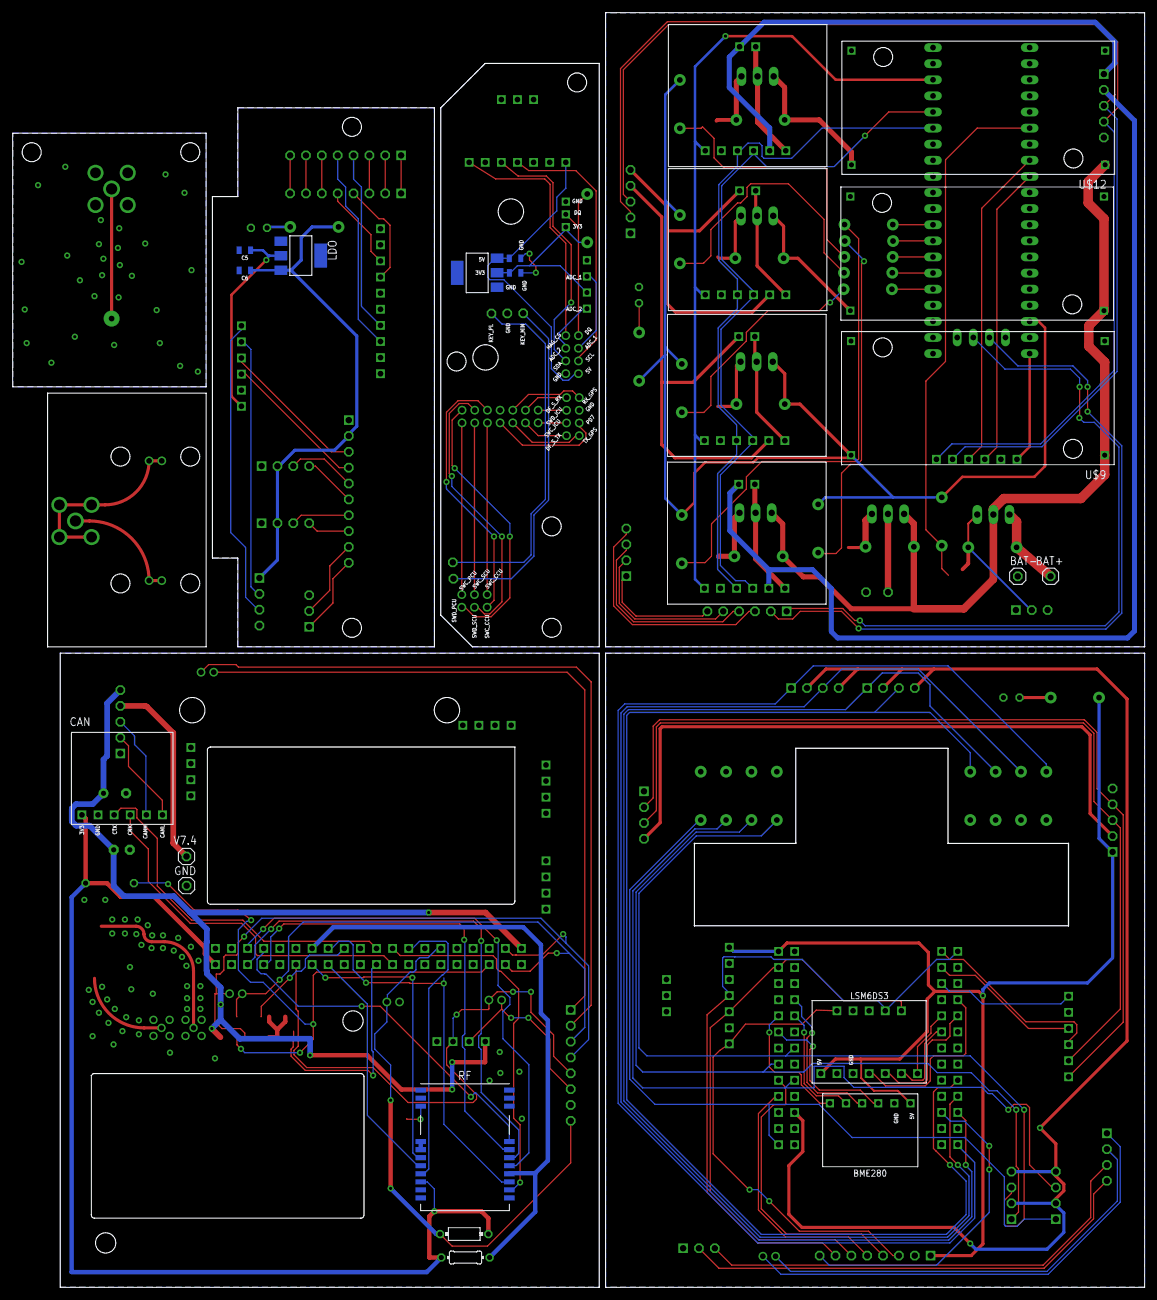
[picture p40: board All_Plate_Release.brd from below]

Board: 2 copper layers, 178.5 x 201.0 mm, 131 parts (22 on the bottom side), 164 nets.

Parts:
10K, 10K1, 10K2: 10K; 0204/7
ANT1: MMCX-P-P-X-ST-TH1
ANT_IN: U.FL-R-SMT(01); HRS_U.FL-R-SMT(01)
BAT+: 1X01
BAT-: 1X01
C1: E3,5-8
C2: C2.5-2
C3, C5: 22uF; 0805
C4, C6: 10uF; 0805
CAM_DOWN: B4B-EH-A
CAM_UP: B4B-EH-A
CAN, CAN1: CAN
DEBUG: B4B-EH-A
DEBUG1: 332-02
DEBUG2: B3B-EH-A
DEBUG_FROM_SCU: B4B-EH-A
DEBUG_OUT: B3B-EH-A
DEBUG_OUT1: B8B-EH-A
DEBUG_TO_OUT: B6B-EH-A
FROM_ICU: B4B-EH-A
FROM_PCU, FROM_PCU1: B5B-EH-A
GND: 1X01
GPS1: MMCX-P-P-X-ST-TH1
GPS_BRD: GPS
GPS_DBG: 332-02
GPS_OUT: U.FL-R-SMT(01); HRS_U.FL-R-SMT(01)
GREENBRD: ICU
HEATER_7.4V: 1X01
HEATER_GND: 1X01
IC1: REG1117; SOT223
IRIDIUM: 332-02
J1: 221790-1; TE_221790-1
JP1, JP2, JP6, JP7, JP8: 1X01
LDO: REG1117; SOT223
LED1, LED2, LED3: LED5MM
P1: B3B-EH-A
PX4_FLOW: B10B-EH-A
Q1, Q2, Q3, Q5, Q7, Q10: IRF9530; TO220BV
R1, R2, R3, R4, R5, R6, R7, R8, R9, R27, R29: 150; AXIAL-0.3
R10, R11, R12, R13, R14, R20, R21, R22, R23, R24, R25, R26: 10k; AXIAL-0.3
R15, R16, R17, R18, R19: 10; AXIAL-0.3
R28: 4k7; AXIAL-0.3
RF: E22-400M22S
SMA_CONNECTOR: 221790-1; TE_221790-1
SOL_D_1_2, SOL_D_3_4: B4B-EH-A
SOL_U_1_2, SOL_U_3_4: B4B-EH-A
T1, T2, T3, T4, T5, T6: 2N7002E; SOT23
TEST_MODE: 332-02
TO_CCU: B4B-EH-A
TO_ICU: B5B-EH-A
TO_OUT: B8B-EH-A
TO_OUT_BOARD: B8B-EH-A
TO_SCU: B5B-EH-A
TO_SCU1: B8B-EH-A
U$1: SCU
U$2: BME
U$3: LSM6DS3
U$4, U$17: LSM303C
U$5: BLUEPILLTHEONLYONE; BLUEPIL
U$6, U$8, U$13, U$14: INA
U$7, U$11: CAN
U$9, U$10, U$12: DCDC
U$15: MPX
U$16: TEMP
U$18: ADS
U$19: BY-IRIDIUM-254
USER_PORT1: SAMTEC-CLP-110-02-X-DJ; SAMTEC-CLP-110-02-X-D
V7.4: 1X01
X1, X6, X7: 332-02
X2: 332-14
X3, X4: 332-08
X5: 332-06

Connections:
3.3V: 10K.1, 10K1.1, 10K2.1, CAN.3V3, GREENBRD.3V3_0, RF.P$9
3V1: U$5.3V3_0, U$5.3V3_1, U$5.3V3_2, U$6.VCC, U$8.VCC, U$11.3V3, U$13.VCC, U$14.VCC
3V2: C3.1, IC1.2, R28.P$1, U$15.VCC, U$16.VDD
3V3: SOL_D_1_2.2, SOL_D_1_2.4, SOL_D_3_4.2, SOL_D_3_4.4, SOL_U_1_2.2, SOL_U_1_2.4, SOL_U_3_4.2, SOL_U_3_4.4, U$1.3.3V
3V4: C5.1, CAN1.3V3, LDO.2
5V: C4.1, IC1.3, U$17.5V, X3.7
5V_CCU: FROM_PCU.2, TO_CCU.4
5V_CCU1: TO_SCU.4, U$14.VIN-_0, U$14.VIN-_1
5V_CCU2: C6.1, CAM_DOWN.2, CAM_UP.2, FROM_ICU.1, LDO.3, PX4_FLOW.2, R29.P$1
5V_CONTINUOUS: Q3.S, R12.P$1, R14.P$1, R20.P$1, R22.P$1, R23.P$1, R24.P$1, R26.P$1, R27.P$1, U$5.5V, U$9.OUT+
5V_ICU: C1.+, C2.2, FROM_PCU1.5, GPS_BRD.UCC, GREENBRD.5V_0, USER_PORT1.1, USER_PORT1.2
5V_ICU1: TO_ICU.1, U$6.VIN-_0, U$6.VIN-_1
5V_SCU: FROM_PCU.1, R1.P$1, TO_OUT_BOARD.1, U$1.VIN, U$2.VCC, U$3.VIN, U$4.5V
5V_SCU1: TO_SCU.5, U$13.VIN-_0, U$13.VIN-_1
7.4V: FROM_PCU1.4, V7.4.1
7.4V1: TO_ICU.2, U$8.VIN-_0, U$8.VIN-_1
ADC_1: U$15.V1, X3.3
ADC_2: U$15.V2, X3.4
ADC_OUT_1: TO_OUT_BOARD.5, U$1.PA1
ADC_OUT_2: TO_OUT_BOARD.4, U$1.PA3
CANH: TO_ICU.3, TO_SCU.3, U$11.CANH
CANL: TO_ICU.4, TO_SCU.2, U$11.CANL
CRX: CAN1.CRX, PX4_FLOW.3
CTX: CAN1.CTX, PX4_FLOW.4
DAT: J1.1, X6.1, X6.2
DF_RI: GREENBRD.PC9, USER_PORT1.12
DF_S_RX: DEBUG_OUT1.4, GREENBRD.PB7, IRIDIUM.1, USER_PORT1.7
DF_S_RX1: X2.4, X4.2
DF_S_TX: DEBUG_OUT1.3, GREENBRD.PB6, IRIDIUM.2, USER_PORT1.6
DF_S_TX1: X2.3, X4.8
DQ: R28.P$2, U$16.DQ, X3.1
DQ_TEMP: TO_OUT_BOARD.8, U$1.PB0
GND: FROM_PCU.5, LED1.K, R2.P$1, R3.P$1, R4.P$2, R5.P$1, R6.P$1, R7.P$2, R8.P$2, R9.P$1, TO_CCU.1, TO_OUT_BOARD.2, U$1.GND_2, U$2.GND, U$3.GND, U$4.GND, U$7.GND
GND1: ANT1.2, ANT1.3, ANT1.4, ANT1.5, ANT_IN.1, ANT_IN.2, C1.-, C2.1, CAN.GND, DEBUG_OUT1.7, FROM_PCU1.1, GND.1, GPS1.2, GPS1.3, GPS1.4, GPS1.5, GPS_BRD.GND, GPS_OUT.1, GPS_OUT.2, GREENBRD.GND_0, GREENBRD.GND_1, RF.P$1, RF.P$2, RF.P$3, RF.P$4, RF.P$5, RF.P$10, RF.P$11, RF.P$12, RF.P$20, RF.P$22, TEST_MODE.1, USER_PORT1.3, USER_PORT1.4, USER_PORT1.8, USER_PORT1.13, USER_PORT1.14, USER_PORT1.15, USER_PORT1.18
GND2: BAT-.1, HEATER_GND.1, LED2.K, P1.1, P1.3, T1.2, T2.2, T3.2, T4.2, T5.2, T6.2, TO_ICU.5, TO_SCU.1, U$5.GND0, U$5.GND1, U$5.GND2, U$5.GND3, U$6.GND, U$8.GND, U$9.IN-, U$9.OUT-, U$10.IN-, U$10.OUT-, U$11.GND, U$12.IN-, U$12.OUT-, U$13.GND, U$14.GND
GND3: C3.2, C4.2, IC1.1, JP7.1, U$15.GND, U$16.GND, U$17.GND, X2.8, X3.8, X4.3
GND4: C5.2, C6.2, CAM_DOWN.1, CAM_UP.1, CAN1.GND, FROM_ICU.4, LDO.1, LED3.K, PX4_FLOW.1
GND5: J1.2, J1.3, J1.4, J1.5, X7.1, X7.2
GND6: SMA_CONNECTOR.2, SMA_CONNECTOR.3, SMA_CONNECTOR.4, SMA_CONNECTOR.5
HEATER_7.4V: HEATER_7.4V.1, Q10.D
KEY_1: BAT+.1, Q2.S, R11.P$1
KEY_2: Q1.S, Q2.D, Q10.S, R10.P$1, R21.P$1, U$9.IN+, U$10.IN+, U$12.IN+
KEY_MINUS: JP1.1, JP6.1
KEY_PLUS: JP2.1, JP8.1
KILLSWITCH: R12.P$2, T6.1, U$5.A9
MAG_CS: TO_OUT_BOARD.3, U$3.OCS, U$4.CSM
MAG_CS1: U$17.CSM, X3.2
MISO_2: U$1.PB14, U$2.SDO
MISO_3: U$1.PC11, U$3.SAD
MOSI_2: U$1.PB15, U$2.SDA
MOSI_3: U$1.PC12, U$3.SDA
unnamed: GREENBRD.PB14, RF.P$16
unnamed: GREENBRD.PB12, RF.P$19
unnamed: GREENBRD.PE15, RF.P$6
unnamed: ANT1.1, ANT_IN.3
unnamed: GPS1.1, GPS_OUT.3
unnamed: U$1.PA11, U$7.CRX
unnamed: U$1.PA12, U$7.CTX
unnamed: GREENBRD.PB13, RF.P$18
unnamed: CAN.CANL, FROM_PCU1.2
unnamed: CAN.CTX, GREENBRD.PD1
unnamed: CAN.CANH, FROM_PCU1.3
unnamed: GREENBRD.PD15, RF.P$13
unnamed: GREENBRD.PD13, RF.P$8
unnamed: CAN.CRX, GREENBRD.PD0
unnamed: GREENBRD.PB15, RF.P$17
unnamed: U$1.+3.3V, U$7.3V3
unnamed: GREENBRD.PE12, RF.P$14
unnamed: 10K1.2, GREENBRD.PE14, RF.P$15
unnamed: LED1.A, R1.P$2
unnamed: FROM_PCU.3, TO_CCU.3, U$7.CANH
unnamed: FROM_PCU.4, TO_CCU.2, U$7.CANL
unnamed: DEBUG.3, DEBUG_OUT.3
unnamed: DEBUG.4, DEBUG_OUT.2
unnamed: GREENBRD.PE13, RF.P$7
unnamed: Q1.G, R21.P$2, T2.3
unnamed: Q3.G, R23.P$2, T3.3
unnamed: Q5.G, R25.P$2, T4.3
unnamed: Q5.S, R25.P$1, U$10.OUT+
unnamed: Q7.G, R13.P$2, T5.3
unnamed: Q7.S, R13.P$1, U$12.OUT+
unnamed: Q3.D, U$14.VIN+_0, U$14.VIN+_1
unnamed: Q5.D, U$13.VIN+_0, U$13.VIN+_1
unnamed: Q7.D, U$6.VIN+_0, U$6.VIN+_1
unnamed: Q1.D, U$8.VIN+_0, U$8.VIN+_1
unnamed: U$5.B10, U$6.SCL, U$8.SCL, U$13.SCL, U$14.SCL
unnamed: U$5.B11, U$6.SDA, U$8.SDA, U$13.SDA, U$14.SDA
unnamed: U$5.A12, U$11.CTX
unnamed: U$5.A11, U$11.CRX
unnamed: LED2.A, R27.P$2
unnamed: Q10.G, R10.P$2, T1.3
unnamed: R15.P$1, U$5.A0
unnamed: R16.P$1, U$5.A1
unnamed: R17.P$1, U$5.A2
unnamed: R18.P$1, U$5.A3
unnamed: R19.P$1, U$5.A4
unnamed: P1.2, Q2.G, R11.P$2, T6.3
unnamed: CAN1.CANL, FROM_ICU.3
unnamed: CAN1.CANH, FROM_ICU.2
unnamed: LED3.A, R29.P$2
unnamed: TO_OUT.8, TO_SCU1.8
unnamed: TO_OUT.7, TO_SCU1.7
unnamed: TO_OUT.6, TO_SCU1.6
unnamed: TO_OUT.3, TO_SCU1.3
unnamed: TO_OUT.2, TO_SCU1.2
unnamed: TO_OUT.1, TO_SCU1.1
unnamed: TO_SCU1.5, U$18.SCL
unnamed: TO_SCU1.4, U$18.SDA
unnamed: TO_OUT.5, U$18.A1
unnamed: TO_OUT.4, U$18.A0
unnamed: SMA_CONNECTOR.1, U$19.P$1
NETWORK_AVAILABLE: GREENBRD.PE7, USER_PORT1.19
NSS_2: U$1.PB12, U$2.CSB
NSS_3: U$1.PD2, U$3.CS
ON_OFF: 10K.2, GREENBRD.PB4, USER_PORT1.5
PCTRL_AMP: R19.P$2, R22.P$2, T2.1
PCTRL_CCU: R15.P$2, R24.P$2, T3.1
PCTRL_HEATER: R18.P$2, R20.P$2, T1.1
PCTRL_ICU: R14.P$2, R17.P$2, T5.1
PCTRL_SCU: R16.P$2, R26.P$2, T4.1
PD1: X2.7, X4.5
PD7: 10K2.2, DEBUG_OUT1.8, GREENBRD.PD7, TEST_MODE.2
RX1: CAM_UP.4, PX4_FLOW.8
RX2: CAM_DOWN.4, PX4_FLOW.6
RX_GPS: DEBUG_OUT1.6, GPS_BRD.RX, GPS_DBG.1
RX_GPS1: X2.6, X4.1
SCK_2: U$1.PB13, U$2.SCL
SCK_3: U$1.PC10, U$3.SCL
SCL: U$17.SCL, X3.5
SCL3: TO_OUT_BOARD.7, U$1.PA8, U$3.SCX, U$4.SCL
SDA: U$17.SDA, X3.6
SDA3: TO_OUT_BOARD.6, U$1.PC9, U$3.SDX, U$4.SDA
SOL_D_1: R9.P$2, SOL_D_1_2.1, U$1.PC2
SOL_D_2: R8.P$1, SOL_D_1_2.3, U$1.PC3
SOL_D_3: R7.P$1, SOL_D_3_4.1, U$1.PC4
SOL_D_4: R6.P$2, SOL_D_3_4.3, U$1.PC5
SOL_U_1: R5.P$2, SOL_U_1_2.1, U$1.PB1
SOL_U_2: R4.P$1, SOL_U_1_2.3, U$1.PA7
SOL_U_3: R3.P$2, SOL_U_3_4.1, U$1.PC1
SOL_U_4: R2.P$2, SOL_U_3_4.3, U$1.PA5
SWC: DEBUG1.2, DEBUG_OUT1.2
SWC1: DEBUG2.2, PX4_FLOW.9
SWCLK_0: DEBUG_TO_OUT.1, U$5.SWCLK
SWCLK_2: DEBUG_FROM_SCU.3, DEBUG_TO_OUT.4
SWCLK_3: DEBUG_FROM_SCU.1, DEBUG_TO_OUT.6
SWCLK_CCU: X2.9, X5.2
SWCLK_PCU: X2.13, X5.6
SWCLK_SCU: X2.11, X5.4
SWC_ICU: X2.1, X4.6
SWD: DEBUG1.1, DEBUG_OUT1.1
SWD1: DEBUG2.1, PX4_FLOW.10
SWDIO_0: DEBUG_TO_OUT.2, U$5.SWDIO
SWDIO_2: DEBUG_FROM_SCU.4, DEBUG_TO_OUT.3
SWDIO_3: DEBUG_FROM_SCU.2, DEBUG_TO_OUT.5
SWDIO_CCU: X2.10, X5.1
SWDIO_PCU: X2.14, X5.5
SWDIO_SCU: X2.12, X5.3
SWD_ICU: X2.2, X4.4
SW_CLK: DEBUG.2, X1.2
SW_DAT: DEBUG.1, X1.1
TX1: CAM_UP.3, PX4_FLOW.7
TX2: CAM_DOWN.3, PX4_FLOW.5
TX_GPS: DEBUG_OUT1.5, GPS_BRD.TX, GPS_DBG.2, GREENBRD.PD9
TX_GPS1: X2.5, X4.7
