shostakovichs-spacecraft-factory/cansat-2018-2019/schematic/bumblebee/layerboards/panel-ccu-pcu-out.brd

## EAGLE design schematic/bumblebee/layerboards/panel-ccu-pcu-out.brd (2019-06-01)

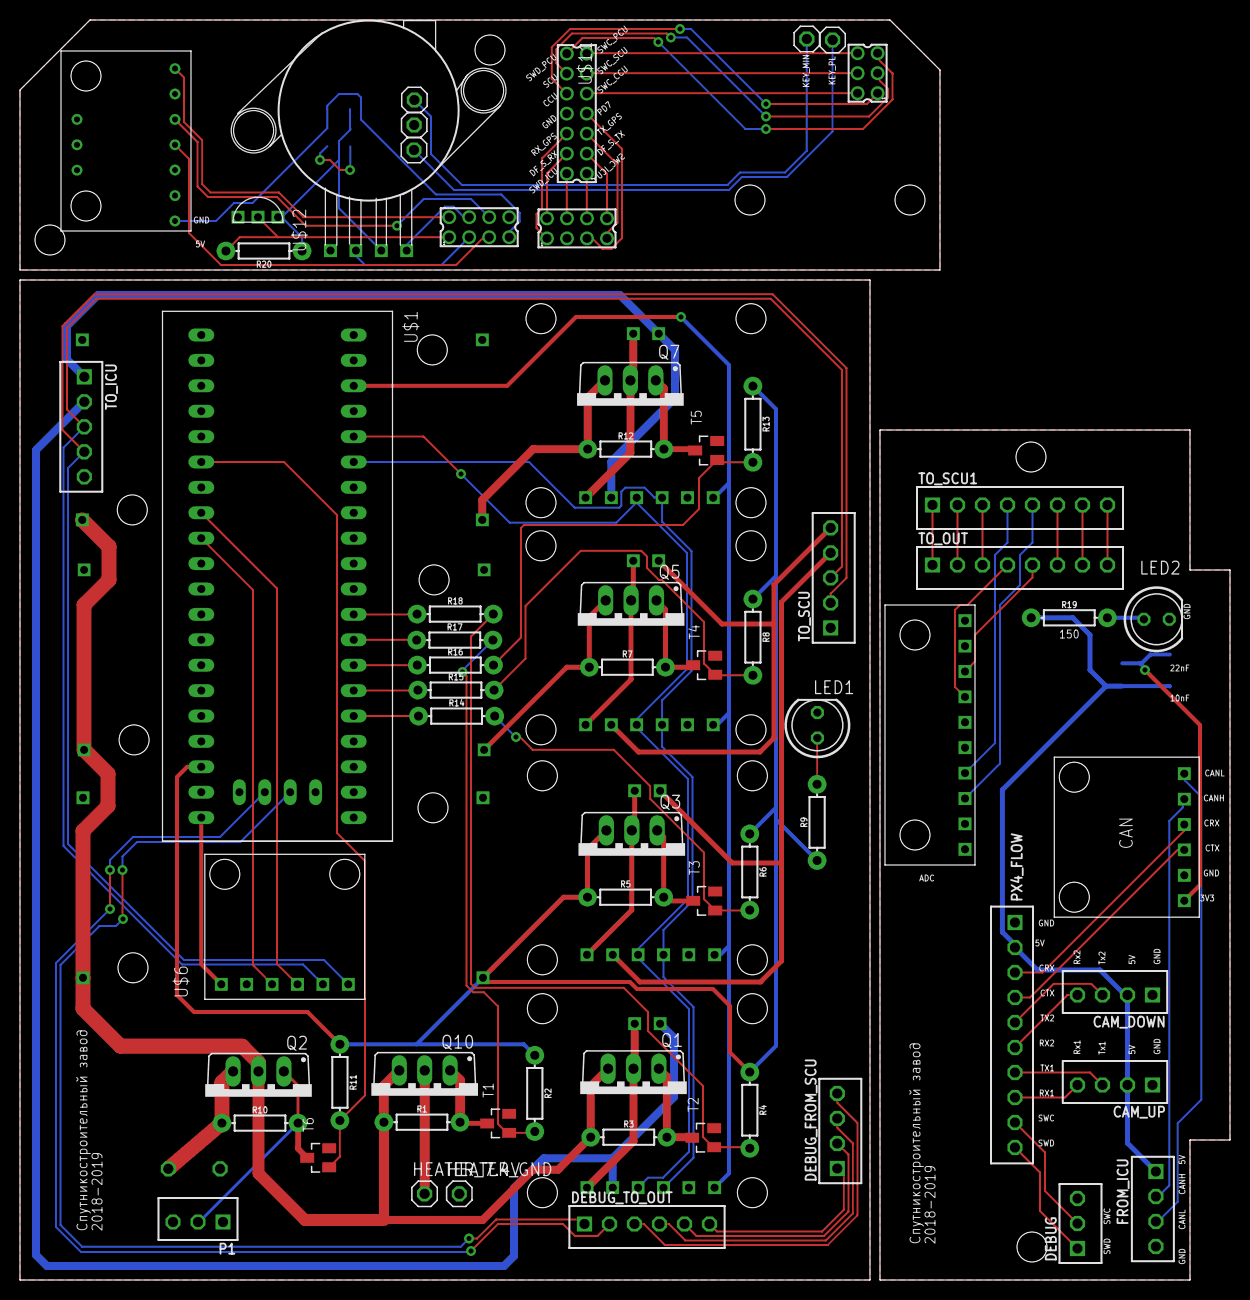
[picture p41: board panel-ccu-pcu-out.brd from above]

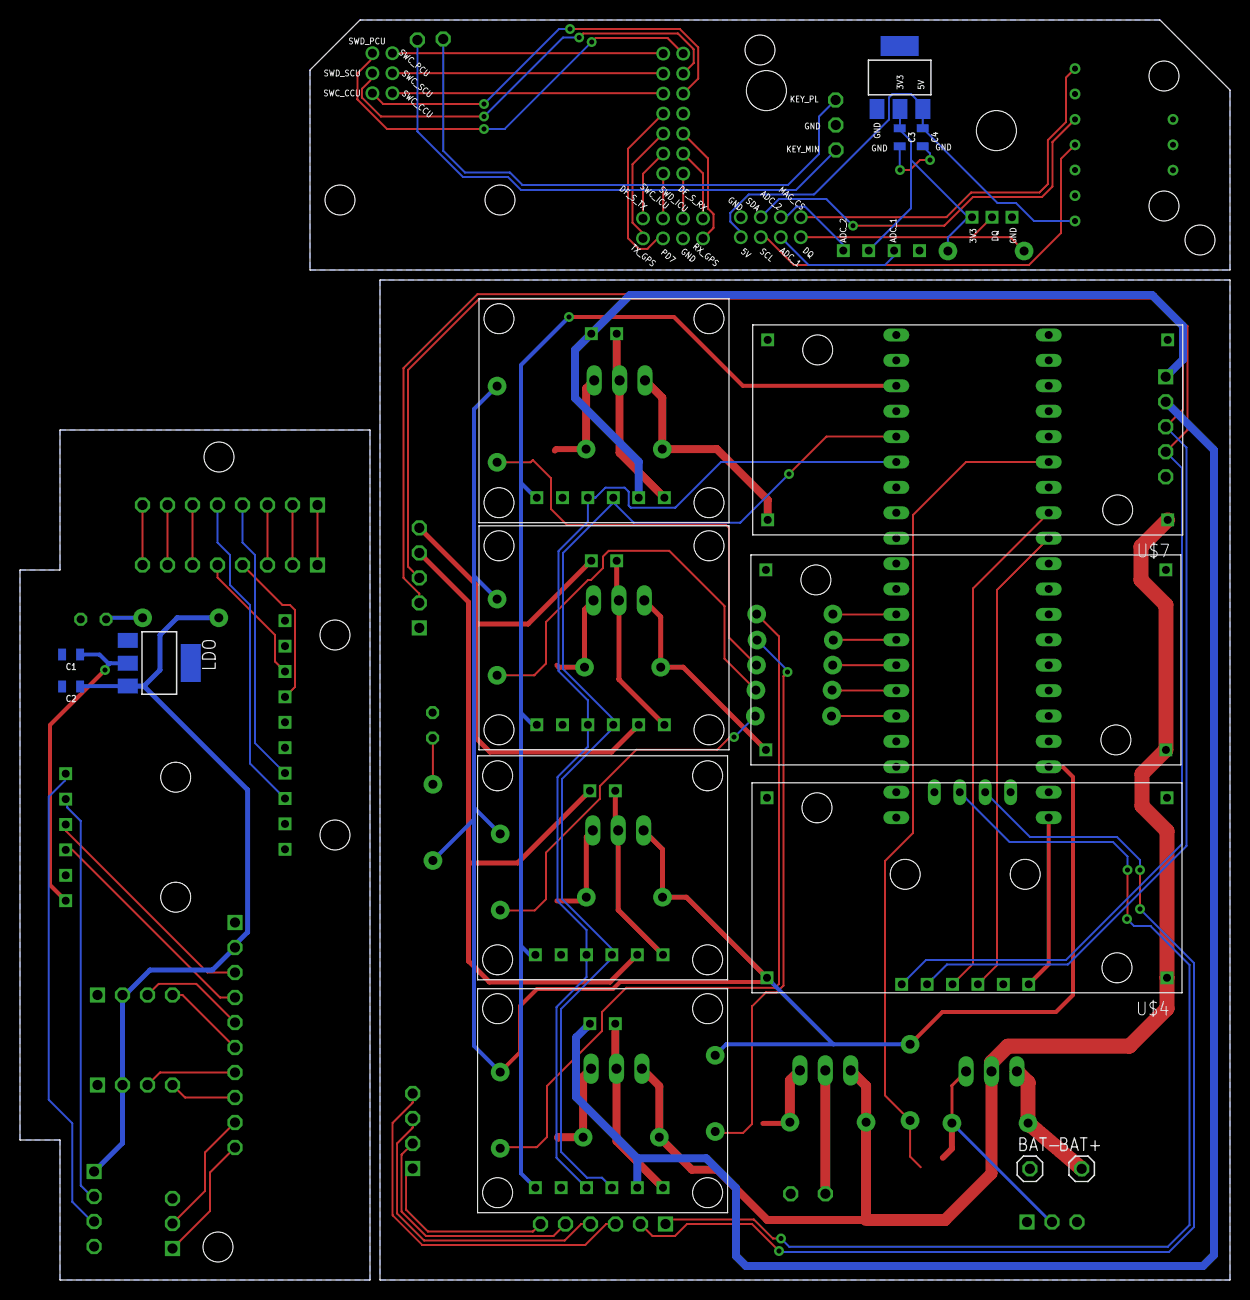
[picture p42: board panel-ccu-pcu-out.brd from below]

Board: 2 copper layers, 121.0 x 126.0 mm, 79 parts (15 on the bottom side), 94 nets.

Parts:
BAT+: 1X01
BAT-: 1X01
C1, C3: 22uF; 0805
C2, C4: 10uF; 0805
CAM_DOWN: B4B-EH-A
CAM_UP: B4B-EH-A
CAN: CAN
DEBUG: B3B-EH-A
DEBUG_FROM_SCU: B4B-EH-A
DEBUG_TO_OUT: B6B-EH-A
FROM_ICU: B4B-EH-A
HEATER_7.4V: 1X01
HEATER_GND: 1X01
IC1: REG1117; SOT223
JP1, JP2, JP6, JP7, JP8: 1X01
LDO: REG1117; SOT223
LED1, LED2: LED5MM
P1: B3B-EH-A
PX4_FLOW: B10B-EH-A
Q1, Q2, Q3, Q5, Q7, Q10: IRF9530; TO220BV
R1, R2, R3, R4, R5, R6, R7, R8, R10, R11, R12, R13: 10k; AXIAL-0.3
R9, R19: 150; AXIAL-0.3
R14, R15, R16, R17, R18: 10; AXIAL-0.3
R20: 4k7; AXIAL-0.3
T1, T2, T3, T4, T5, T6: 2N7002E; SOT23
TO_ICU: B5B-EH-A
TO_OUT: B8B-EH-A
TO_SCU: B5B-EH-A
TO_SCU1: B8B-EH-A
U$1: BLUEPILLTHEONLYONE; BLUEPIL
U$2, U$3, U$8, U$9: INA
U$4, U$5, U$7: DCDC
U$6: CAN
U$10: ADS
U$11: MPX
U$12: TEMP
U$13: LSM303C
X1: 332-14
X2, X3: 332-08
X4: 332-06

Connections:
3V1: C1.1, CAN.3V3, LDO.2
3V2: C3.1, IC1.2, R20.P$1, U$11.VCC, U$12.VDD
3V3: U$1.3V3_0, U$1.3V3_1, U$1.3V3_2, U$2.VCC, U$3.VCC, U$6.3V3, U$8.VCC, U$9.VCC
5V: C4.1, IC1.3, U$13.5V, X2.7
5V_CCU: TO_SCU.4, U$9.VIN-_0, U$9.VIN-_1
5V_CCU1: C2.1, CAM_DOWN.2, CAM_UP.2, FROM_ICU.1, LDO.3, PX4_FLOW.2, R19.P$1
5V_CONTINUOUS: Q3.S, R2.P$1, R4.P$1, R5.P$1, R6.P$1, R8.P$1, R9.P$1, R11.P$1, R13.P$1, U$1.5V, U$4.OUT+
5V_ICU: TO_ICU.1, U$2.VIN-_0, U$2.VIN-_1
5V_SCU: TO_SCU.5, U$8.VIN-_0, U$8.VIN-_1
7.4V: TO_ICU.2, U$3.VIN-_0, U$3.VIN-_1
ADC_1: U$11.V1, X2.3
ADC_2: U$11.V2, X2.4
CANH: TO_ICU.3, TO_SCU.3, U$6.CANH
CANL: TO_ICU.4, TO_SCU.2, U$6.CANL
CRX: CAN.CRX, PX4_FLOW.3
CTX: CAN.CTX, PX4_FLOW.4
DF_S_RX: X1.4, X3.2
DF_S_TX: X1.3, X3.8
DQ: R20.P$2, U$12.DQ, X2.1
GND: BAT-.1, HEATER_GND.1, LED1.K, P1.1, P1.3, T1.2, T2.2, T3.2, T4.2, T5.2, T6.2, TO_ICU.5, TO_SCU.1, U$1.GND0, U$1.GND1, U$1.GND2, U$1.GND3, U$2.GND, U$3.GND, U$4.IN-, U$4.OUT-, U$5.IN-, U$5.OUT-, U$6.GND, U$7.IN-, U$7.OUT-, U$8.GND, U$9.GND
GND1: C1.2, C2.2, CAM_DOWN.1, CAM_UP.1, CAN.GND, FROM_ICU.4, LDO.1, LED2.K, PX4_FLOW.1
GND2: C3.2, C4.2, IC1.1, JP7.1, U$11.GND, U$12.GND, U$13.GND, X1.8, X2.8, X3.3
HEATER_7.4V: HEATER_7.4V.1, Q10.D
KEY_1: BAT+.1, Q2.S, R10.P$1
KEY_2: Q1.S, Q2.D, Q10.S, R1.P$1, R3.P$1, U$4.IN+, U$5.IN+, U$7.IN+
KEY_MINUS: JP1.1, JP6.1
KEY_PLUS: JP2.1, JP8.1
KILLSWITCH: R11.P$2, T6.1, U$1.A9
MAG_CS: U$13.CSM, X2.2
unnamed: Q1.G, R3.P$2, T2.3
unnamed: U$1.A11, U$6.CRX
unnamed: Q5.G, R7.P$2, T4.3
unnamed: Q7.G, R12.P$2, T5.3
unnamed: Q5.S, R7.P$1, U$5.OUT+
unnamed: Q3.G, R5.P$2, T3.3
unnamed: Q7.S, R12.P$1, U$7.OUT+
unnamed: Q1.D, U$3.VIN+_0, U$3.VIN+_1
unnamed: Q3.D, U$9.VIN+_0, U$9.VIN+_1
unnamed: Q5.D, U$8.VIN+_0, U$8.VIN+_1
unnamed: Q7.D, U$2.VIN+_0, U$2.VIN+_1
unnamed: U$1.B11, U$2.SDA, U$3.SDA, U$8.SDA, U$9.SDA
unnamed: U$1.B10, U$2.SCL, U$3.SCL, U$8.SCL, U$9.SCL
unnamed: U$1.A12, U$6.CTX
unnamed: LED1.A, R9.P$2
unnamed: Q10.G, R1.P$2, T1.3
unnamed: R14.P$1, U$1.A0
unnamed: R15.P$1, U$1.A1
unnamed: R16.P$1, U$1.A2
unnamed: R17.P$1, U$1.A3
unnamed: R18.P$1, U$1.A4
unnamed: P1.2, Q2.G, R10.P$2, T6.3
unnamed: CAN.CANL, FROM_ICU.3
unnamed: CAN.CANH, FROM_ICU.2
unnamed: LED2.A, R19.P$2
unnamed: TO_OUT.8, TO_SCU1.8
unnamed: TO_OUT.7, TO_SCU1.7
unnamed: TO_OUT.6, TO_SCU1.6
unnamed: TO_OUT.3, TO_SCU1.3
unnamed: TO_OUT.2, TO_SCU1.2
unnamed: TO_OUT.1, TO_SCU1.1
unnamed: TO_SCU1.5, U$10.SCL
unnamed: TO_SCU1.4, U$10.SDA
unnamed: TO_OUT.5, U$10.A1
unnamed: TO_OUT.4, U$10.A0
PCTRL_AMP: R4.P$2, R18.P$2, T2.1
PCTRL_CCU: R6.P$2, R14.P$2, T3.1
PCTRL_HEATER: R2.P$2, R17.P$2, T1.1
PCTRL_ICU: R13.P$2, R16.P$2, T5.1
PCTRL_SCU: R8.P$2, R15.P$2, T4.1
PD7: X1.7, X3.5
RX1: CAM_UP.4, PX4_FLOW.8
RX2: CAM_DOWN.4, PX4_FLOW.6
RX_GPS: X1.6, X3.1
SCL: U$13.SCL, X2.5
SDA: U$13.SDA, X2.6
SWC: DEBUG.2, PX4_FLOW.9
SWCLK_0: DEBUG_TO_OUT.1, U$1.SWCLK
SWCLK_2: DEBUG_FROM_SCU.3, DEBUG_TO_OUT.4
SWCLK_3: DEBUG_FROM_SCU.1, DEBUG_TO_OUT.6
SWCLK_CCU: X1.9, X4.2
SWCLK_PCU: X1.13, X4.6
SWCLK_SCU: X1.11, X4.4
SWC_ICU: X1.1, X3.6
SWD: DEBUG.1, PX4_FLOW.10
SWDIO_0: DEBUG_TO_OUT.2, U$1.SWDIO
SWDIO_2: DEBUG_FROM_SCU.4, DEBUG_TO_OUT.3
SWDIO_3: DEBUG_FROM_SCU.2, DEBUG_TO_OUT.5
SWDIO_CCU: X1.10, X4.1
SWDIO_PCU: X1.14, X4.5
SWDIO_SCU: X1.12, X4.3
SWD_ICU: X1.2, X3.4
TX1: CAM_UP.3, PX4_FLOW.7
TX2: CAM_DOWN.3, PX4_FLOW.5
TX_GPS: X1.5, X3.7
