shostakovichs-spacecraft-factory/cansat-2018-2019/src/board/SCU_final/SW4STM32/SCU_final/Application/User/sensors.h

#ifndef SENSORS_H_
#define SENSORS_H_

#include "ds18b20.h"
#include "ads1x1x.h"
#include "bme280.h"

extern struct bme280_dev_s hbme;
extern ds18b20_config_t hds;
extern ADS1x1x_config_t hads;


//Read data from BME280 sensor and send scaled_pressure MAVLink message
void sensors_bme280_update(void);

//Read data from DS18B20 and MPX2100AP sensors and send scaled_pressure2 MAVLink message
void sensors_external_update(void);

#endif //#ifndef SENSORS_H_
