shostakovichs-spacecraft-factory/cansat-2018-2019/src/common/zikush_config.h

#ifndef ZIKUSH_CONFIG
#define ZIKUSH_CONFIG

/* Probe-wide params */
#define PROBEWIDE_CAN_TICKRATE	360000 //tickrate, not a bitrate. br = tr / (1 + 5 + 2) (according to current time quantum utilisation)



/* Params for ICU */
#define ICU_TASKS_HEARTBEAT_STACKSIZE 128
#define ICU_TASKS_HEARTBEAT_TASKPRIORITY	1

#define ICU_TASKS_ICU_STACKSIZE	512
#define ICU_TASKS_ICU_TASKPRIORITY	5
#define ICU_TASKS_ICU_QUEUE_SIZE	3 //defined in sizes of mavlink_msg_t

#define ICU_TASKS_CAN_STACKSIZE	512
#define ICU_TASKS_CAN_TASKPRIORITY	4
#define ICU_TASKS_CAN_QUEUE_SIZE	3 //defined in sizes of mavlink_msg_t

#define ICU_TASKS_SD_STACKSIZE	512
#define ICU_TASKS_SD_TASKPRIORITY	2
#define ICU_TASKS_SD_QUEUE_SIZE	6 //defined in sizes of mavlink_msg_t

#define ICU_TASKS_RADIO_STACKSIZE	512
#define ICU_TASKS_RADIO_TASKPRIORITY	4
#define ICU_TASKS_RADIO_QUEUE_SIZE	3 //defined in sizes of mavlink_msg_t

#define ICU_TASKS_GPS_STACKSIZE	512
#define ICU_TASKS_GPS_TASKPRIORITY	4

#define ICU_TASKS_CBBNE_STACKSIZE	512
#define ICU_TASKS_CBBNE_TASKPRIORITY	4 //FIXME handle

#define ICU_TASKS_IRIDIUM_STACKSIZE	2048
#define ICU_TASKS_IRIDIUM_TASKPRIORITY	5
#define ICU_TASKS_IRIDIUM_QUEUE_SIZE	3 //defined in sizes of mavlink_msg_t


#define ICU_IR_UART_RX_BUFFER_SIZE	200
#define ICU_IR_UART_RX_QUEUE_WAIT	((1*40*1000)/portTICK_PERIOD_MS)
#define ICU_IR_UART_TX_HAL_WAIT		((20*1000)/portTICK_PERIOD_MS)
#define ICU_IR_TX_ACCUMULATOR_SIZE		340
#define ICU_IR_TASK_PERIOD			((1*60*1000)/portTICK_PERIOD_MS)
#define ICU_IR_ROUTE_WAIT			((10*1000)/portTICK_PERIOD_MS)
#define ICU_IR_PROCESS_UPLINK		1
#define ICU_IR_UART_RX_IT_PRIO		14

#define ICU_SD_SESSFOLDERNAMEFMT	"0:/zikush/sess%04d"
#define ICU_SD_SESSNUMBOUNDARY	10000

#define ICU_SD_TELFILENAMEFMT	"0:/zikush/sess%04d/%s%02d.bin"

#define ICU_SD_MAXFILENAMELEN	32
#define ICU_SD_MAXFILELEN	4000000000

#define ICU_RADIO_RXBUFFLEN	1
#define ICU_RADIO_TXBUFFLEN	1024
#define ICU_RADIO_IRQ_PRIO	15

#define ICU_CAN_RXBUFFSIZE	68 //in sizes of CANMAVLINK_RX_FRAME_T
#define ICU_CAN_IRQ_PRIO	13

#define ICU_GPS_FORCECHECKSUMM	false
#define ICU_GPS_IRQ_PRIO	16

#define ICU_CBBNE_IRQ_PRIO	12
#define ICU_CBBNE_BAUDRATE	9600
#define ICU_CBBNE_BUFFLEN	1024 //in bytes
#define ICU_CBBNE_BUFFCOUNT	4
#define ICU_CBBNE_PERIOD_MS	300//in ms

/* Params for PCU */
#define PCU_INA_ICU_ADDR	INA219_I2CADDR_A1_GND_A0_VSP
#define PCU_INA_SCU_ADDR	INA219_I2CADDR_A1_VSP_A0_GND
#define PCU_INA_CCU_ADDR	INA219_I2CADDR_A1_VSP_A0_VSP

#define PCU_MEASFREQ_Hz	1

#define PCU_HEARTBEATSENDPERIOD_CYCL	1
#define PCU_CURRSENDPERIOD_CYCL	1
#define PCU_POWERSENDPERIOD_CYCL	10

#define PCU_CAN_TIMEOUT_MS	100



/* Params for CCU */
#define CCU_SPECTRUM_WIDTH	376
#define CCU_SPECTRUM_HEIGHT	240

#define CCU_SPECTRUM_Y_START	0
#define CCU_SPECTRUM_Y_END		240
#define CCU_SPECTRUM_X_START	0
#define CCU_SPECTRUM_X_END		376

#define CCU_DMA_IRQ_PRIO	0
#define CCU_CAN_IRQ_PRIO	1

#define CCU_TESTMODE	//Take picture every second and enable UART3 output


// params directly from Flow config. Better explanation could be found in datasheet
// TODO maybe we should implement on-the-fly parameters change?
#define CCU_SPECTRUM_PARAM_GAIN_MAX					16
#define CCU_SPECTRUM_PARAM_EXPOSURE_MAX				500
#define CCU_SPECTRUM_PARAM_SHTR_W_1					443
#define CCU_SPECTRUM_PARAM_SHTR_W_2					473
#define CCU_SPECTRUM_PARAM_SHTR_W_TOT				480
#define CCU_SPECTRUM_PARAM_HDR						1
#define CCU_SPECTRUM_PARAM_AEC						1
#define CCU_SPECTRUM_PARAM_AGC						1
#define CCU_SPECTRUM_PARAM_BRIGHT					20
#define CCU_SPECTRUM_PARAM_IMAGE_ROW_NOISE_CORR		1
#define CCU_SPECTRUM_PARAM_IMAGE_TEST_PATTERN		0

#define CCU_CBBNE_BAUDRATE ICU_CBBNE_BAUDRATE

#endif // #ifndef ZIKUSH_CONFIG
