shostakovichs-spacecraft-factory/cansat-2018-2019/src/board/SCU_real/src/high_level/sensors.c

/*
 * thread.c
 *
 *  Created on: 10 мая 2019 г.
 *      Author: sereshotes
 */

#include <stm32f4xx_hal.h>
#include "task.h"

#include "lsm6ds3.h"
#include "lsm303c.h"
#include "i2c.h"
#include "bme280.h"
#include "i2c.h"
#include "ads1x1x.h"
#include "mpx2100ap.h"
#include "ds18b20.h"
#include "spi.h"
#include <can.h>

#include "thread.h"

I2C_HandleTypeDef hi2c;
SPI_HandleTypeDef hspi2;
SPI_HandleTypeDef hspi3;
onewire_t how;

struct bme280_dev_s hbme;
ds18b20_config_t hds;
ADS1x1x_config_t hads;

struct lsm303c_handler_s hlsm3;
struct lsm6ds3_dev_s hlsm6;

#define SENSORS_SEND_FREQ 2

//Inits BME280, DS18B20, MPX2100AP (and also I2C1, OneWire and ADS1115 required for them)
void sensors_init(void)
{
	__GPIOA_CLK_ENABLE();
	__GPIOB_CLK_ENABLE();
	__GPIOC_CLK_ENABLE();
	__GPIOD_CLK_ENABLE();
	__SPI3_CLK_ENABLE();
	__SPI2_CLK_ENABLE();
	__I2C3_CLK_ENABLE();


/*
	{	//I2C1 (separately, cause it's used both by BME280 and MPX2100)
		GPIO_InitTypeDef pa_init;
		pa_init.Alternate = GPIO_AF4_I2C3;
		pa_init.Mode = GPIO_MODE_AF_OD;
		pa_init.Pin = GPIO_PIN_8;
		pa_init.Pull = GPIO_NOPULL;
		pa_init.Speed = GPIO_SPEED_FAST;

		HAL_GPIO_Init(GPIOA, &pa_init);

		pa_init.Pin = GPIO_PIN_9;
		HAL_GPIO_Init(GPIOC, &pa_init);
		HAL_GPIO_WritePin(GPIOA, GPIO_PIN_8, GPIO_PIN_SET);

		i2c_config_default(&hi2c);
		hi2c.Instance = I2C3;
		i2c_init(&hi2c);
	}*//*
	{

		GPIO_InitTypeDef pa_init;
		pa_init.Alternate = 0;
		pa_init.Mode = GPIO_MODE_OUTPUT_PP;
		pa_init.Pin = GPIO_PIN_13;
		pa_init.Speed = GPIO_SPEED_FAST;
		pa_init.Pull = GPIO_NOPULL;

		HAL_GPIO_Init(GPIOB, &pa_init);
		while(1)
		{
			HAL_GPIO_TogglePin(GPIOB, GPIO_PIN_13);
			HAL_Delay(50);
		}
	}*/
	{
		spi_config_default(&hspi2);
		hspi2.Instance = SPI2;
		spi_pin_miso_init(&hspi2, GPIOB, GPIO_PIN_14);
		spi_pin_mosi_init(&hspi2, GPIOB, GPIO_PIN_15);
		spi_pin_sck_init(&hspi2, GPIOB, GPIO_PIN_13);
		spi_pin_nss_init(&hspi2, GPIOB, GPIO_PIN_12);

		spi_init(&hspi2);
	}
	{
		while(1)
		{
			char str[] = "Hello\n";
			HAL_SPI_Transmit(&hspi2, str, sizeof(str), 100);
			HAL_Delay(50);
		}
	}
/*
	{
		spi_config_default(&hspi3);
		hspi3.Instance = SPI3;
		spi_pin_miso_init(&hspi3, GPIOC, GPIO_PIN_11);
		spi_pin_mosi_init(&hspi3, GPIOC, GPIO_PIN_12);
		spi_pin_sck_init(&hspi3, GPIOC, GPIO_PIN_10);
		spi_pin_nss_init(&hspi3, GPIOD, GPIO_PIN_2);

		spi_init(&hspi3);
	}
*/
	{	//BME280
		bme280_register_i2c(&hbme, &hi2c, BME280_I2C_ADDR_SDO_LOW << 1);
		bme280_init(&hbme);
	}
/*
	{	//DS18B20
		delay_us_init();

		onewire_Init(&how, GPIOB, GPIO_PIN_0);

		onewire_ReadRom(&how, &hds.rom);
		hds.resolution = ds18b20_Resolution_12bits;
		hds.how = &how;
		ds18b20_SetResolution(&hds, hds.resolution);
		ds18b20_Start(&hds);
	}

	{	//MPX2100AP
		ADS1x1x_config_default(&hads);
		ADS1x1x_register_i2c(&hads, &hi2c, ADS1x1x_I2C_ADDRESS_ADDR_TO_GND << 1);
		ADS1x1x_init(&hads);

		ADS1x1x_start_conversion(&hads);
	}

	{	//lsm303c
		lsm303c_m_conf_default(&hlsm3);
		lsm303c_register_i2c(&hlsm3, &hi2c);
		lsm303c_m_push_conf(&hlsm3, &hlsm3.conf.m);
	}

	{	//lsm6ds3
		lsm6ds3_conf_default(&hlsm6);
		lsm6ds3_register_spi(&hlsm6, &hspi3, GPIOD, GPIO_PIN_2);
		HAL_Delay(50); //FIXME do we need it?
		lsm6ds3_push_conf(&hlsm6);
	}

	mavlink_get_channel_status(MAVLINK_COMM_0)->flags |= MAVLINK_STATUS_FLAG_OUT_MAVLINK1;*/
}

//Read data from BME280 sensor and send scaled_pressure MAVLink message
void sensors_bme280_update(void)
{
	static uint32_t t_prev = 0, t_now;
	if((t_now = HAL_GetTick()) - t_prev < 1000 / SENSORS_SEND_FREQ)
	{
		return;
	}

	struct bme280_float_data_s data;
	mavlink_scaled_pressure_t scaled_pressure;
	mavlink_zikush_humidity_t humidity;
	mavlink_message_t msg;

	bme280_read(&hbme, (char*)&data, sizeof(struct bme280_float_data_s));

	scaled_pressure.time_boot_ms = HAL_GetTick();
	scaled_pressure.press_abs = data.pressure;
	scaled_pressure.temperature = data.temperature;
	mavlink_msg_scaled_pressure_encode(0, ZIKUSH_SCU, &msg, &scaled_pressure);
	can_mavlink_send(&msg);

	humidity.time_boot_ms = HAL_GetTick();
	humidity.humidity = data.humidity;
	mavlink_msg_zikush_humidity_encode(0, ZIKUSH_SCU, &msg, &humidity);
	can_mavlink_send(&msg);

	t_prev = t_now;
}

//Read data from DS18B20 and MPX2100AP sensors and send scaled_pressure2 MAVLink message
void sensors_external_update(void)
{
	task_begin(1000 / SENSORS_SEND_FREQ);

	float temperature;
	static mavlink_scaled_pressure2_t scaled_pressure;
	mavlink_message_t msg;

	if( ds18b20_Read(&hds, &temperature) )
	{
		scaled_pressure.temperature = temperature * 100;

		ds18b20_Start(&hds);
	}

	static previousConversionTime = 0;
	if(HAL_GetTick() - previousConversionTime >= 200)
	{
		uint16_t data = ADS1x1x_read(&hads);

		scaled_pressure.press_abs = mpx2100ap_compensate_pressure_flt(data);

		ADS1x1x_start_conversion(&hads);
		previousConversionTime = HAL_GetTick();
	}

	scaled_pressure.time_boot_ms = HAL_GetTick();

	mavlink_msg_scaled_pressure2_encode(0, ZIKUSH_SCU, &msg, &scaled_pressure);
	can_mavlink_send(&msg);

	task_end();
}
