shostakovichs-spacecraft-factory/cansat-2018-2019/src/ground/grain-server/connectorapp/streams_sink.py

import csv
import os

from pymavlink import mavutil
from pymavlink.dialects.v20.zikush import ZIKUSH_CAM_SPECTRUM, ZIKUSH_CAM_NADIR, ZIKUSH_CAM_ZENITH


class PictureAcceptor:
    def __init__(self):
        pass

    def accept(self, data, identifier):
        raise NotImplementedError


class PictureSaver(PictureAcceptor):
    def __init__(self, filename_template='spectrum/spectrum_%d_img.png'):
        super().__init__()

        self.filename_template = filename_template

    def accept(self, data, identifier):
        filename = self.filename_template % identifier

        if not os.path.exists(os.path.dirname(filename)):
            try:
                os.makedirs(os.path.dirname(filename))
            except OSError as exc:  # Guard against race condition
                if exc.errno != errno.EEXIST:
                    raise

        if identifier != 0:
            previous = self.filename_template % (identifier - 1)
            os.remove(previous)

        with open(filename, mode="wb") as output:
            output.write(bytes(data))
            output.flush()
            print("picture saved")


class PictureListener:
    DATA_PACKETS_COUNT = 0
    TOTAL_SIZE = 0
    WHOLE_DATA = []
    OUTPUT_DIR = ""
    number_of_whole_packages = 0
    state = "IDLE"

    def __init__(self, acceptor=PictureSaver()):
        self.acceptor = acceptor

    def accept_data(self, data, seqnr):
        self.WHOLE_DATA += data
        if seqnr == self.DATA_PACKETS_COUNT - 1:  # if last package
            self.WHOLE_DATA = self.WHOLE_DATA[:self.TOTAL_SIZE]
            self.number_of_whole_packages += 1

            self.acceptor.accept(self.WHOLE_DATA, self.number_of_whole_packages - 1)

            self.state = "IDLE"


class SpectrumAcceptor:
    def __init__(self):
        pass

    def accept(self, data, identifier):
        raise NotImplementedError


class SpectrumSaver(SpectrumAcceptor):
    def __init__(self, filename_template='spectrum/spectrum_%d.csv'):
        super().__init__()

        self.filename_template = filename_template

    def accept(self, data, identifier):
        with open(self.filename_template % identifier, mode="w", newline="") as ostream:
            fieldnames = ["nm", "intensity"]
            writer = csv.DictWriter(ostream, fieldnames)
            writer.writeheader()

            i = 0
            for el in data:
                nm = i
                intensity = el
                row = {"nm": nm, "intensity": intensity}
                writer.writerow(row)
                i += 1

            print("spectrum saved")


class SpectrumListener:
    DATA_PACKETS_COUNT = 0
    TOTAL_SIZE = 0
    WHOLE_DATA = []
    number_of_whole_packages = 0
    state = "IDLE"

    def __init__(self, acceptor=SpectrumSaver):
        self.acceptor = acceptor

    def accept_data(self, data, seqnr):
        self.WHOLE_DATA += data
        if seqnr == self.DATA_PACKETS_COUNT - 1:  # if last package
            self.WHOLE_DATA = self.WHOLE_DATA[:self.TOTAL_SIZE]
            self.number_of_whole_packages += 1

            self.acceptor.accept(self.WHOLE_DATA, self.number_of_whole_packages - 1)

            self.state = "IDLE"


class StreamAggregator:

    def __init__(self, spectrum_acceptor=SpectrumSaver(), picture_acceptor_spectrum=PictureSaver(), \
                 picture_acceptor_nadir=PictureSaver(filename_template='photo/nadir_%d.csv'), \
                 picture_acceptor_zenith=PictureSaver(filename_template='photo/zenith_%d.csv')):

        self.picture_listener_spectrum = PictureListener(acceptor=picture_acceptor_spectrum)
        self.picture_listener_nadir = PictureListener(acceptor=picture_acceptor_nadir)
        self.picture_listener_zenith = PictureListener(acceptor=picture_acceptor_zenith)

        self.picture_listener = None
        self.spectrum_listener = SpectrumListener(acceptor=spectrum_acceptor)
        self.picture_index_we_wait_for = 0
        self.spectrum_index_we_wait_for = 0

    def accept_message(self, msg):
        if self.picture_listener.state == "IDLE":  # ждем заголовка
            if msg.get_type() == "ZIKUSH_PICTURE_HEADER":  # получили заголовок картинки

                if msg.camid == ZIKUSH_CAM_SPECTRUM:
                    self.picture_listener = self.picture_listener_spectrum
                elif msg.camid == ZIKUSH_CAM_NADIR:
                    self.picture_listener = self.picture_listener_nadir
                elif msg.camid == ZIKUSH_CAM_ZENITH:
                    self.picture_listener = self.picture_listener_zenith

                self.picture_listener.WHOLE_DATA = []
                self.picture_index_we_wait_for = 0
                self.picture_listener.DATA_PACKETS_COUNT = msg.packets
                self.picture_listener.TOTAL_SIZE = msg.size
                self.picture_listener.state = "ACCUM"

        elif self.picture_listener.state == "ACCUM":  # ждем данных
            if msg.get_type() == "ENCAPSULATED_DATA":
                seqnr = msg.seqnr
                if seqnr < self.picture_index_we_wait_for:
                    pass

                elif seqnr > self.picture_index_we_wait_for:
                    lostpixelscount = 253 * (seqnr - self.picture_index_we_wait_for)
                    self.picture_listener.accept_data(data=[0] * lostpixelscount, seqnr=self.picture_index_we_wait_for)
                    self.picture_listener.accept_data(data=msg.data, seqnr=seqnr)

                    self.picture_index_we_wait_for = seqnr + 1

                elif seqnr == self.picture_index_we_wait_for:
                    self.picture_listener.accept_data(data=msg.data, seqnr=seqnr)

                    self.picture_index_we_wait_for += 1

        if self.spectrum_listener.state == "IDLE":  # ждем заголовка
            if msg.get_type() == "ZIKUSH_SPECTRUM_INTENSITY_HEADER":  # получили заголовок спектра
                self.spectrum_listener.WHOLE_DATA = []
                self.spectrum_index_we_wait_for = 0
                self.spectrum_listener.DATA_PACKETS_COUNT = msg.packets
                self.spectrum_listener.TOTAL_SIZE = msg.size
                self.spectrum_listener.state = "ACCUM"

        elif self.spectrum_listener.state == "ACCUM":  # ждем данных
            if msg.get_type() == "ZIKUSH_SPECTRUM_INTENSITY_ENCAPSULATED_DATA":
                seqnr = msg.seqnr
                if seqnr < self.spectrum_index_we_wait_for:
                    pass

                elif seqnr > self.spectrum_index_we_wait_for:
                    lostrecordscount = 126 * (seqnr - self.spectrum_index_we_wait_for)
                    self.spectrum_listener.accept_data(data=[0] * lostrecordscount, seqnr=self.spectrum_index_we_wait_for)
                    self.spectrum_listener.accept_data(data=msg.data, seqnr=seqnr)

                    self.spectrum_index_we_wait_for = seqnr + 1

                elif seqnr == self.spectrum_index_we_wait_for:
                    self.spectrum_listener.accept_data(data=msg.data, seqnr=seqnr)

                    self.spectrum_index_we_wait_for += 1


def main():
    connection = mavutil.mavlink_connection("udpin:0.0.0.0:11000")
    spectrumAggregator = StreamAggregator()

    while True:
        msg = connection.recv_match(blocking=True)
        print(msg)
        spectrumAggregator.accept_message(msg)


if __name__ == "__main__":
    main()
