shostakovichs-spacecraft-factory/cansat-2018-2019/src/board/SCU_final/SW4STM32/SCU_final/Application/User/ds18b20.h

/**
 * @author  Tilen Majerle
 * @email   tilen@majerle.eu
 * @website http://stm32f4-discovery.net
 * @link    http://stm32f4-discovery.net/2015/07/hal-library-06-ds18b20-for-stm32fxxx/
 * @version v1.0
 * @ide     Keil uVision
 * @license MIT
 * @brief   Library for interfacing DS18B20 temperature sensor from Dallas semiconductors.
 *	
\verbatim
   ----------------------------------------------------------------------
    Copyright (c) 2016 Tilen Majerle

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
    THE SOFTWARE IS PROVIDED "AS IS", WITHOUT WARRANTY OF ANY KIND,
    EXPRESS OR IMPLIED, INCLUDING BUT NOT LIMITED TO THE WARRANTIES
    OF MERCHANTABILITY, FITNESS FOR A PARTICULAR PURPOSE
    AND NONINFRINGEMENT. IN NO EVENT SHALL THE AUTHORS OR COPYRIGHT
    HOLDERS BE LIABLE FOR ANY CLAIM, DAMAGES OR OTHER LIABILITY,
    WHETHER IN AN ACTION OF CONTRACT, TORT OR OTHERWISE, ARISING 
    FROM, OUT OF OR IN CONNECTION WITH THE SOFTWARE OR THE USE OR
    OTHER DEALINGS IN THE SOFTWARE.
   ----------------------------------------------------------------------
\endverbatim
 */
#ifndef ds18b20_H
#define ds18b20_H 100

/**
 * @addtogroup TM_STM32Fxxx_HAL_Libraries
 * @{
 */

/**
 * @defgroup TM_DS12820
 * @brief    Library for interfacing DS18B20 temperature sensor from Dallas semiconductors - http://stm32f4-discovery.net/2015/07/hal-library-06-ds18b20-for-stm32fxxx/
 * @{
 *
 * With this you can read temperature, set and get temperature resolution from 9 to 12 bits and check if device is DS18B20.
 * 
 * Pin for STM32Fxxx is the same as set with @ref onewire library.
 *
 * \par Changelog
 *
\verbatim
 Version 1.0
  - First release
\endverbatim
 *
 * \par Dependencies
 *
\verbatim
 - STM32Fxxx HAL
 - TM ONEWIRE
 - TM GPIO
 - defines.h
\endverbatim
 */

#include "stm32f1xx_hal.h"

#include "onewire.h"

/* OneWire version check */
#if onewire_H < 100
#error "Please update TM ONEWIRE LIB, minimum required version is 2.0.0. Download available on stm32f4-discovery.net website"
#endif

/**
 * @defgroup ds18b20_Macros
 * @brief    Library defines
 * @{
 */

/* Every onewire chip has different ROM code, but all the same chips has same family code */
/* in case of DS18B20 this is 0x28 and this is first byte of ROM address */
#define DS18B20_FAMILY_CODE				0x28
#define DS18B20_CMD_ALARMSEARCH			0xEC

/* DS18B20 read temperature command */
#define DS18B20_CMD_CONVERTTEMP			0x44 	/* Convert temperature */
#define DS18B20_DECIMAL_STEPS_12BIT		0.0625
#define DS18B20_DECIMAL_STEPS_11BIT		0.125
#define DS18B20_DECIMAL_STEPS_10BIT		0.25
#define DS18B20_DECIMAL_STEPS_9BIT		0.5

/* Bits locations for resolution */
#define DS18B20_RESOLUTION_R1			6
#define DS18B20_RESOLUTION_R0			5

/* CRC enabled */
#ifdef DS18B20_USE_CRC	
#define DS18B20_DATA_LEN				9
#else
#define DS18B20_DATA_LEN				2
#endif

/**
 * @}
 */

/**
 * @defgroup ds18b20_Typedefs
 * @brief    Library Typedefs
 * @{
 */

/**
 * @brief  DS18B0 Resolutions available
 */
typedef enum {
	ds18b20_Resolution_9bits = 9,   /*!< DS18B20 9 bits resolution */
	ds18b20_Resolution_10bits = 10, /*!< DS18B20 10 bits resolution */
	ds18b20_Resolution_11bits = 11, /*!< DS18B20 11 bits resolution */
	ds18b20_Resolution_12bits = 12  /*!< DS18B20 12 bits resolution */
} ds18b20_Resolution_t;

typedef struct
{
	ds18b20_Resolution_t resolution;
	onewire_t *how;
	uint64_t rom;
} ds18b20_config_t;

/**
 * @}
 */

/**
 * @defgroup ds18b20_Functions
 * @brief    Library Functions
 * @{
 */

/**
 * @brief  Starts temperature conversion for specific DS18B20 on specific onewire channel
 * @retval 1 if device is DS18B20 or 0 if not
 */
uint8_t ds18b20_Start(ds18b20_config_t * hds);

/**
 * @brief  Starts temperature conversion for all DS18B20 devices on specific onewire channel
 * @note   This mode will skip ROM addressing
 * @retval None
 */
void ds18b20_StartAll(ds18b20_config_t * hds);

/**
 * @brief  Reads temperature from DS18B20
 * @param  *destination: Pointer to float variable to store temperature
 * @retval Temperature status:
 *            - 0: Device is not DS18B20 or conversion is not done yet or CRC failed
 *            - > 0: Temperature is read OK
 */
uint8_t ds18b20_Read(ds18b20_config_t * hds, float* destination);

/**
 * @brief  Gets resolution for temperature conversion from DS18B20 device\
 * @retval Resolution:
 *            - 0: Device is not DS18B20
 *            - 9 - 12: Resolution of DS18B20
 */
uint8_t ds18b20_GetResolution(ds18b20_config_t * hds);

/**
 * @brief  Sets resolution for specific DS18B20 device
 * @param  resolution: Resolution for DS18B20 device. This parameter can be a value of @ref ds18b20_Resolution_t enumeration.
 * @retval Success status:
 *            - 0: Device is not DS18B20
 *            - > 0: Resolution set OK
 */
uint8_t ds18b20_SetResolution(ds18b20_config_t * hds, ds18b20_Resolution_t resolution);

/**
 * @brief  Checks if device with specific ROM number is DS18B20
 * @param  *ROM: Pointer to first byte of ROM address for desired DS12B80 device.
 *         Entire ROM address is 8-bytes long
 * @retval Device status
 *            - 0: Device is not DS18B20
 *            - > 0: Device is DS18B20
 */
uint8_t ds18b20_Is(uint64_t ROM);

/**
 * @brief  Sets high alarm temperature to specific DS18B20 sensor
 * @param  temp: integer value for temperature between -55 to 125 degrees
 * @retval Success status:
 *            - 0: Device is not DS18B20
 *            - > 0: High alarm set OK
 */
uint8_t ds18b20_SetAlarmHighTemperature(ds18b20_config_t * hds, int8_t temp);

/**
 * @brief  Sets low alarm temperature to specific DS18B20 sensor
 * @param  temp: integer value for temperature between -55 to 125 degrees
 * @retval Success status:
 *            - 0: Device is not DS18B20
 *            - > 0: Low alarm set OK
 */
uint8_t ds18b20_SetAlarmLowTemperature(ds18b20_config_t * hds, int8_t temp);

/**
 * @brief  Disables alarm temperature for specific DS18B20 sensor
 * @param  *ROM: Pointer to first byte of ROM address for desired DS12B80 device.
 *         Entire ROM address is 8-bytes long
 * @retval Success status:
 *            - 0: Device is not DS18B20
 *            - > 0: Alarm disabled OK
 */
uint8_t ds18b20_DisableAlarmTemperature(ds18b20_config_t * hds);

/**
 * @brief  Searches for devices with alarm flag set
 * @retval Alarm search status
 *            - 0: No device found with alarm flag set
 *            - > 0: Device is found with alarm flag
 * @note   To get all devices on one onewire channel with alarm flag set, you can do this:
\verbatim
while (ds18b20_AlarmSearch(&OneWireStruct)) {
	//Read device ID here 
	//Print to user device by device
}
\endverbatim 
 * @retval 1 if any device has flag, otherwise 0
 */
uint8_t ds18b20_AlarmSearch(ds18b20_config_t * hds);

/**
 * @brief  Checks if all DS18B20 sensors are done with temperature conversion
 * @retval Conversion status
 *            - 0: Not all devices are done
 *            - > 0: All devices are done with conversion
 */
uint8_t ds18b20_AllDone(ds18b20_config_t * hds);

/**
 * @}
 */
 
/**
 * @}
 */
 
/**
 * @}
 */
 
#endif
