shostakovichs-spacecraft-factory/cansat-2018-2019/src/board/SCU_final/SW4STM32/SCU_final/Application/User/ahrs_system.h

#ifndef AHRS_SYSTEM_H
#define AHRS_SYSTEM_H

typedef enum {
	AHRSEST_NO,
	AHRSEST_ORI_ONLY,
	AHRSEST_ORI_TRAJ,
} ahrs_exec_status_t ;

typedef enum {
	AHRSSST_NO,
	AHRSSST_ORI_ONLY,
	AHRSSST_ORI_TRAJ,
} ahrs_send_status_t;


typedef enum{
	AHRSRQ_STOP,
	AHRSRQ_GO_ORI_ONLY,
	AHRSRQ_GO_FULL,
	//AHRSRQ_GET_
} ahrs_request_t;

extern ahrs_exec_status_t ahrs_exec_status;
extern ahrs_send_status_t ahrs_send_status;

extern struct lsm6ds3_dev_s hlsm6;
extern struct lsm303c_handler_s hlsm3;

void ahrs_system_update();
void ahrs_system_init();

#endif
