shostakovichs-spacecraft-factory/cansat-2018-2019/src/board/SCU_final/SW4STM32/SCU_final/Application/User/mpx2100ap.h

/*
 * mpx2100ap.h
 *
 *  Created on: 10 мая 2019 г.
 *      Author: sereshotes
 */

#ifndef MPX2100AP_H_
#define MPX2100AP_H_

#include <stdint.h>
float mpx2100ap_compensate_pressure_flt(int16_t raw_data);



#endif /* MPX2100AP_H_ */
