shostakovichs-spacecraft-factory/cansat-2018-2019/src/board/SCU_final/SW4STM32/SCU_final/Application/User/quaternion.h

/*
 * quaternion.h
 *
 *  Created on: 01 нояб. 2017 г.
 *      Author: developer
 */

#ifndef MADGWICK_QUATERNION_H_
#define MADGWICK_QUATERNION_H_

#include "matrix.h"

typedef struct {
	double x, y, z;
} vector_t;

typedef struct {
	double w, x, y, z;
} quaternion_t;


quaternion_t quat_getConj(quaternion_t *a);
quaternion_t quat_mulByNum(quaternion_t * a, double k);
double quat_getNorm(quaternion_t * a);
void quat_normalize(quaternion_t * a);
quaternion_t quat_getInverted(quaternion_t * a);
quaternion_t quat_mulByQuat(quaternion_t * a, quaternion_t * b);
quaternion_t quat_mulByVec(quaternion_t * a, vector_t * b);
vector_t vec_rotate(vector_t * vect, quaternion_t * rotation);
void vec_normalize(vector_t *vec);

void quat_add(quaternion_t *left, quaternion_t *right);
void quat_sub(quaternion_t *left, quaternion_t *right);


int vecToMatrix(Matrixf *result, vector_t *vec);
int quatToMatrix(Matrixf *result, quaternion_t *quat);
void quatToEulerAngle(quaternion_t *q, double *roll, double *pitch, double *yaw);
quaternion_t vecToQuat(vector_t *vec);
int matrixToQuat(quaternion_t *result, Matrixf *m);

quaternion_t quat_zero();
quaternion_t quat_init(double w, double x, double y, double z);


vector_t vec_init(double x, double y, double z);
vector_t vec_zero();

void quat_print(quaternion_t *a);

#endif /* MADGWICK_QUATERNION_H_ */
