shostakovichs-spacecraft-factory/cansat-2018-2019/src/board/SCU_final/SW4STM32/SCU_final/Application/User/Time.h

/*
 * Time.h
 *
 *  Created on: 10 мая 2019 г.
 *      Author: sereshotes
 */

#ifndef TIME_H_
#define TIME_H_

#include <stdint.h>
void delay_us(uint32_t us);


void delay_us_init(void);

#endif /* TIME_H_ */
