shostakovichs-spacecraft-factory/cansat-2018-2019/src/board/SCU_final/SW4STM32/SCU_final/Application/User/madgwick.h

/*
 * ahrs.h
 *
 *  Created on: 31 мар. 2019 г.
 *      Author: sereshotes
 */

#ifndef MADGWICK_H_
#define MADGWICK_H_

#include "matrix.h"
#include "quaternion.h"

//Calculates noise error in orientation based on vector approaching (see gradient method)
int madgwick_getErrorOri(quaternion_t *result, vector_t *real[], vector_t *measured[], float portions[], int count, quaternion_t *previous);

//Calculates resulted orientation
int madgwick_getEstimatedOri(quaternion_t *result, quaternion_t *gyroDerOri, quaternion_t *error, float dt, float koef_B, quaternion_t *previous);

//Calculates derivative of orientation based on gyro data without bias drift
int madgwick_getGyroDerOri(quaternion_t *result, vector_t *gyro_data, float dt, quaternion_t *previous);
#endif /* MADGWICK_H_ */
