shostakovichs-spacecraft-factory/cansat-2018-2019/(commit log)

2018-10-16 Папочка для моделей
2018-10-19 Add files via upload
    Часть деталек для тестов и замоделенная начинка
2018-10-21 Шестерни
    Тестовые шестерни, к сожалению только в STL
    [Gear10.stl, Gear20.stl]
2018-10-21 Пара изменений
2018-11-16 Код поиска Солнца для модели
2018-11-16 Код теста фильтра Маджвика с прошлого года
    [theplane.stl]
2018-11-17 В тесте маджвика магнитометр на I2C
2018-11-17 Раскопана последняя версия дамппроцессора для теста маджвика
2018-11-17 Фоторезистор вынесен в отдельный модуль
2018-11-17 Добавление кода поиска солнца
    Этот код может искать солнце! Надо только создать экземпляр класса и
    вызвать соответствующий метод, прямо как в примере.
2018-11-17 Изменение порядка сенсоров
2018-11-17 Начато добавление солнца в отображалку теста маджвика
2018-11-23 добавили тестовый проект для сериал порта на линуксе
2018-11-23 Reworked attitude data viewer, started writing of main model code
    [unpack.py]
2018-11-28 Создание интерфеса неспектральных камер
    Создан интерфейс для работы с uart под linux.
    Пока что нет способа изменить конфигурацию без перекомпиляции программы.
    Создан интерфейс для работы с камерами.
    Это прототип, так как не способен работать. Некоторые функции не
    подходят для работы на борту. Пока нет способа менять концигурацию во
    время выполения программы. Известные баги:
    - Не рабо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
2018-11-29 Исправление ошибок
    - Наименование функции чтения изображения camera_get_and_save_picture
    изменена на camera_load_and_save_picture.
    - Теперь все функции делают то, что от них хотят.
    - Увеличен размер строки имени файла для уарта на 1.
    [camera_interface.c, camera_interface.h, main.c, my_uart.c]
2018-11-29 Удалаение пары файлов
    Случайно добавились лишние файлы. Пытаюсь заставить гит их
    игнорировать.
2018-12-08 Добавление пары функции для удобной работы на миникомпьютере Рнаьше была лишь одна функция для сохранения изображения. Она загружала и сразу сохраняла его, занимая все процессорное время. Теперь есть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
2018-12-11 ТЗ стало похоже на рыбу
2018-12-11 Добавлвены требования к надежности (их нет) Добавлены требования к живучести НИП-а Поправлена структура ТЗ
2018-12-11 Добавлвены требования к надежности (их нет) Добавлены требования к живучести НИП-а Поправлена структура ТЗ титульник и заключительный лист
2018-12-22 Наработки Арины для схемы
    [psu_board.brd, psu_board.sch]
2018-12-22 Добвлена схема протоколов
    Эта штука будет необходима для "описания протоколов взаимодействия интерфейса".
2018-12-28 Реструткуризация иглового проекта
    [psu_board.brd, psu_board.sch]
2018-12-28 Добавление описания взаимодействия протоколов
    В целом, описано, где какой протокол используется. Есть пара элементов, которые стоило бы доделать. Также не уверен в необходимости описания самих протоколов. Поэтому их тут нет.
2018-12-28 Обновление описания протоколов
    Добавлены абоненты.
    Новая картиночка
2018-12-28 Обновление схемы протоколов
    Сделал схему красивее
2018-12-28 Новая цветовая гамма схемы протоколов
2018-12-29 Полная переработка описания протоколов
    Все переделано с учетом всех замечаний
2018-12-30 Немножко орфографии на тему #18
2019-01-03 Мелкие изменения
    Новая цветовая гамма. Добавлена главная страница. Маленькие корректировки.
2019-01-05 Сделана плата надирного этажа (не считая разъёмов)
    [psu_board.brd, psu_board.sch]
2019-01-06 Squashed commit of the following:
    commit bbe75f2ba636e86ea759fc0c795d406c2297ca99
    Author: Kirs67 <kirilel200267@gmail.com>
    Date: Mon Jan 7 01:16:28 2019 +0300
    Исправлена INA
    commit 84fcf59dae87e7c5b0b953ea137079167e3747d4
    Author: Kirs67 <kirilel200267@gmail.com>
    Date: Mon Jan 7 00:40:04 2019 +0300
    Добавлена схема выключения
    commit 4c991518a2578b81abe136c16c09ad2ddfd2125b
    Author: Kirs67 <kirilel200267@gmail.com>
    Date: Sun Jan 6 23:47:41 2019 +0300
    Добавлена поддержка USB type C
    [psu_board.brd, psu_board.sch]
2019-01-09 Модель аппарата на момент 09.01.19
    apparat.asm -- сборка аппарата, остальное -- его элементы
2019-01-10 Сборка перенесена на своё место
    [Gear10.stl, Gear20.stl]
2019-01-10 Добавил протокол совещания (!) от 10.01.18
2019-01-11 Рыба презентации и работа со схемами
2019-01-11 Добавлена схема платы SCU
    [scu_board.sch]
2019-01-11 Правки рыбы презентации
2019-01-11 Комментарии в презентации по обсуждениям
2019-01-11 Протокол совещания от 11.01.19
2019-01-14 Платка для отладки радиомодуля
    [e22-breakout.brd, e22-breakout.sch]
2019-01-14 Визуальное улучшение
    Я познал красоту. Теперь вы можете увидеть, насколько стало яснее, приятнее и точнее.
2019-01-15 Допилы брейкаута для радио и брейкаут для иридиума
    [e22-breakout.brd, e22-breakout.sch, iridium-9602-breakout.brd, iridium-9602-breakout.sch]
2019-01-15 Платка для антенны иридиума
    [iridium-by-262-breakout.brd, iridium-by-262-breakout.sch]
2019-01-15 собираем все платы в один шаблон
    [devboards-panel.brd, e22-breakout.brd, e22-breakout.sch, iridium-9602-breakout.sch, iridium-by-262-breakout.brd, iridium-by-262-breakout.sch]
2019-01-16 Мелкие правки перед отправкой на изготовление
    [devboards-panel.brd, iridium-9602-breakout.brd]
2019-01-16 Нашелся первый косяк на платах
    [devboards-panel.brd, iridium-by-262-breakout.brd, iridium-by-262-breakout.sch]
2019-01-16 "Структурная" схема и правки названий в схеме соединений
2019-01-16 ТЗ на ОКР считать готовым
2019-01-16 Правка орфографии
2019-01-16 Одно большое ТЗ разбито на три ТЗ поменьше. Ожидается четвертое и пятое на лаптоп и сервер-ретранслятор?
2019-01-17 Красивые переименования
2019-01-18 Косяки с вложенностью разделов
2019-01-18 Мелкие правки орфогравии по старым ТЗ и новое ТЗ на ПО ноута
2019-01-18 Схемы за последнее время
    [bombidary.sch, ccu_board.sch, icu_board.sch]
2019-01-18 Орфография по ТЗ на ПО для ноута и ТЗ для сервера
2019-01-18 Орфография везде
2019-01-28 Около финальная версия
    - Добавлены ссылки.
    - Добавлен пункт общего взаимодействия для создания общей картины у читающего.
2019-01-28 Малые корректировки
    - Удалено "LoRaWan"
    - Малые корректировки
2019-01-28 не туда
2019-01-28 Малые корректировки
2019-01-28 Исправлены замечания Вячеслава по ТЗ, кроме пункта 5 замечаний по СЧ ОКР Зонд Некоторые другие исправления ТЗ Исправленная схема электроники
2019-01-28 Приведены в порядок индексы изделий
2019-01-29 Предфинальная правка
    Добавлена нумерация.
    Новые главы начинаются с нового листа
    Добавлена штука как в титульных дистах других документов
2019-01-29 RC платок аппарата
    [ccu_board.sch, icu_board.sch, psu_board.sch, scu_board.sch]
2019-01-30 Актуальная версия сборки в виде архива
2019-01-30 Финальная версия на ниточке
    - Исправление ISU на ICU
2019-01-30 Финальная версия
2019-01-30 обновления схемы работы спектрометра
2019-01-30 удалено лишнее
    [psu_board.brd]
2019-01-30 приложения к ПЗ теперь в порядке
2019-02-03 Финальные версии документов (или почти?)
    [psu_board.sch]
2019-02-03 И пдф финальных версий тоже
2019-03-16 Оптимизация и разделение
    Было решено отказаться от динамических массивов в пользу более статитических.
    Сделано это было довольно интересным способом. При деинициализации матрицы
    теперь массив не стирается, тем самым не требуется каждый раз аллочить матрицу.
    Теперь появился отдельный модуль для работы поиска направления лучей света.
2019-03-24 Изменение идеалогии и исправления ошибок
    Теперь вся память контролируется пользователем, кроме памяти под матрицу,
    временно использумой в функции нахождения обратной матрицы (Она в стеке
    хранится, если что).
    Добавлена функция matrix_at, которая увеличивает независимость реализации
    хранимых данных от логики матриц.
    Исправлена ошибка, отмеченная Кириллом (есть ли какие-то встроенны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
    [Light_direction_determinant.c, Light_direction_determinant.h, main.c, matrix.c, matrix.h]
2019-03-24 Рефакторинг функций матриц и добавление деинициализации LDR
    Функции транспозиции и инверсс теперь принимают лишь один параметр и
    соотвественно результат остается в этом же параметре. Код стал выглядеть
    приятно.
    Появилась деинициализация LDR. Нам будет не хватать сотен мегабайт
    неосвобожденной памяти.
2019-03-24 Редактирование имен функций под мой вкус
2019-03-26 Added project for CCU and started porting Flow' code to HAL
2019-03-30 Добавление инициализации матрицы
    Так как все равно почти всегда будет использоваться динамические
    массивы для матриц, было решено сделать для этого отдельные функции.
    Так что теперь матрицы стали похожи на std::vector<> из c++
2019-03-30 Исправлние ошибок, добавление функций
    Исправлены ошибки, из-за которых предыдущая версия не компилилась.
    Добавлены функции сложения матрицы, и нахождения нормы.
    Причесан файл matrix.h. Он стал более читаемым.
    [matrix.c, matrix.h]
2019-03-30 Создание модуля AHRS
    Без комментариев
2019-03-30 Начата работа над платами Design-block iridium ICU МК Начал переделывать схему ICU
    [IRIDIUM.brd, icu_board.brd, icu_board.sch, psu_board.sch]
2019-04-05 добавлены технологические правила резонита
2019-04-05 сделан CAN трансивер
2019-04-06 Изменение всего в Маджвике, добавление кватернионов и +функция в матрицах
    Скопировал кватернионы у Кирилла, добавил пару функций, и изменил
    навзания старых. Также исправил функцию инверсии.
    Связал вместе матрицы, векторы и кватернионы функциями конверсии.
    Добавил функцию в матрицы для проверки размеров функции.
    Заменил везде AHRS на madgwick для добваления нового модуля в будущем.
    Т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
    [madgwick.c, madgwick.h, main.c, matrix.c, matrix.h, quaternion.c, quaternion.h]
2019-04-06 Перемещение модулей
    Для AHRS выделена отедьная папкаь, чтобы не названия не путали людей.
2019-04-06 Переещение исходников в src/
2019-04-06 Написан модуль ahrs и изменен маджвик
    Модуль ahrs - приятная прослойка между Маджвиком и пользователем.
    Так что теперь не надо будет понимать, что происходи. Все приятно и
    красиво.
2019-04-06 Sitched to HAL and CubeMX on ICU, started writing sx1262 driver
2019-04-06 Рабочая версия (возможно)
    Испарвлено все, что могло быть исправлено. Теперь ahrs работает,
    как и обычный маджвик по крайней мере для связки accel+mag. Гироскоп
    и свет будет теститься в далнейшем.
    [MadgwickAHRS.c, MadgwickAHRS.h, ahrc.c, ahrs.h, madgwick.c, main.c, quaternion.c, quaternion.h]
2019-04-07 Добавлена библиотека с разьёмами для игла Design-block иридиума Вроде готовая схема ICU, но её нужно проверить и причесать
    [IRIDIUM.brd, icu_board.sch]
2019-04-10 Готовая плата ICU. Стоит посмотреть ещё раз и проверить
    [icu_board.brd, icu_board.sch]
2019-04-10 Continued work on sx1268 transceiver driver
2019-04-12 Добавил шаблон для CAM задачи для подготовки исходных данных для Резонита
2019-04-12 Добавил либу SparkFun Идёт работа над CCU и SCU
    [ccu_board.brd, ccu_board.sch, out_board.sch, scu_board.brd, scu_board.sch]
2019-04-12 Прихорошил плату ICU
    [icu_board.brd]
2019-04-13 Ведётся работа по платам. Готовы SCU и CCU
    [ccu_board.brd, ccu_board.sch, scu_board.brd, scu_board.sch]
2019-04-13 Исправление заливки в символах нашей библиотеки
    А еще удаление оттуда иридиума и исправление SCU
2019-04-13 Продолжается работа над платами. Обновлены компоненты в библиотеках - удалены полигоны в TPLACE. Обновлены компоненты на некоторых платах
    [icu_board.brd, icu_board.sch]
2019-04-19 Скоро будут готовы ICU, SCU и CCU. Остались последние проверки
    [icu_board.brd, icu_board.sch, out_board.sch, psu_board.sch]
2019-04-19 CCU и ICU полностью готовы. Было бы здорово, если бы ещё кто-то посмотрел По SCU требуются уточнения
    [ccu_board.brd, ccu_board.sch, icu_board.brd, icu_board.sch, scu_board.brd, scu_board.sch]
2019-04-20 ICU готова, SCU скоро доделаю, пока что там всё не очень В либу добавлен LSM303C
    [icu_board.brd, icu_board.sch, scu_board.brd, scu_board.sch]
2019-04-21 Готова SCU и поправил lsm303c в либе
    [scu_board.brd, scu_board.sch]
2019-04-23 Правильные технологические правила
2019-04-23 "порядок" в библиотеках
2019-04-24 Подготовка плат к производству
    [ccu_board.brd, ccu_board.sch, icu_board.brd, icu_board.sch, scu_board.brd, scu_board.sch]
2019-04-24 Платы отправлены на завод
    [icu_board.brd, panel-icu-scu.brd, scu_board.brd, scu_board.sch]
2019-04-25 Working with transceiver (still not working)
    [main.c, main.h]
2019-04-26 Попытки пробудить радио
2019-04-26 Начата работа над PCU и в частности над инами
2019-04-26 Реализация I2C на прерываниях не выдерживает критики. В остальном скорее работает, чем нет
2019-04-27 Initial commit + bme280
    Добавлен модуль для работы с BME280. Он на 90% рабочий, но это не
    точно.
2019-04-27 На этом драйвер для ины готов
2019-05-02 Проект под наземку
2019-05-02 Сделана платка PCU, осталось развести. Добавлена ещё одна либа для игла
    [psu_board.sch]
2019-05-03 A bit of refactoring for sx1268 driver
2019-05-03 Finally finished with PCU. Pls check it
    [psu_board.brd, psu_board.sch]
2019-05-03 Гораздо больше работоспособности чем ранее
2019-05-04 Гораздо более рабочая версия. Вроде даже способна получать сообщения от гейтвея, но интерфейсы еще не проработаны
2019-05-04 Создан модуль для внутреннего ацп и ADC1x1x (скопирован)
    Ничего не работает! BME не работает. I2C не работает!
2019-05-04 Мелкие украшательства
2019-05-04 Ported sx1268 driver tor RPi
2019-05-04 Крупные украшательства
2019-05-04 Работа над MT сообщениями
2019-05-05 Украшательства и исправления
2019-05-05 Немного удобства
2019-05-05 Наброски бортового модуля для взаимодействия с модемом
2019-05-07 Отправка MT сообщений работает!
2019-05-07 Что-то начинает прояснятся в структуре драйвера
2019-05-07 Забытый комментарий
2019-05-08 Возвращена работоспособность BME280
    Оказалось, что проблема была с фдресом устройства. Опять. Баг
    пофиксен, все работает.
2019-05-08 Правки по PSU
    [psu_board.brd, psu_board.sch]
2019-05-08 Доулучшен код для ads
    Теперь все работает!!!!
2019-05-08 Причесал ads1x1x под единный стиль
2019-05-08 Добавлены некоторые события и они даже парсятся
2019-05-09 Добавлена плата АЦП на CCU Сделана и разведена внешняя плата Кое-что сделал в либе
    [ccu_board.brd, ccu_board.sch, out_board.brd, out_board.sch, psu_board.brd, scu_board.brd]
2019-05-09 Парсилка событий теперь на что-то похожа
2019-05-09 Убаны "лишние" команды
2019-05-10 Все платы готовы и отправлены в резонит
    [out_board.brd, out_board.sch, panel-ccu-pcu-out.brd, panel-out-pcu-ccu.brd, psu_board.sch]
2019-05-10 Transceiver driver finally works!
2019-05-10 Добавлены модули 1wire, ds18b20, Time
    1wire и ds18b20 скопированы и подстроенны под нашу систему по
    лицензионному соглашению.
    Модуль Time вмещает в себя функцию для delay в микрсекундах.
2019-05-10 Подгтовил под весенний показ + эксперимент с тредами
    Просто замените CAN_Send на вашу функцию. Не уверен, что это все
    вообще работает - не проверял.
2019-05-11 Похоже, что это конец асинхронной идее
2019-05-12 SCU should (in theory) send telemetry to CAN bus
2019-05-12 Исправил баг с Hard fault
    [main.c]
2019-05-14 Исправил библиотеку Осталось исправить внешнюю плату и сделать плату под антенну GPS
    [ccu_board.brd, ccu_board.sch, icu_board.brd, icu_board.sch, psu_board.brd, psu_board.sch, scu_board.brd, scu_board.sch]
2019-05-19 Started works on MCC (based on last year' MCC)
    [cansat.stl, rocket.stl]
2019-05-25 Working on ground station
2019-05-25 Completed little redesign&refactoring of webapp, tried to add auth so we can issue commands from webapp
    [__main__.py]
2019-06-01 Revert "Исправил баг с Hard fault" для merge с master
    This reverts commit 8a484a2888c4e78c6988b34562b8a6c1124a83ff.
    [main.c]
2019-06-01 Переделал драйвер Василия
2019-06-06 Драйвер для lsm6ds3 теперь работает
    - Пофиксин баг в коде Василия.
    - Выбраны удобные стандартный настройки.
    - Правильно настроен SPI.
2019-06-07 Initial commit для lsm303c
2019-06-07 Магнитометр работает!
2019-06-10 Added TXEN and RXEN control to sx1268 driver
2019-06-12 Добавлена жесткая калибровка магнитометра
2019-06-12 Подключил Маджвика (неуспешно)
2019-06-13 Dealed with small bug in radio reception code, minor changes to ground station (adopted to changes in redis-py and (I hope) fixed an issue with charts jumping in time)
    [__main__.py, main.c]
2019-06-14 Новый метод калибровки магнитометра
    Новый метод основан на приведении уравнения поверхности второго
    порядка к каноническому виду. В теории должно быть точнее, но данная
    реализация очень сильно зависит от того, как сильно "размазанны" по
    сфере показания магнитометра.
2019-06-14 Что-то по платам
    [copper_bottom.gbr, copper_top.gbr, drills.xln, gerber_job.gbrjob, profile.gbr, silkscreen_bottom.gbr, silkscreen_top.gbr, soldermask_bottom.gbr]
2019-06-15 GCS plate ready
    [GCS.brd, GCS.sch]
2019-06-19 CCU code right before simplification (stiill doesn't work)
    [dcmi.c, mt9v034.c, usart.c, zikush_config.h]
2019-06-19 CCU rewrited with better simplicity, but slightly more memory consumption and lower speed (doesn't account for our purpose) CCU definetely receives photos, but their transmission (either through USAR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
    [dcmi.c, dcmi.h, main.c]
2019-06-20 CCU camera part ready
2019-06-21 Скопирован код под камеры из research
    Этот код частично адаптирован. С камерой есть связь, но слегка ломаная.
2019-06-24 Камера заработала
2019-06-24 Переместил код камеры
2019-06-24 Почти ок код под камеры
2019-06-25 Перемещение .h файлов в одну папку
2019-06-25 Fixed bugs, so ICU project compiles
    [can.c, interrupts.c, main.c, radio.c, router.h, sd.c, zikush_config.h]
2019-06-25 Иридиум начал переезжать на ICU
2019-06-26 Либа для иридиума интегрирована в борт
2019-06-26 Теперь точно интегрирована
2019-06-27 Cleaned all the mess in CCU and added board-wide CAN tickrate setting (not implemented on SCU, cause it's still VERY messy)
2019-06-27 Работа над иридиумом
2019-06-27 Почти готово?
2019-06-27 Налажен приоритет прерываний USART в таске иридиума
2019-06-28 Ловля багов и больший размер стека для задачи иридиума
2019-06-28 Баги пойманы
2019-06-28 Опечатка
2019-06-29 Refactored SCU Only environmental sensors in a main(), we still need to deal with inertial navigation system
2019-06-29 Попытка заставить работать маджвик пока безуспешна
2019-06-29 В драйвер для радио добавлен хук на отправку пакета для их подсчета
2019-06-29 Рабочий маджвик на минималках
2019-06-29 Добавлена глобальная структура для подсчета пакетов в ICU
2019-06-29 Добавлен роутинг на иридиум и отправка ICU_STATS
2019-06-29 Команда на управление делителем отправки иридиума и её обработка в ICU; изменение ICU_STATS
2019-06-29 В драйвер для иридиума добавлен функционал для чтения входящих сообщений
2019-06-29 Более безопансные значения конфига для иридиума (на всякий случай)
2019-06-29 Баги и обработка входящих сообщений с иридиума
2019-06-29 Один минибаг в роутере убит и предотвращена рассылка входящих сообщений на шину
2019-06-29 Предотвращена гонка при отправки статистики
2019-06-29 Иридиевый таск и хартбит возвращен к запуску Все хэндлы инициализированны в NULL Увеличен стэк heartbeat таска (теперь ему не хватит минимума) Добавлен более осторожный роутинг на случай, если какие-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
2019-06-29 Иридиевый таск не попытается отправлять пустое сообщение (но возможно повторно вышлет то, что уже лежит в модеме)
2019-06-29 Иридиевый таск не затрет входящее сообщение в очереди, если к нам придет "вхоядщее" сообщение с неба
2019-06-30 Иридиевый таск флушит RX буфер перед начало SBD сессии, чтобы смыть оттуда потенциально накопленный мусор
2019-07-01 Маджвик работает классно
2019-07-01 Наловлены баги в иридиуме
2019-07-01 Иридиум финализирован
2019-07-01 Debugging stuff - revert later
    [can.c, main.c]
2019-07-02 Написан настоящий код под SCU
    - Все атмосферные датчики самостоятельно отправляют данные.
    - Добавлен триггер нулевой графитации для фотографирования.
    - Данные ahrs вычисляются и отправляются раздельно.
    - Присутствуют заготовки для внешнего контролирования работы датчиков.
2019-07-02 Дописан код для отправки фоточек
2019-07-02 Код под камеры встроен и типа должен работать
    Отвечаю
2019-07-02 Fixed and improved CAN communication
    [can.c, canlink.c, gps.c, hal_msp.c, main.c, radio.c, spectrum.c, zikush_config.h]
2019-07-02 Trying to fix CAN
    [can.c, canlink.c, gps.c, heartbeat.c, icu.c, iridium.c, main.c, radio.c]
2019-07-02 Обновил код на случай проблем с CCU + убрал printf
2019-07-02 Убрал мусор
2019-07-02 Работа над mav ретранслятором
2019-07-02 /bin/bash круче чем /bin/sh
2019-07-02 Improved bombidary-radio and added routing rule for non-board originated messages to CAN
2019-07-02 На грейне питон то 3.5, а не 3.7
2019-07-02 Формат лога правильный
2019-07-03 Рабочий код. Плак
2019-07-03 BME280 написан под SPI
2019-07-03 Исправление разных багов
2019-07-03 Новый проект под новое SCU
2019-07-03 BME280 и DS18B20 похожи на работающих
2019-07-03 ADS1115 тоже похож на рабочий
2019-07-03 lsm6ds3 присоединяется к коллективу "работающих"
2019-07-03 CAN может!
2019-07-03 забытые файлы
2019-07-03 Делаем красоту
2019-07-03 Временный коммит
2019-07-03 Врменный коммит
2019-07-03 bme280 теперь точно работает
2019-07-03 Все датчики проверены
2019-07-03 Все готово для проверки в полной системе - Интегрировал mavlink+can - Добавил магнетометр и ahrs
2019-07-03 Подправил пару мелочей
2019-07-04 Added camera backbone
2019-07-04 Вот это было зашито в полёте
