shostakovichs-spacecraft-factory/cansat-2018-2019/(notices)

Notices in the files:
src/board/SCU_final/Inc/main.h:
This software component is licensed by ST under BSD 3-Clause license,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
parts and their libraries:
con-jst-eh: Copyright (C) 2016, Bob Starr
SparkFun-Capacitors: Licensing: Creative Commons ShareAlike 4.0 International - https://creativecommons.org/licenses/by-sa/4.0
